daniel-streetec/open_loud/README.md

# OPEN//LOUD

Tragbarer DIY-Outdoor-Lautsprecher. Entwicklungsstand: **Vorentwurf, keine Bau- oder Sicherheitsfreigabe**.

Geprüfte Grundlage E05: Verkabelungsrechnung und modellierte Befestiger, geprüfte STEP/F3D-Rückimporte,28-seitiger CAD-Prüfzeichnungssatz. Akku-/Festivalversorgung, vollständige Anschluss-/Schutzkette, fertig bemaßte Fertigungszeichnungen und abschließende Gestaltung bleiben in Arbeit; neuester Status in docs/NEXT_SESSION.md. Die lokal bereitgestellte Forschungs-PDF wird wegen ungeklärter Weitergaberechte nicht mitgepusht. Ihr Hash ist dokumentiert, die Rechengeneratoren laufen auch ohne die PDF.

Startpunkt ist der vom Nutzer bereitgestellte [Forschungsbericht](docs/research/OPEN_LOUD_Forschungsbericht_Phase_1.pdf). Seine Empfehlungen und Zahlen sind Prüfgrundlagen. Es liegen noch keine eigenen Messungen vor.

- [Bestandsaufnahme und Anforderungen](docs/requirements.md)
- [Entwicklungsplan und Sitzungsübergabe](docs/DEVELOPMENT.md)
- [Aktueller Arbeitsplan und exakter Fortsetzungsstand](docs/NEXT_SESSION.md)
- [Verkabelung, Strom-/Querschnittsrechnung und Schrauben E05](docs/build/wiring.md)
- [Festivalversorgung im Vergleich – USB ausdrücklich optional](results/battery/comparison.md)
- [Autorisierter Wiederanlauf nach Kontingentreset](docs/automation/README.md)
- [CAD-basierter Zeichnungssatz E05: 25 Teile, Gesamtansicht, Explosion und Schraubenaufbauten](hardware/mechanical/drawings/E05/README.md)
- [Unterbaugruppen E07: Gehäuse, Front, Rückwand, Elektronik und Kabelbaum](docs/build/assemblies.md)
- [Modell und Grenzen](simulation/README.md)
- [Generierter Konzeptvergleich](results/comparison.md)
- [Quellen und Verifikation](docs/sources.md)
- [Entscheidungen und Risiken](docs/decisions.md)
- [Lizenzvorbereitung](licenses/README.md)
- [Fusion-Konstruktion E03 mit STEP/F3D und Montagefolge](hardware/mechanical/README.md)

Reproduzieren ab Repositorywurzel mit Python 3.13, ohne Zusatzpakete:

```powershell
python -m unittest discover -s tests -v
python simulation/run.py
python tools/check_outputs.py
```

Alles mit Abbruch bei Fehler und zusätzlichem Vergleich zweier Generierungsläufe: `python tools/reproduce.py`.

`data/parameters.json` ist die zentrale numerische Parameterbasis. `data/components.json` enthält Beschaffungs- und Freigabedaten. Ergebnisse sind generiert und dürfen nicht von Hand korrigiert werden. Keine Bestellung, Veröffentlichung oder Lizenzänderung wurde vorgenommen.
