daniel-streetec/open_loud/docs/sources.md

# Quellenregister und Prüfstand

E05-Ergänzungen, geprüft2026-11-09: vollständige URLs, konkrete Einkaufseinheiten, reguläre Bruttopreise und Freigabestatus stehen maschinenlesbar in `data/wiring_procurement.json` und `data/battery_study.json`. Technische Primärquellen: [Cordial CLS215](https://www.cordial-cables.com/de/produkte/cls-215), [LAPP metrische Verschraubungen](https://products.lappgroup.com/online-catalogue/cable-glands/skintop-cable-glands-plastic-metric/standard/skintop-st-m.html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), [LAPP flache Metall-Gegenmuttern](https://products.lappgroup.com/fileadmin/documents/technische_doku/datenblaetter/skindicht/DB52103000EN.pdf), WAGO-Herstellerdatenblatt [221-2411](https://www.farnell.com/datasheets/3699232.pdf) und [221-2522](https://www.farnell.com/datasheets/4592330.pdf). Händler-Spiegel sind als solche erkennbar, keine Dateien übernommen.

Batterie-Primärquellen: EREMIT-Produktseiten [6Ah](https://www.eremit.de/p/12v-6ah-lifepo4-mit-bms), [18Ah](https://www.eremit.de/p/12v-18ah-lifepo4-mit-bms), [50AhBasis](https://www.eremit.de/p/12v-50ah-lifepo4-micro-gen-7-basis-beguenstigte-pv-verwendung-0-ust) und [Lader](https://www.eremit.de/p/12v-1a-lifepo4-ladegeraet).0%-PV-Preise gelten nicht ungeprüft für Lautsprecherbau.18Ah deshalb99,90EUR und50Ah219,90EUR als reguläre Produktvarianten.6Ah-Dauerstromangaben auf derselben Seite widersprüchlich; konservativ technische Tabelle verwenden, keine Freigabe. EVE-LF32-Datenblatt-Link gefunden, noch nicht vollständig qualifiziert; keine belastbare Zellpreis-/Endkundenfreigabe behaupten.

Abrufdatum aller folgenden Webprüfungen: **2026-11-09**. Faktenauszüge, keine archivierten Herstellerdatenblätter oder CAD-Dateien. `report:pN` bezeichnet die PDF-Seite, `engineering:E01` eine ausdrücklich eigene Rechenannahme. S-Nummern entsprechen dem Bericht; nicht aufgeführte Quellen daraus bleiben ungeprüft. Webabrufe sind Momentaufnahmen ohne Bestellung/Checkout.

| ID | Primär-/Bezugsquelle | Ergebnis |
|---|---|---|
| S31 | [Faital 10FE200 4 Ohm](https://faitalpro.com/en/products/LF_Loudspeakers/product_details/index.php?id=401040101) | P/N und Re/BL/Mms/Rms/Fs/Sd/Xmax/Pn/Vas/Qts/Masse/Verdrängung für Rechnung bestätigt. Keine Herstellertoleranzen genannt. |
| S33 | [Faital 10FE300 4 Ohm](https://faitalpro.com/en/products/LF_Loudspeakers/product_details/index.php?id=401040107) | Dieselben Parametergruppen bestätigt; 94 dB, nicht 96 dB. |
| S32 | [Boomtown 10FE200](https://www.boomtownshop.de/p/faitalpro-10fe200-4-ohm) | 52 EUR brutto zzgl. Versand, auf Lager, 8–10 Tage. Händler-Lochkreisbegriff abweichend. |
| S34 | [Boomtown 10FE300](https://www.boomtownshop.de/p/faitalpro-10fe300-4-ohm) | 85,99 EUR brutto zzgl. Versand, auf Lager, 6–11 Werktage. 133-mm-Lochmaß unplausibel. |
| S48 | [B&C DE10 8 Ohm](https://www.bcspeakers.com/en/products/hf-driver/1/8/DE10) | 20 W nominal, empfohlene Trennung 2,5 kHz, 0,8 kg. Polaren im Gehäuse nicht geprüft. |
| S50 | [B&C ME10V3](https://www.bcspeakers.com/en/products/horn/1/0/ME10V3/) | 90×60 Grad nominal, 130,5×130,5×90 mm, 0,17 kg; Revisionshinweis zu Lochbild. |
| S52 | [Celestion CDX1-1445](https://celestion.com/product/cdx1-1445/) | 8 Ohm, 20 W Rating, 40 W continuous, Mindesttrennung 2200 Hz bei 12 dB/Oktave, 1 kg. |
| S59 | [Boomaudio JAB3+](https://www.boomaudio.de/wondom-jab3-tpa250-dsp-bt-endstufe) | Timeout; Werte und Preis weiterhin ausschließlich Bericht. |
| S66 | [Einhell Kit 4512042](https://www.einhell.de/p/4512042-18v-4-0ah-pxc-starter-kit-a1/) | A1-URL zeigt C1-Titel; Kit aus einem Akku und Lader, Hersteller beschreibt Management. Kein Nachweis am Fremdadapter. |
| S67 | [Pollin 502692](https://www.pollin.de/p/einhell-power-x-change-starter-kit-4512042-18v-4ah-502692) | 34,95 EUR brutto zzgl. Versand. 1–3 Tage und zugleich nicht ausreichend verfügbar: Verfügbarkeit unklar. |

Noch zu prüfen: S49 https://www.thomann.de/de/bc_de_108_ohms.htm ; S51 https://www.thomann.de/de/bc_me_10_v3.htm ; S88 https://www.thomann.de/de/celestion_cdx1_1445.htm ; S94 https://www.thomann.de/de/celestion_h1_8050.htm ; S60 https://www.boomaudio.de/wondom-icp5-programmer ; S61 https://www.boomaudio.de/media/pdf/e4/e7/ff/2-x-50-Watt-Class-D-Audio-Amplifier-Board-Integrated-with-DSP-BT-JAB3.pdf ; S62 https://www.ti.com/lit/ds/symlink/tpa3116d2.pdf ; S72 https://www.insaneware.de/p/dc-10v-32v-auf-12v-35v-10a-150w-stepup ; S73 https://www.boomaudio.de/kabelset-fuer-wondom-jab3/jab4/jab5-dsp-endstufen ; S74 https://www.hornbach.de/s/multiplex%20birke . Händlerdaten sind nur Preis-/Beschaffungsbelege, technische Werte vorzugsweise Hersteller.

Methodische Primärquellen aus Bericht, noch kein eigenständiger Volltextabgleich: [Small Kleinsignal](https://aes.org/publications/elibrary/elibrary-page/?id=1967), [Small Großsignal](https://aes.org/publications/elibrary/elibrary-page/?id=1959), [Klippel Gehäuseparameter](https://www.klippel.de/know-how/measurements/transducer-parameters/parameters-of-the-enclosure.html). Die erste Implementierung folgt ausdrücklich den Gleichungen auf PDF-Seite 8. Analytische Referenzfälle prüfen die Implementierung, ersetzen keinen externen BR-Simulator oder Messvergleich.

## Elektronik-/Beschaffungsstudie, geprüft 2026-11-09

- W04: [WONDOM-Herstellerdatenblatt AA-JA32173, Händler-Spiegel](https://doc.soundimports.nl/pdf/brands/Sure%20Electronics/AA-JA32173/AA-JA32173%20data.pdf), drei Seiten. Platine 91,44×68,6 mm, 20 mm Gesamthöhe; Lochabstände 83,8×61 mm, Bohrungen 3,6 mm. Keine Ladeschaltung. J8 versorgt; J10 enthält zwei BTL-Paare, J7 ist Line-Out. Boardrevision und Pin-1-Blickrichtung am Muster prüfen.
- W05: [LAPP DB53111000EN](https://products.lappgroup.com/fileadmin/documents/technische_doku/datenblaetter/skintop/DB53111000EN.pdf). M12-Familie: 8 mm Anschlussgewinde, 3,5–7 mm Klemmbereich. Hersteller-Packmengen nicht für Einzelbau übernehmen. Einzelverkauf bei Reichelt gefunden, aber abgerufene Region Schweiz; deutscher Bruttopreis/Versand noch nicht bestätigt. Daher keine Einkaufsfreigabe.
- W06: [Amphenol AT06-2S](https://www.amphenol-sine.com/at06-2s-2-way-plug-female-comparable-to-pn-dt06-2s_p_79.html), 13 A; Feuchteschutzangaben gelten für korrekt gesteckte Ausführung. [Schutzkappenunterlage](https://www.amphenol-industrial.de/media/pages/downloads/a-serie/392ad4ccea-1707903282/a-series-protective-caps.pdf). Kontakte, Gegenstück, Werkzeuge und Endkunden-Kleinmengen nicht vollständig qualifiziert.
- W07: [Littelfuse ATO](https://www.littelfuse.com/products/fuses-overcurrent-protection/fuses/automotive-aftermarket-products-fuses/blade-fuses-shunts-automotive-aftermarket/ato): 287 ersetzt veraltete 257-Serie. 10 A bleibt ein Prüfwert, keine freigegebene Sicherungsauslegung.
- Kaufteil-Ecken: [Adam Hall Flache Ecken](https://www.adamhall.com/shop/de/flightcase-material/ecken-l-ecken/flache-ecken) und [Penn Elcom C1539](https://www.penn-elcom.com/us/plastic-stacking-corner-c1539-series) als Hersteller-Shortlist. Keine vollständige Modell-/Endkunden-Freigabe. Ein weiterer gebündelter Händlerabruf wurde nach langem Ausbleiben beendet; daraus keine Preise oder Lieferfähigkeit übernommen.
