daniel-streetec/open_loud/hardware/mechanical/drawings/E05/README.md

# E05 CAD review drawing set

Actual edge geometry from the checked E05 model. All edges shown; hidden-line removal is NOT implemented. No dimensional/tolerance, fit, safety or manufacturing release. SVGs are scalable; print without assuming a scale.

| Pos. | Part | Qty | Material | Nominal blank mm | Review sheet |
|---:|---|---:|---|---|---|
| 1 | Side_left | 1 | birch_plywood_candidate | 560.00 x 300.00 x 12.00 | [01_Side_left.svg](01_Side_left.svg) |
| 2 | Side_right | 1 | birch_plywood_candidate | 560.00 x 300.00 x 12.00 | [02_Side_right.svg](02_Side_right.svg) |
| 3 | Bottom | 1 | birch_plywood_candidate | 306.00 x 300.00 x 12.00 | [03_Bottom.svg](03_Bottom.svg) |
| 4 | Top | 1 | birch_plywood_candidate | 306.00 x 300.00 x 12.00 | [04_Top.svg](04_Top.svg) |
| 5 | Baffle | 1 | birch_plywood_candidate | 536.00 x 306.00 x 12.00 | [05_Baffle.svg](05_Baffle.svg) |
| 6 | Rear_removable | 1 | birch_plywood_candidate | 536.00 x 306.00 x 12.00 | [06_Rear_removable.svg](06_Rear_removable.svg) |
| 7 | Baffle_inner_lamination | 1 | birch_plywood_candidate | 536.00 x 306.00 x 12.00 | [07_Baffle_inner_lamination.svg](07_Baffle_inner_lamination.svg) |
| 8 | LF_steel_backing_ring_candidate | 1 | steel_candidate | 280.00 x 280.00 x 3.00 | [08_LF_steel_backing_ring_candidate.svg](08_LF_steel_backing_ring_candidate.svg) |
| 9 | Rear_cleat_left | 1 | birch_plywood_candidate | 536.00 x 20.00 x 20.00 | [09_Rear_cleat_left.svg](09_Rear_cleat_left.svg) |
| 10 | Rear_cleat_right | 1 | birch_plywood_candidate | 536.00 x 20.00 x 20.00 | [10_Rear_cleat_right.svg](10_Rear_cleat_right.svg) |
| 11 | Rear_cleat_bottom | 1 | birch_plywood_candidate | 266.00 x 20.00 x 20.00 | [11_Rear_cleat_bottom.svg](11_Rear_cleat_bottom.svg) |
| 12 | Rear_cleat_top | 1 | birch_plywood_candidate | 266.00 x 20.00 x 20.00 | [12_Rear_cleat_top.svg](12_Rear_cleat_top.svg) |
| 13 | Service_partition | 1 | birch_plywood_candidate | 306.00 x 186.00 x 12.00 | [13_Service_partition.svg](13_Service_partition.svg) |
| 14 | Service_floor | 1 | birch_plywood_candidate | 306.00 x 122.10 x 12.00 | [14_Service_floor.svg](14_Service_floor.svg) |
| 15 | Brace_lower | 1 | birch_plywood_candidate | 306.00 x 20.00 x 12.00 | [15_Brace_lower.svg](15_Brace_lower.svg) |
| 16 | Rear_thread_plate_left_0.15 | 1 | steel_candidate | 40.00 x 20.00 x 5.00 | [16_Rear_thread_plate_left_0.15.svg](16_Rear_thread_plate_left_0.15.svg) |
| 17 | Rear_thread_plate_left_0.5 | 1 | steel_candidate | 40.00 x 20.00 x 5.00 | [17_Rear_thread_plate_left_0.5.svg](17_Rear_thread_plate_left_0.5.svg) |
| 18 | Rear_thread_plate_left_0.85 | 1 | steel_candidate | 40.00 x 20.00 x 5.00 | [18_Rear_thread_plate_left_0.85.svg](18_Rear_thread_plate_left_0.85.svg) |
| 19 | Rear_thread_plate_right_0.15 | 1 | steel_candidate | 40.00 x 20.00 x 5.00 | [19_Rear_thread_plate_right_0.15.svg](19_Rear_thread_plate_right_0.15.svg) |
| 20 | Rear_thread_plate_right_0.5 | 1 | steel_candidate | 40.00 x 20.00 x 5.00 | [20_Rear_thread_plate_right_0.5.svg](20_Rear_thread_plate_right_0.5.svg) |
| 21 | Rear_thread_plate_right_0.85 | 1 | steel_candidate | 40.00 x 20.00 x 5.00 | [21_Rear_thread_plate_right_0.85.svg](21_Rear_thread_plate_right_0.85.svg) |
| 22 | Rear_thread_plate_bottom_0.27 | 1 | steel_candidate | 40.00 x 20.00 x 5.00 | [22_Rear_thread_plate_bottom_0.27.svg](22_Rear_thread_plate_bottom_0.27.svg) |
| 23 | Rear_thread_plate_bottom_0.73 | 1 | steel_candidate | 40.00 x 20.00 x 5.00 | [23_Rear_thread_plate_bottom_0.73.svg](23_Rear_thread_plate_bottom_0.73.svg) |
| 24 | Rear_thread_plate_top_0.27 | 1 | steel_candidate | 40.00 x 20.00 x 5.00 | [24_Rear_thread_plate_top_0.27.svg](24_Rear_thread_plate_top_0.27.svg) |
| 25 | Rear_thread_plate_top_0.73 | 1 | steel_candidate | 40.00 x 20.00 x 5.00 | [25_Rear_thread_plate_top_0.73.svg](25_Rear_thread_plate_top_0.73.svg) |

Assemblies: [orthographic](assembly_orthographic.svg), [exploded](assembly_exploded.svg), [fastener stacks](fastener_stacks.svg).
