daniel-streetec/open_loud/docs/NEXT_SESSION.md

## E09 – neuer geprüfter CAD-Zwischenstand, 2026-11-10

Aktives Fusion-Dokument `OPEN_LOUD_A0_E09_PowerSystem`; E08 separat erhalten und wegen blockiertem Akku-Auszug gesperrt. **E09-Eingaben sind `data/experiments/E09_parameters.json`**. `data/parameters.json` bleibt bewusst E08-Referenz. Nicht beide vermischen oder E09 durch unbedachtes Aufrufen alter Skripte überschreiben. Details/Befehle in `docs/build/E09_status.md`.

E09: aufrechter Akku90° gedreht,22mm angehoben, neue echte Bodenauflagen und rechte Kammerwand, Dach240mm, Träger180×102mm, angepasste Leitungen/Durchführungen und interner Ladehalter.228 Teile in22 geprüften Gruppen,8 Hauptgruppen. Durchgehender konservativer Akku-Box-Sweep227mm inklusive Pad, Polreserve14mm und2mm Zugaben an freien Flächen bestanden; untere Padfläche ist Auflagedatum. Statische Kernelprüfung0 Treffer/Fehler, native/STEP-Rückimporte einschließlich nativer Hierarchie bestanden. Dies ist kein Nachweis für reale, noch unvermessenene Pole/Stecker/Griffe. Alte Teil-/Gehäuseexporte im E09-Ordner sind Vorgeschichte; `*_checkpoint.f3d/step` ist der vollständige aktuelle Stand.

20 Tests bestanden; Zahlenreproduktion doppelt byte-identisch. E09-Versorgung berücksichtigt warme Kabel/Kontakte, hypothetischen Verpolschutzverlust, LF-Re-Sensitivität und HF-Mindestimpedanz. Vorläufig LF10,5/HF10Vrms, nicht aufgespielte DSP-Ziele; Wandlerreserve≈10,35%, etwa23W Wandlerwärme plus konservativ32W Verstärkerwärme. Geschlossene Holzkammer thermisch nicht qualifiziert. Offline-DSP40HzBW4 +2,5kHzLR4: nominal3,14mm Hub,8,87m/s Port,F6≈61Hz; keine akustische HF-Abstimmung/Messung. Echte PNG/SVG/PDF-Plots in results/dsp/E09 wurden zweimal byte-identisch gerendert, PDF und Bild geprüft. Optionale Toolversionen unter tools/requirements-visual.txt.

**Massenproblem:** bereits 18.44–20.10kg für Holz+Akku+LF+HF+Horn+Wandler; Stahl, Kabel, Gitter, Trage-/Schutzteile/Lack fehlen. Frühe10kg/300EUR werden verfehlt. Nicht als fertiges tragbares Produkt ausgeben. Leichtes außenverleimtes Sperrholz/Hybridbau und Größen-/Energievergleich gezielt prüfen, ohne Reststege oder Montagestellen zu schwächen.

Nächste konstruktive Priorität: tatsächliche lösbare Batterie-Pigtails mit packnaher Sicherung/Polschutz und greifbarer Trennstelle. XT90S-Paar von AMASS für4,05EUR/1–2Tage endkundentauglich verifiziert, noch nicht modelliert. M6-Ringösen nicht erst unter dem engen Dach abschrauben müssen. Reale Klemmenhalter, Zugentlastungen, Sicherungshalterfixierung, Gurtanker und Horn-/Treiberbefestigung ergänzen. Pololu5389 noch nicht eingebaut; Schalter und thermischer Pfad offen. Fertige AdamHall4072-Ecken als Endkundenkandidat dokumentiert, noch keine Bohrungen/Radiusänderung ohne geprüfte Zeichnung. Quellen/Angebote in data/procurement_E09_additions.json und docs/build/service_connections_E09.md.

Wichtig aus dieser Sitzung: verschachtelte Occurrence-Proxys ließen beim Löschen alte Instanzen stehen; korrekt über nativeObject löschen und Rückgabewert prüfen. Ein suffigiertes altes XT60-Teil wurde zusätzlich entfernt. Finale228-Teile-/Eigentums-/Kollisionsprüfung ist danach bestanden. Neue Baugruppenänderungen bewusst rekursiv ausführen; alte flache Mutatoren nicht blind wiederholen. Kein Scheduler, keine unautorisierte Lizenzänderung/Bestellung; weitere selbstständige Entwicklung und Push sind beauftragt.

## E08 – Montagehalter und Baugruppen geprüft, 2026-11-10

**Neu erkannter Montageblocker:** Der echte E08-Akku stößt beim geraden Wartungsauszug schon bei5mm an feste Gewindeplatten. Bericht `exports/E08/battery_service_validation.json`. E08 deshalb nicht fertigen. E09-Vorschlag in `data/experiments/E09_packaging.json`: aufrecht um90° gedrehter,22mm angehobener Akku, angepasste Kammer/Plattform/Träger und verlegte Durchführungen. Temporärer Kernelversuch mit2mm zusätzlichem Hüllraum pro Fläche und14mm Polreserve:46 Positionen bis225mm Auszug ohne Treffer (`results/service/E09_battery_service_study.json`). Dies ist eine geprüfte Studie, noch kein gebautes E09-CAD. Als Nächstes vollständig umsetzen, dann sämtliche Anschluss-/Montageprüfungen wiederholen. Kein bloßes Null-Kollisions-Ergebnis mit Montierbarkeit verwechseln.

Neuester Stand ersetzt die unmittelbar folgenden historischen E08-Notizen: Ladebuchsenhalter mit M3-Durchsteckmontage ergänzt, dazu bemaßtes eigenes PDF/SVG-Prüfblatt. Offizielles Orion-STEP lokal importiert, 2-mm-Montageohren und vier freie Ø8-mm-Werkzeugräume geprüft. Daraus eigene konservative Hülle korrigiert; keine fremden Solids publiziert. `data/verification/orion_mount.json` und `licenses/external_material_E08.json` enthalten Herkunft/Hash und Umfang.

225 Teile in22 eindeutig geprüften Gruppen; Einzelvolumina/Platzierungen unverändert. Acht Hauptgruppen einschließlich Akku und externem Ladegerät. BG43-Wandler ist unabhängig von BG41/BG42-Träger zu warten. Aktuelle Kernelprüfung nach Reparenting:0 Überschneidungen im dokumentierten Umfang,0 Kernel-/Timelinefehler; keine vollständige Montierbarkeits- oder Produktfreigabe. F3D-/STEP-Rückimporte bestanden und Fusion gespeichert. Neuaufbau-/Prüfreihenfolge in `docs/build/E08_reproduction.md`; flache Ergänzungsskripte nach Gruppierung nicht blind erneut aufrufen.

17 Rechentests und doppelte byte-identische Reproduktion bestanden. CAD-basierte Modell-BOM erzeugt:65 Positionen,58 Einheitskosten offen; keine vollständige Einkaufsliste. Wichtiger Zielkonflikt:17,02–18,60kg bereits für Holz/Akku/LF/Wandler, weitere Teile fehlen. Noch keine bestätigte leichte Holzplatte auswählen; Vergleich in `docs/build/material_mass_E08.md`. Vier Versorgungskaufteile bereits338,02EUR ohne Versand und Restprodukt. Frühe10kg/300EUR nicht erfüllt.

Prioritäten weiter selbstständig abarbeiten: reale Klemmenhalter/Zugentlastungen, Sicherungshalterbefestigung, Gurtanker, Polabdeckungen und vollständige Anschlussstellen; passende Schutz-/Schaltkette und Kühlung. Pololu5389 ist neue technische Verpolschutzvorauswahl, noch nicht eingebaut. EXP-Tech/Botland.store als geprüfte B2B-Quellen ausgeschlossen; Eckstein-Angebot mit Lieferlandhinweis noch verifizieren. Danach Material-/Massenoptimierung mit belastbaren Reststegen und Montagestellen, Kabelschlaufen/Extraktion, vollständige BOM/Zeichnungen/Explosionen und Akustik-/DSP-Absicherung. Alte Berichte bleiben historische Entwicklungsnachweise. Kein Scheduler aktivieren, keine neue Lizenz festlegen; weitere Arbeit und Push sind beauftragt.

## E08 – laufende Versorgungskonstruktion, 2026-11-10

E07 bleibt Rückfallbasis. Aktives Fusion-Dokument `OPEN_LOUD_A0_E08_PowerSystem` hat Akku/BMS-Hüllmodell, abgetrennte Batteriekammer, Orion-Wandler mit M3-Gegenstücken, externes Ladegerät, internen Ladeanschluss, Sicherungshalter, erweiterten Elektronikträger und fünf berechnete Kabelwege. Kein selbstgebauter Verstärker: WONDOM AA-JA32173. Details `docs/build/power_E08.md` und `data/procurement_E08.json`.

Ausgeführt: Aufbau Gehäuse/Rückwand/Schrauben → `add_power_e08.py` → `add_electronics_e08.py` → `add_harness_e08.py` → `refine_power_e08.py`. Geometrische Nacharbeit ist im letzten Skript enthalten. Zentraldaten vor Berechnungen mit `tools/refine_e08_packaging.py` aktualisiert. `python -B tools/reproduce.py`: 17 Tests bestanden und generierte Rechenergebnisse zweimal byte-identisch. Leistungs-/Laufzeitrechnung und 12 hypothetische Spannungseinbruchfälle unter `results/power/E08/`. Hypothetische Packwiderstände sind keine Herstellerdaten.

CAD-Prüfung `verify_power_e08.py` schreibt tatsächliche Kernelüberschneidungen nach `exports/E08/power_validation.json`, nicht als Erfolg umdeuten. STEP/F3D heißen bewusst `checkpoint`; noch kein E08-Rückimportnachweis. Alte `OPEN_LOUD_A0_E08.*` sind nur Gehäuse-Zwischenstand, nicht vollständiger Elektronikausbau. `view_power_e08.py` erzeugt aktuelle Schnittansicht und Austauschdateien. E08 ist derzeit noch flach; E07-Baugruppengliederung nach Ergänzung der Teile übertragen.

Weiterarbeiten, nicht auf Rückfrage warten: verbliebene Wandler-Hüllkonflikte an Montageohren anhand Primärzeichnung klären; reale Klemmenhalter, Kabelschellen, Gurtanker, Ladebuchsenhalter und Sicherungsbefestigung ergänzen; vollständige Anschlusskette mit Verpolschutz/Schalter qualifizieren. Pololu2815 wegen nur6Abei55°C nicht freigegeben. Akku-Polkoordinaten, WAGO-Halterlochpositionen, Kühlung (~20W konservative Wandlerwärme), Sicherungs-Abschaltvermögen und Leitungsdaten offen. Danach Montageauszug, Baugruppenhierarchie, Rückimporte, BOM/Zeichnungen/Explosionen/akustische Absicherung. Nicht fertig behaupten; kein Scheduler aktivieren. User will kontinuierliche eigenständige Bearbeitung und Push.

# Auftrag, Arbeitsplan und Fortsetzung

## Neuester Übergabestand (überschreibt historische Angaben weiter unten)

**E07-Abschluss dieser Etappe:** vollständiger nativer Rückimport inklusive aller183Occurrence-Pfade/71Parameter sowie Gesamt-STEP und fünf einzelne Baugruppen-STEPs bestanden; Fusion-Dokument OPEN_LOUD_A0_E07_Assemblies gespeichert. Stücklistenstruktur55aggregierte Modellpositionen aus168Komponenten, zwei nichtphysische Referenzen ausgeschlossen. Fünf isolierte CAD-Ansichten erzeugt, Elektronikansicht visuell geprüft.16Tests und Reproduktion bestanden. E07-Geometrie ist gegenüber E06 unverändert, weder neue Schutzteile noch fertige Anschluss-/Akkukonstruktion hinzugefügt. Nächste Arbeit weiterhin Versorgung und konkret montierte Klemmen/Clips/Anschlüsse innerhalb der neuen Unterbaugruppen; alte flache Generatoren nicht gegen E07 laufen lassen.

**2026-11-10 abends: Nutzer hat die Arbeit wieder aufgenommen und echte Unterbaugruppen verlangt. Automatik bleibt gestoppt.** E06 gesichtet, Rechenreproduktion erfolgreich. E07 separat aus E06_PAUSED importiert;168vorhandene Komponenten vollständig nach `data/assembly_structure.json` in sechs Hauptgruppen und funktionale Untergruppen umgeordnet.247native Körper, Volumen/Lage/Parametermenge unverändert, native Breitenänderung10mm funktioniert nach Umordnen und wurde zurückgesetzt. Hierarchie-/BOM-Unterlagen in hardware/mechanical/exports/E07/ und docs/build/assemblies.md. STEP hat245physische Körper, zusätzlich zwei nichtphysische/ausgeblendete Reserven nur im nativen Modell; keine stillschweigende Körperzählungsabweichung. Aktuellen Abschlussstatus der Rückimporte aus exports/E07/export_validation.json lesen. Noch keine neue Produkt-/Montage-/Wetterfreigabe. Keine Automatisierung neu starten.

**PAUSIERT auf Nutzerwunsch 2026-11-10 ca.06:10MEZ; Fortsetzung heute Abend.** Keine weitere automatische Entwicklung starten. STOP-Datei unter .tools/overnight gesetzt, Supervisor PID2216 und dessen CLI-Kind13836 beendet, Fortsetzungsthread01a1c3d4-c08a-79a3-bfc1-8ad6f7ac9489 archiviert. Root-Unterhaltung bleibt bestehen. Automatik nicht selbstständig wieder aktivieren.

Beim Sichern tatsächlich vorhandener neuer Arbeitsstand E06: geänderte zentrale Parametergruppe electronics_mount, Elektronikträger-/PCB-Befestigungsmodelle mit Schraubengegenstücken, E06STEP/F3D/DXFs, lokale Mount-Kernelprüfung ohne gemeldete Kollision/Timelinefehler sowie neue supply_acoustics-Rechnung.14Python-Tests zum Sicherungszeitpunkt bestanden. **Noch keine unabhängige Gesamtprüfung oder E06STEP/F3D-Rückimportprüfung**; E06 ist WIP, E05 bleibt letzter vollständig rückimportgeprüfter Stand. Heute Abend zuerst neue E06-Dateien, Quellen, Parameterdiff und Geometrie-/Ausbaubedingungen prüfen. Neue Ergebnisse nicht stillschweigend als freigegebene Produktauslegung behandeln. Der korrigierte Fork hatte nach06:01 tatsächlich Dateien erzeugt, obwohl sein CLI-Ausgabelog leer blieb; die frühere Fehlermeldung betrifft den03:38-Lauf.

**2026-11-10, etwa06:00MEZ: Nachtlauf fehlgeschlagen, kein Produktfortschritt seit6f2258c.** Start03:38 scheiterte sofort mit `already has an active writer`; ursprüngliche Oberfläche behielt Writer-Reservierung. Nicht als Quotalimit erkannt, Supervisor beendete sich. Ursache und Korrektur in docs/automation/README.md. Supervisor auf separate Fortsetzung `codex exec fork` umgestellt; echter minimaler read-only/ephemeral-Modellstart mit erwarteter Antwort/Exit0 bestanden. Die frühere Aussage „Nachtlauf wartet/läuft“ beschreibt den damaligen Supervisor, nicht erfolgreiche Engineeringarbeit. Weitere Arbeit konkret an Akku/Schutzkette und montagefähiger Elektronik fortsetzen, nicht erneut nur Automatisierung bearbeiten. Keine weiteren rekursiven Supervisorstarts im fortgesetzten Engineeringlauf.

Git gesichert und nach origin/main gepusht: technischer E05-Stand `82c6a62`, anschließend Reproduktionskorrektur `32af869`. Tatsächlicher Test aus frischem Git-Archiv (ohne private Forschungs-PDF/Herstellerdownloads):13Tests und vollständige doppelte Akustik-/Wiring-/BOM-/Festivalgenerierung bestanden, Ergebnisse byteidentisch. `data/research_reference.json` bewahrt Original-PDF-Hash/Weitergabestatus; PDF wird nur optional lokal hashgeprüft. Arbeitskopie vor Fortsetzung erneut prüfen. Die weiter unten erwähnten untracked/ungepushten Stände sind historische Angaben.

Zusätzlich erzeugt und tatsächlich geprüft: `hardware/mechanical/drawings/E05/OPEN_LOUD_E05_review_drawings.pdf` mit28Seiten (25Einzelteil-Prüfblätter, orthografische Gesamtansicht, schattierte native Explosion, Schrauben-Klemmpakete). Alle28SVGs als XML geparst, PDF-Seitenzahl und Text geprüft, Explosionsblatt visuell betrachtet. Keine vollständigen Bohrungs-/Toleranzbemaßungen, keine Fertigungsfreigabe; entsprechende Zeichnungsarbeit bleibt offen. Quelle eigene native E05-Kanten und Tessellierung, keine KI-erfundenen CAD-Details. Reproduktionsgeneratoren tools/generate_review_drawings.py und render_drawing_pdf.py, Geometrieexportskripte unter hardware/mechanical/.

E05 repariert und geprüft: keine Kabelkollisionen, keine Timelinefehler, alle8LF-Muttern-Korridore mit Gelenkwerkzeug bestanden.204Volumenkörper. STEP- und F3D-Rückimport tatsächlich bestanden; native71Parameter erhalten. Fusion-Dokument `OPEN_LOUD_A0_E05_WiringFasteners` erfolgreich gespeichert. Exporte einschließlich vier Durchführungs-DXFs und Ansichten unter hardware/mechanical/exports/E05/. Reparatur `repair_wiring_e05.py` dokumentiert die falsche Y-Ebene im ersten Versuch; korrigierter Erstgenerator verwendet jetzt ebenfalls +Y. Vor einem Neulauf eigene Dokumente prüfen, nichts duplizieren.

Aktueller Kabelzuschnitt250/460/350mm, zusammen1,06m/83,74g.13Python-Tests bestanden einschließlich Wiederanlauf-Supervisor; Reproduktion nach den neuesten Änderungen erneut laufen lassen. E05-Klemmen/Clips/Schlaufen/Originalkontakte sind noch NICHT komplett konstruiert. Kein Gesamtmontage-/Elektro-/Wetterfreigabenachweis. Schraubenanzahlen bleiben42/34Scheiben/12Muttern plus zwei Durchführungsmuttern.

Neueste Nutzersteuerung: ernsthaftes Engineering bis zum Morgen, Commit UND Push ausdrücklich beauftragt. Keine metrischen Schrauben ohne Holz-Gegenstück. Versorgung neu bewerten,4Ah-Werkzeugakku nicht mehr bevorzugt, Bosch Pro nicht bevorzugt. Vorherige andere Box schafft Mittwoch–Sonntag mit12V/100Ah-LFP plus Handyladen; **Handyladen ist KEINE Anforderung** für OPEN//LOUD. Kein unbekanntes Musiknutzungsprofil aus dem Erfahrungsbericht erfinden. Daten und ausführbare Gegenrechnung in data/battery_study.json, tools/compare_festival_energy.py und results/battery/.50Ah-Fertigpack braucht wegen130mm kleinster Abmessung eine andere Unterbringung als den110mm tiefen aktuellen Elektronikraum.6S-LFP mit prismatischen Zellen bleibt ungeprüftes Vergleichskonzept, keine freigegebene Auswahl.

Autorisiertes Wiederanlaufskript `tools/resume_after_reset.py` erstellt, getestet und als versteckter Prozess gestartet. Lokale PID/Status in .tools/overnight/; Startfenster ab2026-11-10 03:38:39 MEZ bis08:00MEZ. Wartet außerdem auf beendeten aktuellen Turn und ready.json. **KEINEN zweiten Supervisor starten.** Fortsetzungsauftrag docs/automation/continue_prompt.md. Der tatsächliche nächtliche Codexlauf ist noch nicht erfolgt; nur Supervisor-Start und Dry-Run sind nachgewiesen. STOP-Datei stoppt weitere Starts. Bisherige gegenteilige Angabe unten („nicht eingerichtet“) ist historisch überholt.

Aktualisiert 2026-11-09, E05 in Arbeit. Nutzer möchte bis zum nächsten Morgen ein vollständiges, nachvollziehbares Entwicklungspaket mit montagegerechtem Produktentwurf, Explosionsdarstellungen, Baugruppen-/Einzelteilzeichnungen, Einkaufsliste mit Preisen, Frequenzgangberechnungen und ein bis zwei guten Renderbildern. Autonom weiterarbeiten; reversible Entscheidungen selbst treffen. Kein fertiges/validiertes Serienprodukt behaupten: reale Messungen, Sicherheit und Wetterbeständigkeit sind weiterhin offen.

## Verbindliche Gestaltung und Beschaffung

- Qualitätsgewinn darf Mehrgewicht rechtfertigen. Keine dünnen Stege ohne Festigkeits-/Montageprüfung. Bevorzugt Multiplex statt MDF für diesen Outdoor-Vorentwurf.
- Keine Panzeroptik, selbstgebauten Blechecken, umlaufende schwere Schutzschienen, große Porthaube oder seitlichen Anschlusskasten des verworfenen E04 wieder einführen. Kaufteil-Kantenschutz/Ecken auswählen und dezent integrieren. Gute Renderbilder erst vom bereinigten, plausibel montierbaren Entwurf.
- Endkundenbezug DE/EU in Einzelstück/Kleinmenge. Artikelnummer, Preisdatum, Brutto, Versand, Mindestmenge und Lagerbeobachtung getrennt erfassen. B2B-only und 100er-Pack als vermeintlichen Einzelkauf verwerfen. Unsichere Händlerfreigaben nicht beschönigen.
- **Jede metrische Schraube braucht ein definiertes Gegenstück:** Mutter, Gewindeplatte oder passende geprüfte Gewindemuffe/Einschlagmutter. Niemals metrisches Gewinde unmittelbar ins Holz unterstellen. Holzschrauben sind eine eigene, entsprechend auszulegende Alternative. In CAD, BOM und Montagezeichnung Gegenstück und Eingriff belegen. Schraubenlänge inklusive Scheiben, Dichtungen, Kopfauflage, Toleranzen und Zugänglichkeit prüfen.

## Reihenfolge und überprüfbare Ergebnisse

| Schritt | Arbeit | Ergebnis / Prüftor |
|---|---|---|
| 1 | E05-Kabel-/Durchführungsfehler beheben | `assembly_validation.json`: keine Kabelkollisionen, keine Timelinefehler; tatsächlicher STEP-/F3D-Rückimport; E05 separat speichern |
| 2 | Elektrische Architektur vollständig auswählen | konkrete Akkuhalter-/Adapterlösung mit Schutzinterface, Sicherung/Halter, DC-Schalter, Verpolschutz/UVLO, Originalpigtails und Treiberkontakte; keine unbekannten Module als freigegeben ausgeben |
| 3 | Steck-/Klemmenstellen, Halter, Clips und Wartungsschlaufen konstruieren | vollständiger Stromlauf-/Verdrahtungsplan, Polbezeichnungen und Pinansichten, Kabelzuschnitt aus realer Geometrie, Querschnitts-/Temperatur-/Spannungsfallnachweis; WAGO-/OEM-Verbindungen im CAD mit Befestigung |
| 4 | Befestigungen/Passungen schließen | jedes Schraubengegenstück modelliert; LF-Korb gegen 24mm-Baffle und Gegenring, Hornmutternzugang, Boardhalter/Standoffs, Akkuentnahme und Rückwand-Service tatsächlich geometrisch prüfen; Standardteile bevorzugen |
| 5 | Äußere Gestaltung und Schutz integrieren | erhältliche fertige Ecken/Füße/Griff und akustisch geeignetes Gitter, moderate Radien, abgedichtete Fugen, Wartung ohne Zerstörung, nachvollziehbarer Wärmeweg. Kein IP-/Sturz-/Traglastversprechen ohne Nachweis |
| 6 | Akustik/Elektrik aktualisieren | frequenzabhängig SPL/Hub/Port/Spannung/Leistung, A0/A1-Vergleich und Annahmen, Toleranzen, veränderte Verdrängungen; unabhängige Referenzfälle. LF-Berechnung ausdrücklich nicht als vollständigen gemessenen Zweiwege-Frequenzgang ausgeben; HF-/Polaren-/Crossoverdaten und Messbedarf zeigen |
| 7 | Zeichnungssatz erstellen | Gesamt-Explosion mit Positionsnummern, Baugruppen Gehäuse/Front/Elektronik/Kabel/Akku, jedes Fertigungsteil mit Maßen/Bohrungen/Toleranzen/Material/Oberfläche; PDF/SVG plus DXF/STEP/F3D. Keine reine Perspektive als Fertigungszeichnung ausgeben |
| 8 | Einkaufsliste abschließen | automatisch aus strukturierten Quellen: installierte Menge/Einkaufsmenge/Rest, Hersteller/PN/Alternative/Status, Brutto/Versand/Stand; Schrauben, Hülsen, Scheiben, Muttern, Klemmen, Stecker, Kontakte, Kabel, Sicherungen, Dichtungen, Kleber, Finish enthalten; unbekannte Preise bleiben null |
| 9 | Montage-/Prüfunterlagen und Lizenzinventar | Montagefolge mit Werkzeug/Anzugskonzept, Abnahmewerte, bekannte Restrisiken und Freigabesperren; Hardware/Software/Doku-Lizenzoptionen separat, LICENSE nicht ungefragt ändern, keine fremden CAD/Datenblätter veröffentlichen |
| 10 | Darstellung und Reproduzierbarkeit | ein bis zwei ansprechende CAD-basierte Renderbilder des tatsächlichen Stands, Explosionen und Preis-/Leistungsübersicht; Generatoren, Versionen, Quellenhashes, Prüfberichte; Übergabe mit offenen Messaufgaben |

## Historischer Stand beim Anlegen dieses Plans

E03 ist der geprüfte Rückfallstand; nicht überschreiben. E05 ist ein separates offenes Fusion-Dokument `OPEN_LOUD_A0_E05_WiringFasteners`, noch nicht cloudgespeichert und noch nicht exportiert. Generator `hardware/mechanical/build_wiring_e05.py` lief erfolgreich: 95 zusätzliche Komponenten, darunter 42 Schrauben, 34 Scheiben, 12 Muttern, zwei Durchführungen und drei Kabelmäntel. Baseline weiterhin 330×560×300mm; Konstruktion noch eckiger Vorentwurf.

Elektrische Näherungsrechnung ausgeführt: Versorgung6A, LF4Arms, HF2,1Arms, jeweils2×1,5mm². Zuschnitt250/460/330mm, zusammen1,04m. Annahmen, Modellgrenzen und Originalpigtail-Bottleneck in `docs/build/wiring.md`. Elf Python-Tests bestehen. `results/wiring/harness.csv`, `calculation.json`, `bom.csv/json` vorhanden. BOM ausdrücklich nur E05-Ergänzung, noch keine vollständige Produktbestellliste.

**Tatsächlich fehlgeschlagene E05-Prüfung:** `hardware/mechanical/exports/E05/assembly_validation.json` enthält Kabelkollisionen (DC gegen LF-Verschraubung, LF gegen Wartungsboden, HF gegen HF-Verschraubung) und zwei fehlgeschlagene Schnitte `Extrusion6/7`. Diese beheben, nicht ignorieren. Alle acht LF-Muttern-Werkzeugkorridore mit angenommener Gelenkverlängerung≤25° bestanden; vier direkte Wege sind blockiert. Kein physischer Montagebeweis. Durchführungen und Kabelenden sind vereinfachte/ungeprüfte Maßreferenzen, keine komplette Anschlusskonstruktion.

Auslegung berücksichtigt für M16 eine3mm-Metallmutter, keine5mm-Kunststoffmutter. Herstellerreferenz LAPP52103010 / aktuelle LF-Variante prüfen, Endkundenquelle noch offen. 53017210-Durchführung:2,2015EUR brutto/45Stück Lager bei Bürklin beobachtet, aber Privatkundenberechtigung nicht vollständig verifiziert; deshalb nicht als Einkauf freigegeben. Best4Automation ausdrücklich B2B-only, Conrad100er-Pack verworfen. Cordial CLS215 als Meterware1,59EUR/m, Schrauben einzeln bei NormReich mit3,90EUR Versand/Bestellung nachgewiesen. WAGO221-2411 als5er-Pack bei Galaxus; schraubbarer Zweifachhalter221-2522 Kandidat.

## Werkzeuge und Besonderheiten

PowerShell, Python3.13.7, lokaler Fusion-MCP `http://127.0.0.1:27182/mcp`, Health `/health`. `tools/fusion_bridge.py` verwendet HTTP-JSON-RPC, `run`/`inspect` mit Dateipfad. Fusion-Skripte definieren `run(_context: str)`. Keine fremden Dokumente schließen. Vor Skriptaufrufen muss Fusion außerhalb eines offenen Kontextmenüs/aktiven Befehls sein: ein Aufruf wartete180s, danach Timeout; nach Schließen des Kontextmenüs funktionierte ein gleicher Prüfaufruf in8s. Ein Timeout ist kein Erfolgsnachweis.

Aktuelle Skripte: `build_wiring_e05.py`, `verify_wiring_e05.py`, `inspect_wiring_cuts_e05.py`. Letzter Inspektionsversuch scheiterte an nicht existierender API `Sketch.zDirection` (entfernen/Normal aus transform ableiten). Scoped Extrusioncuts: niemals `addSimple(Cut)` über Nachbarkomponenten; explizite `participantBodies`. Frühere Reparatur als Muster in `repair_cut_scope_e03.py`. Änderungen bestehender Features können Timeline-Cacheproblem auslösen: gezielt eigene Schnitte löschen und neu erstellen, dann Gesundheit prüfen.

`python -B tools/reproduce.py` jetzt einschließlich Wiringgenerator/BOM und rekursiver Ergebnis-Hashprüfung. Vor jedem „bestanden“ tatsächlichen Lauf prüfen. Kein Git-Commit bisher; Dateien sind vorhanden, überwiegend untracked. Git braucht hier `git -c safe.directory=C:/Repositories/open_loud ...`.

Nicht `tools/setup_wiring_e05.py` erneut ausführen, nachdem Eingaben geändert wurden; dieses einmalige Initialisierungswerkzeug würde die autorisierten Werte zurücksetzen. `data/parameters.json` ist die zentrale Eingabe. Neue Sitzung beginnt mit diesem Dokument, `docs/DEVELOPMENT.md`, den Projektanweisungen und `hardware/mechanical/README.md`; Forschungsbericht wurde zuvor vollständig gelesen, bleibt kritisch zu prüfende Grundlage.

## Laufzeitgrenze

Ein API-/Nutzungslimit oder beendeter Turn startet nicht allein durch Zeitablauf automatisch neu. Kein Hintergrundlauf/Termin wurde eingerichtet. Fortschritt deshalb in Dateien sichern; bei erneuter Sitzung anhand dieses Dokuments weiterarbeiten. Fertige Dateien/Exportprüfungen und offene Aufgaben jeweils konkret nachführen.
