daniel-streetec/open_loud/docs/review_E04_rejected.md

# E04-Außenversuch zurückgenommen – 2026-11-09

Nutzer lehnt die überladene Außenkonstruktion ab: selbst aufgebaute Ecken/Leisten, große Front-Spritzhaube und klobige seitliche Kabelabdeckung. Der unsaved E04-Entwurf wurde ausschließlich lokal unter .tools/rejected archiviert und aus Fusion geschlossen. Sichtbare Basis ist wieder OPEN_LOUD_A0_E03_Concept. Die zentrale Parameterdatei ist auf den identischen SHA256-Stand des geprüften E03 zurückgestellt. Der E04-Generator ist gegen erneute Ausführung gesperrt.

Aufbewahrte Studie: data/experiments/e04_rejected_parameters.json. Ihre Prüfberichte sind kein Freigabenachweis für einen aktuellen Lautsprecher. Zwei Kabelkollisionen und ein Timelinefehler waren noch offen. Keine E04-Bauunterlagen oder Preise als freigegeben verwenden.

Weiter nutzbare Erkenntnisse: vier LF-Positionen haben im Modell blockierten geraden Werkzeugzugang; die getesteten Gelenkverlängerungen umgehen diese Hindernisse innerhalb des angenommenen Werkzeugwinkels. Nominale Front-Werkzeugwege für Horn und Rückwand sowie diskrete Auszugsschritte für Rückwand und Elektronikträger wurden getestet. Das sind CAD-Korridorprüfungen mit angenommenen Werkzeuggrößen, keine reale Montageprüfung.

Die Herstellerunterlage AA-JA32173 bestätigt fehlende Ladeschaltung und liefert Platinenmaße/Lochbild. 8mm Anschlussgewinde einer geprüften M12-Verschraubung reicht nicht durch 12mm Holz plus Dichtung und Mutter. Beide Erkenntnisse sind relevant; die daraus gebauten massiven Außenanbauten sind verworfen.

Nächster Schritt: Kaufteil-Ecken und einen unauffälligen, privat beschaffbaren Standardanschluss auswählen. Nur genaue Herstellergeometrie oder saubere Maßableitung zeigen; erst nach Abgleich von Einbauradius, Lochlage, Materialstärke und Rückwandzugang einsetzen. Spritzwasseranforderungen über eine konsistente Dichtungs-/Oberflächen-/Abdeckstrategie bearbeiten, keine ungeprüfte Haube vor den Port setzen. In kleinen, visuell und technisch prüfbaren Änderungen vorgehen.
