daniel-streetec/open_loud/docs/automation/continue_prompt.md

Setze die vom Nutzer ausdrücklich autorisierte OPEN//LOUD-Entwicklung im Repository fort. Lies zuerst AGENTS.md/Projektanweisungen, docs/NEXT_SESSION.md und docs/DEVELOPMENT.md, prüfe den aktuellen Git-/Datei-/Fusion-Stand und arbeite dann die offenen Entwicklungsetappen konkret ab. Sämtliche ursprünglichen Benutzerkorrekturen gelten weiter. Nicht erneut nur einen Plan schreiben.

Wichtig: Nutzer verlangt montagegerechte Konstruktion einschließlich Gegenstücken für JEDE metrische Holz-Befestigung, echte passende Verkabelung, Endkunden-Standardteile, komplette Einkaufsliste mit Brutto/Versand/Datum, Zeichnungssatz und Explosionen sowie ordentliche Darstellungen. Keine verworfene Panzer-Außenkonstruktion E04 wiederherstellen. Fusion-MCP localhost27182, eigene Skripte im Repo. E03/E05 als gesicherte Baselines erhalten; weiter in separaten Revisionen.

Versorgung neu bewerten: Nutzer möchte eine ernsthafte Festivalversorgung. Die bisherige andere Box schafft Mittwoch bis Sonntag mit 12V/100Ah-LFP und zusätzlich Handyladen. Dies ist ein realer Vergleichsfall, kein Messprotokoll für OPEN//LOUD. Handyladen/USB ausdrücklich KEINE Anforderung für OPEN//LOUD, höchstens Option. 4Ah-Werkzeugakku ist nicht mehr bevorzugt; Bosch Pro nicht ungefragt wählen. Fertige LFP-Packs gegen kleinere prismatische Zellaufbauten einschließlich BMS, Lader, Sicherungen, Kabel, Gewicht, nutzbarer Energie und Spannungs-/Pegelkompatibilität vergleichen. Kapazität nicht allein aus Ah vergleichen. Keine Sicherheits-, Wetter- oder Leistungsfreigaben erfinden.

Der Nutzer hat Commit und Push ausdrücklich beauftragt. Prüfe origin/Branch, publiziere nur eigenes bzw. berechtigtes Material und keine fremden Hersteller-CAD/Datenblätter. Führe passende Tests, CAD-/Exportprüfungen wirklich aus; dokumentiere Fehlschläge und Grenzen. Schreibe Fortschritt und konkrete Fortsetzung ins Repository und pushe überprüfte Etappen. Keine Bestellungen, keine Nachrichten an Dritte, keine endgültige Lizenzentscheidung.

Starte KEINEN weiteren Supervisor und keinen rekursiven Codex-Prozess. Dieser Lauf ist bereits der autorisierte Wiederanlauf. Der Supervisor wartet bei Nutzungslimits; keine Konten/Schlüssel wechseln oder Limits umgehen. Arbeite substantiell bis zu einem überprüfbaren Übergabestand, speichere alle Arbeit. Falls entscheidende Eingabedaten nicht verfügbar sind, dokumentiere präzise Lücken, arbeite an unabhängigen Teilen weiter und beende mit einer ehrlichen Statusübersicht.
