daniel-streetec/open_loud/hardware/mechanical/exports/E03/OPEN_LOUD_A0_E03_inside.png

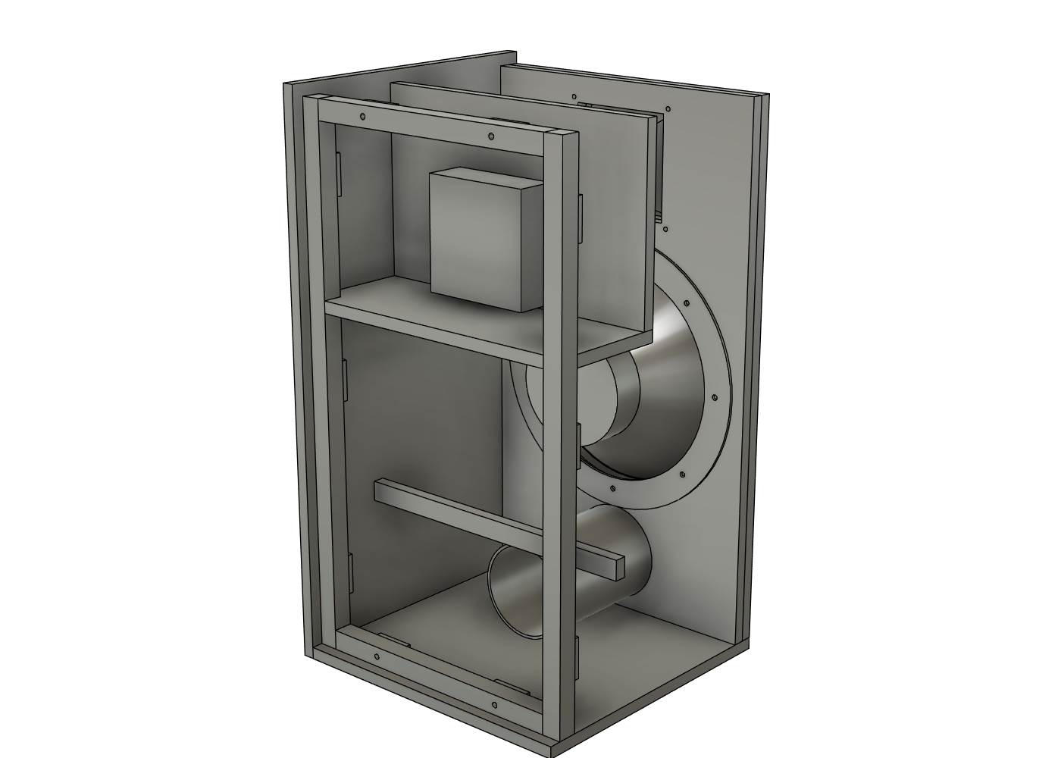
hardware/mechanical/exports/E03/OPEN_LOUD_A0_E03_inside.png
