daniel-streetec/open_loud/hardware/mechanical/exports/E06/electronics_inside.png

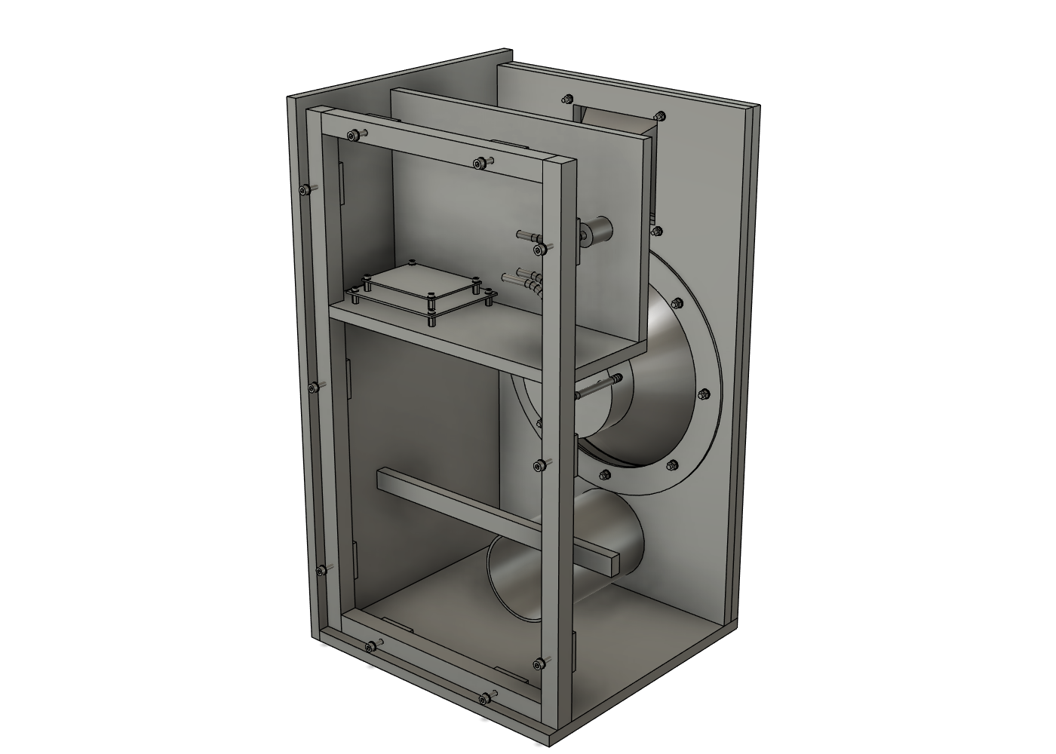
hardware/mechanical/exports/E06/electronics_inside.png
