daniel-streetec/open_loud/hardware/mechanical/exports/E09/OPEN_LOUD_A0_E09.png

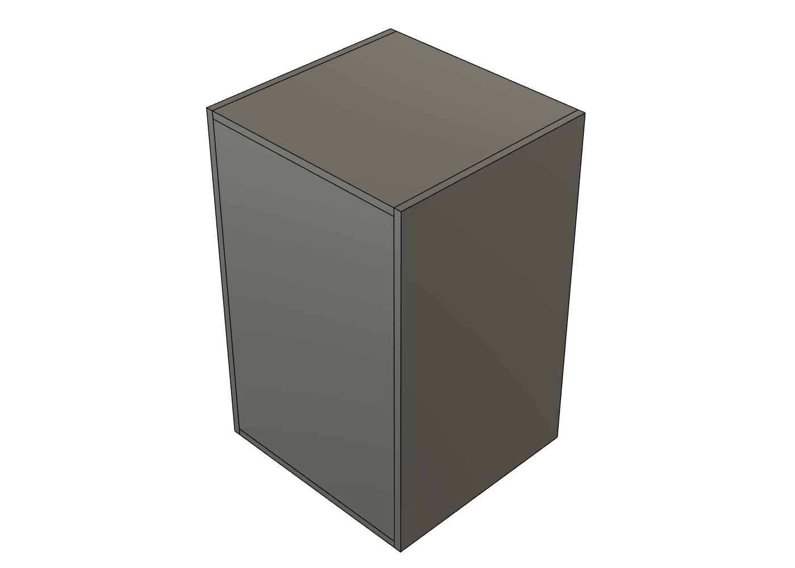
hardware/mechanical/exports/E09/OPEN_LOUD_A0_E09.png
