daniel-streetec/open_loud/hardware/mechanical/exports/E09/power_inside_DRAFT.png

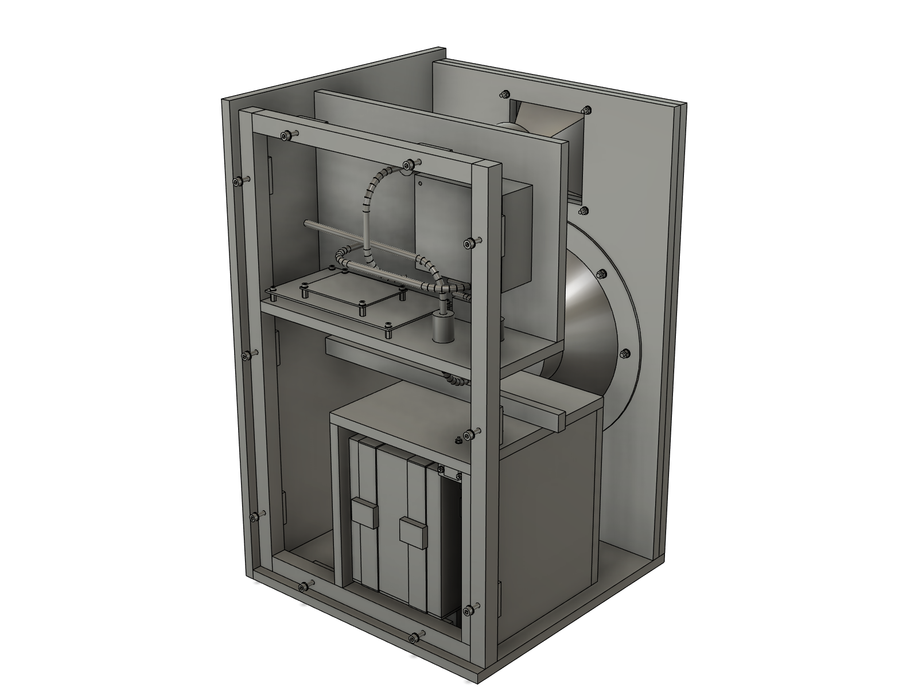
hardware/mechanical/exports/E09/power_inside_DRAFT.png
