daniel-streetec/open_loud/hardware/mechanical/exports/E07/assembly_bom.csv

assembly | component | quantity | part | status | purchasing_included
BG10_Gehaeuse/BG11_Holzstruktur | Baffle | 1 | Baffle | prototype_candidate | True
BG10_Gehaeuse/BG11_Holzstruktur | Baffle_inner_lamination | 1 | Baffle_inner_lamination | prototype_candidate | True
BG10_Gehaeuse/BG11_Holzstruktur | Bottom | 1 | Bottom | prototype_candidate | True
BG10_Gehaeuse/BG11_Holzstruktur | Brace_lower | 1 | Brace_lower | prototype_candidate | True
BG10_Gehaeuse/BG11_Holzstruktur | Rear_cleat_bottom | 1 | Rear_cleat_bottom | prototype_candidate | True
BG10_Gehaeuse/BG11_Holzstruktur | Rear_cleat_left | 1 | Rear_cleat_left | prototype_candidate | True
BG10_Gehaeuse/BG11_Holzstruktur | Rear_cleat_right | 1 | Rear_cleat_right | prototype_candidate | True
BG10_Gehaeuse/BG11_Holzstruktur | Rear_cleat_top | 1 | Rear_cleat_top | prototype_candidate | True
BG10_Gehaeuse/BG11_Holzstruktur | Service_floor | 1 | Service_floor | prototype_candidate | True
BG10_Gehaeuse/BG11_Holzstruktur | Service_partition | 1 | Service_partition | prototype_candidate | True
BG10_Gehaeuse/BG11_Holzstruktur | Side_left | 1 | Side_left | prototype_candidate | True
BG10_Gehaeuse/BG11_Holzstruktur | Side_right | 1 | Side_right | prototype_candidate | True
BG10_Gehaeuse/BG11_Holzstruktur | Top | 1 | Top | prototype_candidate | True
BG10_Gehaeuse/BG12_Feste_Rueckwandgewinde | E05_Rear_0_retainer_-1 | 1 | wood_pan_2p5x12 | purchase_candidate_head_envelope_not_threaded | True
BG10_Gehaeuse/BG12_Feste_Rueckwandgewinde | E05_Rear_0_retainer_1 | 1 | wood_pan_2p5x12 | purchase_candidate_head_envelope_not_threaded | True
BG10_Gehaeuse/BG12_Feste_Rueckwandgewinde | E05_Rear_1_retainer_-1 | 1 | wood_pan_2p5x12 | purchase_candidate_head_envelope_not_threaded | True
BG10_Gehaeuse/BG12_Feste_Rueckwandgewinde | E05_Rear_1_retainer_1 | 1 | wood_pan_2p5x12 | purchase_candidate_head_envelope_not_threaded | True
BG10_Gehaeuse/BG12_Feste_Rueckwandgewinde | E05_Rear_2_retainer_-1 | 1 | wood_pan_2p5x12 | purchase_candidate_head_envelope_not_threaded | True
BG10_Gehaeuse/BG12_Feste_Rueckwandgewinde | E05_Rear_2_retainer_1 | 1 | wood_pan_2p5x12 | purchase_candidate_head_envelope_not_threaded | True
BG10_Gehaeuse/BG12_Feste_Rueckwandgewinde | E05_Rear_3_retainer_-1 | 1 | wood_pan_2p5x12 | purchase_candidate_head_envelope_not_threaded | True
BG10_Gehaeuse/BG12_Feste_Rueckwandgewinde | E05_Rear_3_retainer_1 | 1 | wood_pan_2p5x12 | purchase_candidate_head_envelope_not_threaded | True
BG10_Gehaeuse/BG12_Feste_Rueckwandgewinde | E05_Rear_4_retainer_-1 | 1 | wood_pan_2p5x12 | purchase_candidate_head_envelope_not_threaded | True
BG10_Gehaeuse/BG12_Feste_Rueckwandgewinde | E05_Rear_4_retainer_1 | 1 | wood_pan_2p5x12 | purchase_candidate_head_envelope_not_threaded | True
BG10_Gehaeuse/BG12_Feste_Rueckwandgewinde | E05_Rear_5_retainer_-1 | 1 | wood_pan_2p5x12 | purchase_candidate_head_envelope_not_threaded | True
BG10_Gehaeuse/BG12_Feste_Rueckwandgewinde | E05_Rear_5_retainer_1 | 1 | wood_pan_2p5x12 | purchase_candidate_head_envelope_not_threaded | True
BG10_Gehaeuse/BG12_Feste_Rueckwandgewinde | E05_Rear_6_retainer_-1 | 1 | wood_pan_2p5x12 | purchase_candidate_head_envelope_not_threaded | True
BG10_Gehaeuse/BG12_Feste_Rueckwandgewinde | E05_Rear_6_retainer_1 | 1 | wood_pan_2p5x12 | purchase_candidate_head_envelope_not_threaded | True
BG10_Gehaeuse/BG12_Feste_Rueckwandgewinde | E05_Rear_7_retainer_-1 | 1 | wood_pan_2p5x12 | purchase_candidate_head_envelope_not_threaded | True
BG10_Gehaeuse/BG12_Feste_Rueckwandgewinde | E05_Rear_7_retainer_1 | 1 | wood_pan_2p5x12 | purchase_candidate_head_envelope_not_threaded | True
BG10_Gehaeuse/BG12_Feste_Rueckwandgewinde | E05_Rear_8_retainer_-1 | 1 | wood_pan_2p5x12 | purchase_candidate_head_envelope_not_threaded | True
BG10_Gehaeuse/BG12_Feste_Rueckwandgewinde | E05_Rear_8_retainer_1 | 1 | wood_pan_2p5x12 | purchase_candidate_head_envelope_not_threaded | True
BG10_Gehaeuse/BG12_Feste_Rueckwandgewinde | E05_Rear_9_retainer_-1 | 1 | wood_pan_2p5x12 | purchase_candidate_head_envelope_not_threaded | True
BG10_Gehaeuse/BG12_Feste_Rueckwandgewinde | E05_Rear_9_retainer_1 | 1 | wood_pan_2p5x12 | purchase_candidate_head_envelope_not_threaded | True
BG10_Gehaeuse/BG12_Feste_Rueckwandgewinde | Rear_thread_plate_bottom_0.27 | 1 | Rear_thread_plate_bottom_0.27 | fabricated_thread_plate_candidate_not_load_validated | True
BG10_Gehaeuse/BG12_Feste_Rueckwandgewinde | Rear_thread_plate_bottom_0.73 | 1 | Rear_thread_plate_bottom_0.73 | fabricated_thread_plate_candidate_not_load_validated | True
BG10_Gehaeuse/BG12_Feste_Rueckwandgewinde | Rear_thread_plate_left_0.15 | 1 | Rear_thread_plate_left_0.15 | fabricated_thread_plate_candidate_not_load_validated | True
BG10_Gehaeuse/BG12_Feste_Rueckwandgewinde | Rear_thread_plate_left_0.5 | 1 | Rear_thread_plate_left_0.5 | fabricated_thread_plate_candidate_not_load_validated | True
BG10_Gehaeuse/BG12_Feste_Rueckwandgewinde | Rear_thread_plate_left_0.85 | 1 | Rear_thread_plate_left_0.85 | fabricated_thread_plate_candidate_not_load_validated | True
BG10_Gehaeuse/BG12_Feste_Rueckwandgewinde | Rear_thread_plate_right_0.15 | 1 | Rear_thread_plate_right_0.15 | fabricated_thread_plate_candidate_not_load_validated | True
BG10_Gehaeuse/BG12_Feste_Rueckwandgewinde | Rear_thread_plate_right_0.5 | 1 | Rear_thread_plate_right_0.5 | fabricated_thread_plate_candidate_not_load_validated | True
BG10_Gehaeuse/BG12_Feste_Rueckwandgewinde | Rear_thread_plate_right_0.85 | 1 | Rear_thread_plate_right_0.85 | fabricated_thread_plate_candidate_not_load_validated | True
BG10_Gehaeuse/BG12_Feste_Rueckwandgewinde | Rear_thread_plate_top_0.27 | 1 | Rear_thread_plate_top_0.27 | fabricated_thread_plate_candidate_not_load_validated | True
BG10_Gehaeuse/BG12_Feste_Rueckwandgewinde | Rear_thread_plate_top_0.73 | 1 | Rear_thread_plate_top_0.73 | fabricated_thread_plate_candidate_not_load_validated | True
BG10_Gehaeuse/BG13_Elektronikstuetzen | E06_floor_bottom_M3x16_0 | 1 | ISO4762_M3x16 | nominal_mounting_candidate | True
BG10_Gehaeuse/BG13_Elektronikstuetzen | E06_floor_bottom_M3x16_1 | 1 | ISO4762_M3x16 | nominal_mounting_candidate | True
BG10_Gehaeuse/BG13_Elektronikstuetzen | E06_floor_bottom_M3x16_2 | 1 | ISO4762_M3x16 | nominal_mounting_candidate | True
BG10_Gehaeuse/BG13_Elektronikstuetzen | E06_floor_bottom_M3x16_3 | 1 | ISO4762_M3x16 | nominal_mounting_candidate | True
BG10_Gehaeuse/BG13_Elektronikstuetzen | E06_floor_bottom_washer_0 | 1 | ISO7089_M3 | nominal_mounting_candidate | True
BG10_Gehaeuse/BG13_Elektronikstuetzen | E06_floor_bottom_washer_1 | 1 | ISO7089_M3 | nominal_mounting_candidate | True
BG10_Gehaeuse/BG13_Elektronikstuetzen | E06_floor_bottom_washer_2 | 1 | ISO7089_M3 | nominal_mounting_candidate | True
BG10_Gehaeuse/BG13_Elektronikstuetzen | E06_floor_bottom_washer_3 | 1 | ISO7089_M3 | nominal_mounting_candidate | True
BG10_Gehaeuse/BG13_Elektronikstuetzen | E06_tray_support_0 | 1 | WURTH_970100321 | manufacturer_dimensions_nominal_thread_envelope | True
BG10_Gehaeuse/BG13_Elektronikstuetzen | E06_tray_support_1 | 1 | WURTH_970100321 | manufacturer_dimensions_nominal_thread_envelope | True
BG10_Gehaeuse/BG13_Elektronikstuetzen | E06_tray_support_2 | 1 | WURTH_970100321 | manufacturer_dimensions_nominal_thread_envelope | True
BG10_Gehaeuse/BG13_Elektronikstuetzen | E06_tray_support_3 | 1 | WURTH_970100321 | manufacturer_dimensions_nominal_thread_envelope | True
BG10_Gehaeuse/BG14_Kabeldurchfuehrungen | E05_HF_M16_gland | 1 | LAPP_53017210 | manufacturer_dimensions_simplified_shape_nut_seal_pending | True
BG10_Gehaeuse/BG14_Kabeldurchfuehrungen | E05_HF_gland_locknut | 1 | M16x1p5_locknut | 3mm_reserved_thickness_actual_PN_pending | True
BG10_Gehaeuse/BG14_Kabeldurchfuehrungen | E05_LF_M16_gland | 1 | LAPP_53017210 | manufacturer_dimensions_simplified_shape_nut_seal_pending | True
BG10_Gehaeuse/BG14_Kabeldurchfuehrungen | E05_LF_gland_locknut | 1 | M16x1p5_locknut | 3mm_reserved_thickness_actual_PN_pending | True
BG20_Frontbestueckung/BG21_Tieftoener | E05_LF_0_M5x45 | 1 | ISO4762_M5x45 | nominal_standard_envelope_SKU_verification_pending | True
BG20_Frontbestueckung/BG21_Tieftoener | E05_LF_0_front_washer | 1 | ISO7089_M5 | nominal_standard_envelope_SKU_verification_pending | True
BG20_Frontbestueckung/BG21_Tieftoener | E05_LF_0_nut | 1 | ISO4032_M5 | nominal_standard_envelope_SKU_verification_pending | True
BG20_Frontbestueckung/BG21_Tieftoener | E05_LF_0_rear_washer | 1 | ISO7089_M5 | nominal_standard_envelope_SKU_verification_pending | True
BG20_Frontbestueckung/BG21_Tieftoener | E05_LF_1_M5x45 | 1 | ISO4762_M5x45 | nominal_standard_envelope_SKU_verification_pending | True
BG20_Frontbestueckung/BG21_Tieftoener | E05_LF_1_front_washer | 1 | ISO7089_M5 | nominal_standard_envelope_SKU_verification_pending | True
BG20_Frontbestueckung/BG21_Tieftoener | E05_LF_1_nut | 1 | ISO4032_M5 | nominal_standard_envelope_SKU_verification_pending | True
BG20_Frontbestueckung/BG21_Tieftoener | E05_LF_1_rear_washer | 1 | ISO7089_M5 | nominal_standard_envelope_SKU_verification_pending | True
BG20_Frontbestueckung/BG21_Tieftoener | E05_LF_2_M5x45 | 1 | ISO4762_M5x45 | nominal_standard_envelope_SKU_verification_pending | True
BG20_Frontbestueckung/BG21_Tieftoener | E05_LF_2_front_washer | 1 | ISO7089_M5 | nominal_standard_envelope_SKU_verification_pending | True
BG20_Frontbestueckung/BG21_Tieftoener | E05_LF_2_nut | 1 | ISO4032_M5 | nominal_standard_envelope_SKU_verification_pending | True
BG20_Frontbestueckung/BG21_Tieftoener | E05_LF_2_rear_washer | 1 | ISO7089_M5 | nominal_standard_envelope_SKU_verification_pending | True
BG20_Frontbestueckung/BG21_Tieftoener | E05_LF_3_M5x45 | 1 | ISO4762_M5x45 | nominal_standard_envelope_SKU_verification_pending | True
BG20_Frontbestueckung/BG21_Tieftoener | E05_LF_3_front_washer | 1 | ISO7089_M5 | nominal_standard_envelope_SKU_verification_pending | True
BG20_Frontbestueckung/BG21_Tieftoener | E05_LF_3_nut | 1 | ISO4032_M5 | nominal_standard_envelope_SKU_verification_pending | True
BG20_Frontbestueckung/BG21_Tieftoener | E05_LF_3_rear_washer | 1 | ISO7089_M5 | nominal_standard_envelope_SKU_verification_pending | True
BG20_Frontbestueckung/BG21_Tieftoener | E05_LF_4_M5x45 | 1 | ISO4762_M5x45 | nominal_standard_envelope_SKU_verification_pending | True
BG20_Frontbestueckung/BG21_Tieftoener | E05_LF_4_front_washer | 1 | ISO7089_M5 | nominal_standard_envelope_SKU_verification_pending | True
BG20_Frontbestueckung/BG21_Tieftoener | E05_LF_4_nut | 1 | ISO4032_M5 | nominal_standard_envelope_SKU_verification_pending | True
BG20_Frontbestueckung/BG21_Tieftoener | E05_LF_4_rear_washer | 1 | ISO7089_M5 | nominal_standard_envelope_SKU_verification_pending | True
BG20_Frontbestueckung/BG21_Tieftoener | E05_LF_5_M5x45 | 1 | ISO4762_M5x45 | nominal_standard_envelope_SKU_verification_pending | True
BG20_Frontbestueckung/BG21_Tieftoener | E05_LF_5_front_washer | 1 | ISO7089_M5 | nominal_standard_envelope_SKU_verification_pending | True
BG20_Frontbestueckung/BG21_Tieftoener | E05_LF_5_nut | 1 | ISO4032_M5 | nominal_standard_envelope_SKU_verification_pending | True
BG20_Frontbestueckung/BG21_Tieftoener | E05_LF_5_rear_washer | 1 | ISO7089_M5 | nominal_standard_envelope_SKU_verification_pending | True
BG20_Frontbestueckung/BG21_Tieftoener | E05_LF_6_M5x45 | 1 | ISO4762_M5x45 | nominal_standard_envelope_SKU_verification_pending | True
BG20_Frontbestueckung/BG21_Tieftoener | E05_LF_6_front_washer | 1 | ISO7089_M5 | nominal_standard_envelope_SKU_verification_pending | True
BG20_Frontbestueckung/BG21_Tieftoener | E05_LF_6_nut | 1 | ISO4032_M5 | nominal_standard_envelope_SKU_verification_pending | True
BG20_Frontbestueckung/BG21_Tieftoener | E05_LF_6_rear_washer | 1 | ISO7089_M5 | nominal_standard_envelope_SKU_verification_pending | True
BG20_Frontbestueckung/BG21_Tieftoener | E05_LF_7_M5x45 | 1 | ISO4762_M5x45 | nominal_standard_envelope_SKU_verification_pending | True
BG20_Frontbestueckung/BG21_Tieftoener | E05_LF_7_front_washer | 1 | ISO7089_M5 | nominal_standard_envelope_SKU_verification_pending | True
BG20_Frontbestueckung/BG21_Tieftoener | E05_LF_7_nut | 1 | ISO4032_M5 | nominal_standard_envelope_SKU_verification_pending | True
BG20_Frontbestueckung/BG21_Tieftoener | E05_LF_7_rear_washer | 1 | ISO7089_M5 | nominal_standard_envelope_SKU_verification_pending | True
BG20_Frontbestueckung/BG21_Tieftoener | LF_steel_backing_ring_candidate | 1 | LF_steel_backing_ring_candidate | prototype_candidate | True
BG20_Frontbestueckung/BG21_Tieftoener | REF_Faital_10FE200_4ohm_DATASHEET_ENVELOPE | 1 | REF_Faital_10FE200_4ohm_DATASHEET_ENVELOPE | clearance_reference_not_manufacturing | True
BG20_Frontbestueckung/BG22_Hochton | E05_HF_-1_-1_M4x40 | 1 | ISO4762_M4x40 | nominal_standard_envelope_SKU_verification_pending | True
BG20_Frontbestueckung/BG22_Hochton | E05_HF_-1_-1_front_washer | 1 | ISO7089_M4 | nominal_standard_envelope_SKU_verification_pending | True
BG20_Frontbestueckung/BG22_Hochton | E05_HF_-1_-1_nut | 1 | DIN934_M4 | nominal_standard_envelope_SKU_verification_pending | True
BG20_Frontbestueckung/BG22_Hochton | E05_HF_-1_-1_rear_washer | 1 | ISO7089_M4 | nominal_standard_envelope_SKU_verification_pending | True
BG20_Frontbestueckung/BG22_Hochton | E05_HF_-1_1_M4x40 | 1 | ISO4762_M4x40 | nominal_standard_envelope_SKU_verification_pending | True
BG20_Frontbestueckung/BG22_Hochton | E05_HF_-1_1_front_washer | 1 | ISO7089_M4 | nominal_standard_envelope_SKU_verification_pending | True
BG20_Frontbestueckung/BG22_Hochton | E05_HF_-1_1_nut | 1 | DIN934_M4 | nominal_standard_envelope_SKU_verification_pending | True
BG20_Frontbestueckung/BG22_Hochton | E05_HF_-1_1_rear_washer | 1 | ISO7089_M4 | nominal_standard_envelope_SKU_verification_pending | True
BG20_Frontbestueckung/BG22_Hochton | E05_HF_1_-1_M4x40 | 1 | ISO4762_M4x40 | nominal_standard_envelope_SKU_verification_pending | True
BG20_Frontbestueckung/BG22_Hochton | E05_HF_1_-1_front_washer | 1 | ISO7089_M4 | nominal_standard_envelope_SKU_verification_pending | True
BG20_Frontbestueckung/BG22_Hochton | E05_HF_1_-1_nut | 1 | DIN934_M4 | nominal_standard_envelope_SKU_verification_pending | True
BG20_Frontbestueckung/BG22_Hochton | E05_HF_1_-1_rear_washer | 1 | ISO7089_M4 | nominal_standard_envelope_SKU_verification_pending | True
BG20_Frontbestueckung/BG22_Hochton | E05_HF_1_1_M4x40 | 1 | ISO4762_M4x40 | nominal_standard_envelope_SKU_verification_pending | True
BG20_Frontbestueckung/BG22_Hochton | E05_HF_1_1_front_washer | 1 | ISO7089_M4 | nominal_standard_envelope_SKU_verification_pending | True
BG20_Frontbestueckung/BG22_Hochton | E05_HF_1_1_nut | 1 | DIN934_M4 | nominal_standard_envelope_SKU_verification_pending | True
BG20_Frontbestueckung/BG22_Hochton | E05_HF_1_1_rear_washer | 1 | ISO7089_M4 | nominal_standard_envelope_SKU_verification_pending | True
BG20_Frontbestueckung/BG22_Hochton | REF_BC_DE10_DATASHEET_ENVELOPE | 1 | REF_BC_DE10_DATASHEET_ENVELOPE | clearance_reference_not_manufacturing | True
BG20_Frontbestueckung/BG22_Hochton | REF_BC_ME10V3_DATASHEET_ENVELOPE | 1 | REF_BC_ME10V3_DATASHEET_ENVELOPE | clearance_reference_not_manufacturing | True
BG20_Frontbestueckung/BG23_Bassreflexport | Port_round_candidate | 1 | Port_round_candidate | prototype_candidate | True
BG30_Service_Rueckwand | E05_Rear_0_M5x40 | 1 | ISO4762_M5x40 | nominal_standard_envelope_SKU_verification_pending | True
BG30_Service_Rueckwand | E05_Rear_0_washer | 1 | ISO7089_M5 | nominal_standard_envelope_SKU_verification_pending | True
BG30_Service_Rueckwand | E05_Rear_1_M5x40 | 1 | ISO4762_M5x40 | nominal_standard_envelope_SKU_verification_pending | True
BG30_Service_Rueckwand | E05_Rear_1_washer | 1 | ISO7089_M5 | nominal_standard_envelope_SKU_verification_pending | True
BG30_Service_Rueckwand | E05_Rear_2_M5x40 | 1 | ISO4762_M5x40 | nominal_standard_envelope_SKU_verification_pending | True
BG30_Service_Rueckwand | E05_Rear_2_washer | 1 | ISO7089_M5 | nominal_standard_envelope_SKU_verification_pending | True
BG30_Service_Rueckwand | E05_Rear_3_M5x40 | 1 | ISO4762_M5x40 | nominal_standard_envelope_SKU_verification_pending | True
BG30_Service_Rueckwand | E05_Rear_3_washer | 1 | ISO7089_M5 | nominal_standard_envelope_SKU_verification_pending | True
BG30_Service_Rueckwand | E05_Rear_4_M5x40 | 1 | ISO4762_M5x40 | nominal_standard_envelope_SKU_verification_pending | True
BG30_Service_Rueckwand | E05_Rear_4_washer | 1 | ISO7089_M5 | nominal_standard_envelope_SKU_verification_pending | True
BG30_Service_Rueckwand | E05_Rear_5_M5x40 | 1 | ISO4762_M5x40 | nominal_standard_envelope_SKU_verification_pending | True
BG30_Service_Rueckwand | E05_Rear_5_washer | 1 | ISO7089_M5 | nominal_standard_envelope_SKU_verification_pending | True
BG30_Service_Rueckwand | E05_Rear_6_M5x40 | 1 | ISO4762_M5x40 | nominal_standard_envelope_SKU_verification_pending | True
BG30_Service_Rueckwand | E05_Rear_6_washer | 1 | ISO7089_M5 | nominal_standard_envelope_SKU_verification_pending | True
BG30_Service_Rueckwand | E05_Rear_7_M5x40 | 1 | ISO4762_M5x40 | nominal_standard_envelope_SKU_verification_pending | True
BG30_Service_Rueckwand | E05_Rear_7_washer | 1 | ISO7089_M5 | nominal_standard_envelope_SKU_verification_pending | True
BG30_Service_Rueckwand | E05_Rear_8_M5x40 | 1 | ISO4762_M5x40 | nominal_standard_envelope_SKU_verification_pending | True
BG30_Service_Rueckwand | E05_Rear_8_washer | 1 | ISO7089_M5 | nominal_standard_envelope_SKU_verification_pending | True
BG30_Service_Rueckwand | E05_Rear_9_M5x40 | 1 | ISO4762_M5x40 | nominal_standard_envelope_SKU_verification_pending | True
BG30_Service_Rueckwand | E05_Rear_9_washer | 1 | ISO7089_M5 | nominal_standard_envelope_SKU_verification_pending | True
BG30_Service_Rueckwand | Rear_removable | 1 | Rear_removable | prototype_candidate | True
BG40_Elektronikmodul/BG41_Traeger | E06_removable_tray_112x90x2 | 1 | OWN_AL_TRAY_112_90_2 | nominal_mounting_candidate | True
BG40_Elektronikmodul/BG41_Traeger | E06_tray_top_M3x6_0 | 1 | ISO4762_M3x6 | nominal_mounting_candidate | True
BG40_Elektronikmodul/BG41_Traeger | E06_tray_top_M3x6_1 | 1 | ISO4762_M3x6 | nominal_mounting_candidate | True
BG40_Elektronikmodul/BG41_Traeger | E06_tray_top_M3x6_2 | 1 | ISO4762_M3x6 | nominal_mounting_candidate | True
BG40_Elektronikmodul/BG41_Traeger | E06_tray_top_M3x6_3 | 1 | ISO4762_M3x6 | nominal_mounting_candidate | True
BG40_Elektronikmodul/BG41_Traeger | E06_tray_top_washer_0 | 1 | ISO7089_M3 | nominal_mounting_candidate | True
BG40_Elektronikmodul/BG41_Traeger | E06_tray_top_washer_1 | 1 | ISO7089_M3 | nominal_mounting_candidate | True
BG40_Elektronikmodul/BG41_Traeger | E06_tray_top_washer_2 | 1 | ISO7089_M3 | nominal_mounting_candidate | True
BG40_Elektronikmodul/BG41_Traeger | E06_tray_top_washer_3 | 1 | ISO7089_M3 | nominal_mounting_candidate | True
BG40_Elektronikmodul/BG42_Verstaerker_DSP | E06_JAB3_PCB_mounting_outline | 1 | WONDOM_AA_JA32173 | manufacturer_outer_dimensions_holes; board_thickness_assumed | True
BG40_Elektronikmodul/BG42_Verstaerker_DSP | E06_PCB_bottom_M3x6_0 | 1 | ISO4762_M3x6 | nominal_mounting_candidate | True
BG40_Elektronikmodul/BG42_Verstaerker_DSP | E06_PCB_bottom_M3x6_1 | 1 | ISO4762_M3x6 | nominal_mounting_candidate | True
BG40_Elektronikmodul/BG42_Verstaerker_DSP | E06_PCB_bottom_M3x6_2 | 1 | ISO4762_M3x6 | nominal_mounting_candidate | True
BG40_Elektronikmodul/BG42_Verstaerker_DSP | E06_PCB_bottom_M3x6_3 | 1 | ISO4762_M3x6 | nominal_mounting_candidate | True
BG40_Elektronikmodul/BG42_Verstaerker_DSP | E06_PCB_bottom_washer_0 | 1 | ISO7089_M3 | nominal_mounting_candidate | True
BG40_Elektronikmodul/BG42_Verstaerker_DSP | E06_PCB_bottom_washer_1 | 1 | ISO7089_M3 | nominal_mounting_candidate | True
BG40_Elektronikmodul/BG42_Verstaerker_DSP | E06_PCB_bottom_washer_2 | 1 | ISO7089_M3 | nominal_mounting_candidate | True
BG40_Elektronikmodul/BG42_Verstaerker_DSP | E06_PCB_bottom_washer_3 | 1 | ISO7089_M3 | nominal_mounting_candidate | True
BG40_Elektronikmodul/BG42_Verstaerker_DSP | E06_PCB_support_0 | 1 | WURTH_970100321 | manufacturer_dimensions_nominal_thread_envelope | True
BG40_Elektronikmodul/BG42_Verstaerker_DSP | E06_PCB_support_1 | 1 | WURTH_970100321 | manufacturer_dimensions_nominal_thread_envelope | True
BG40_Elektronikmodul/BG42_Verstaerker_DSP | E06_PCB_support_2 | 1 | WURTH_970100321 | manufacturer_dimensions_nominal_thread_envelope | True
BG40_Elektronikmodul/BG42_Verstaerker_DSP | E06_PCB_support_3 | 1 | WURTH_970100321 | manufacturer_dimensions_nominal_thread_envelope | True
BG40_Elektronikmodul/BG42_Verstaerker_DSP | E06_PCB_top_M3x6_0 | 1 | ISO4762_M3x6 | nominal_mounting_candidate | True
BG40_Elektronikmodul/BG42_Verstaerker_DSP | E06_PCB_top_M3x6_1 | 1 | ISO4762_M3x6 | nominal_mounting_candidate | True
BG40_Elektronikmodul/BG42_Verstaerker_DSP | E06_PCB_top_M3x6_2 | 1 | ISO4762_M3x6 | nominal_mounting_candidate | True
BG40_Elektronikmodul/BG42_Verstaerker_DSP | E06_PCB_top_M3x6_3 | 1 | ISO4762_M3x6 | nominal_mounting_candidate | True
BG40_Elektronikmodul/BG42_Verstaerker_DSP | E06_PCB_top_washer_0 | 1 | ISO7089_M3 | nominal_mounting_candidate | True
BG40_Elektronikmodul/BG42_Verstaerker_DSP | E06_PCB_top_washer_1 | 1 | ISO7089_M3 | nominal_mounting_candidate | True
BG40_Elektronikmodul/BG42_Verstaerker_DSP | E06_PCB_top_washer_2 | 1 | ISO7089_M3 | nominal_mounting_candidate | True
BG40_Elektronikmodul/BG42_Verstaerker_DSP | E06_PCB_top_washer_3 | 1 | ISO7089_M3 | nominal_mounting_candidate | True
BG50_Kabelbaum | E05_cable_hf | 1 | Cordial_CLS215_hf | jacket_route_only_service_slack_and_OEM_ends_not_geometry | True
BG50_Kabelbaum | E05_cable_lf | 1 | Cordial_CLS215_lf | jacket_route_only_service_slack_and_OEM_ends_not_geometry | True
BG50_Kabelbaum | E05_cable_power | 1 | Cordial_CLS215_power | jacket_route_only_service_slack_and_OEM_ends_not_geometry | True
BG90_Referenzraeume | E06_RESERVE_JAB3_components_NOT_ACTUAL_GEOMETRY | 1 | JAB3_COMPONENT_KEEP_OUT | component_positions_unverified | False
BG90_Referenzraeume | RESERVE_amp_wiring_UNVERIFIED_no_mounting_holes | 1 | RESERVE_amp_wiring_UNVERIFIED_no_mounting_holes | clearance_reference_not_manufacturing | False
