daniel-streetec/open_loud/hardware/mechanical/exports/E07/assembly_bom_grouped.csv

assembly | part | model_quantity | unit | model_status | purchasing_included | manufacturer | article | gross_unit_EUR | price_date | procurement_status | source
BG10_Gehaeuse/BG11_Holzstruktur | Baffle | 1 | piece | prototype_candidate | True |  |  |  |  | NOT_QUALIFIED_IN_CURRENT_PROCUREMENT_DATA
BG10_Gehaeuse/BG11_Holzstruktur | Baffle_inner_lamination | 1 | piece | prototype_candidate | True |  |  |  |  | NOT_QUALIFIED_IN_CURRENT_PROCUREMENT_DATA
BG10_Gehaeuse/BG11_Holzstruktur | Bottom | 1 | piece | prototype_candidate | True |  |  |  |  | NOT_QUALIFIED_IN_CURRENT_PROCUREMENT_DATA
BG10_Gehaeuse/BG11_Holzstruktur | Brace_lower | 1 | piece | prototype_candidate | True |  |  |  |  | NOT_QUALIFIED_IN_CURRENT_PROCUREMENT_DATA
BG10_Gehaeuse/BG11_Holzstruktur | Rear_cleat_bottom | 1 | piece | prototype_candidate | True |  |  |  |  | NOT_QUALIFIED_IN_CURRENT_PROCUREMENT_DATA
BG10_Gehaeuse/BG11_Holzstruktur | Rear_cleat_left | 1 | piece | prototype_candidate | True |  |  |  |  | NOT_QUALIFIED_IN_CURRENT_PROCUREMENT_DATA
BG10_Gehaeuse/BG11_Holzstruktur | Rear_cleat_right | 1 | piece | prototype_candidate | True |  |  |  |  | NOT_QUALIFIED_IN_CURRENT_PROCUREMENT_DATA
BG10_Gehaeuse/BG11_Holzstruktur | Rear_cleat_top | 1 | piece | prototype_candidate | True |  |  |  |  | NOT_QUALIFIED_IN_CURRENT_PROCUREMENT_DATA
BG10_Gehaeuse/BG11_Holzstruktur | Service_floor | 1 | piece | prototype_candidate | True |  |  |  |  | NOT_QUALIFIED_IN_CURRENT_PROCUREMENT_DATA
BG10_Gehaeuse/BG11_Holzstruktur | Service_partition | 1 | piece | prototype_candidate | True |  |  |  |  | NOT_QUALIFIED_IN_CURRENT_PROCUREMENT_DATA
BG10_Gehaeuse/BG11_Holzstruktur | Side_left | 1 | piece | prototype_candidate | True |  |  |  |  | NOT_QUALIFIED_IN_CURRENT_PROCUREMENT_DATA
BG10_Gehaeuse/BG11_Holzstruktur | Side_right | 1 | piece | prototype_candidate | True |  |  |  |  | NOT_QUALIFIED_IN_CURRENT_PROCUREMENT_DATA
BG10_Gehaeuse/BG11_Holzstruktur | Top | 1 | piece | prototype_candidate | True |  |  |  |  | NOT_QUALIFIED_IN_CURRENT_PROCUREMENT_DATA
BG10_Gehaeuse/BG12_Feste_Rueckwandgewinde | Rear_thread_plate_bottom_0.27 | 1 | piece | fabricated_thread_plate_candidate_not_load_validated | True |  |  |  |  | NOT_QUALIFIED_IN_CURRENT_PROCUREMENT_DATA
BG10_Gehaeuse/BG12_Feste_Rueckwandgewinde | Rear_thread_plate_bottom_0.73 | 1 | piece | fabricated_thread_plate_candidate_not_load_validated | True |  |  |  |  | NOT_QUALIFIED_IN_CURRENT_PROCUREMENT_DATA
BG10_Gehaeuse/BG12_Feste_Rueckwandgewinde | Rear_thread_plate_left_0.15 | 1 | piece | fabricated_thread_plate_candidate_not_load_validated | True |  |  |  |  | NOT_QUALIFIED_IN_CURRENT_PROCUREMENT_DATA
BG10_Gehaeuse/BG12_Feste_Rueckwandgewinde | Rear_thread_plate_left_0.5 | 1 | piece | fabricated_thread_plate_candidate_not_load_validated | True |  |  |  |  | NOT_QUALIFIED_IN_CURRENT_PROCUREMENT_DATA
BG10_Gehaeuse/BG12_Feste_Rueckwandgewinde | Rear_thread_plate_left_0.85 | 1 | piece | fabricated_thread_plate_candidate_not_load_validated | True |  |  |  |  | NOT_QUALIFIED_IN_CURRENT_PROCUREMENT_DATA
BG10_Gehaeuse/BG12_Feste_Rueckwandgewinde | Rear_thread_plate_right_0.15 | 1 | piece | fabricated_thread_plate_candidate_not_load_validated | True |  |  |  |  | NOT_QUALIFIED_IN_CURRENT_PROCUREMENT_DATA
BG10_Gehaeuse/BG12_Feste_Rueckwandgewinde | Rear_thread_plate_right_0.5 | 1 | piece | fabricated_thread_plate_candidate_not_load_validated | True |  |  |  |  | NOT_QUALIFIED_IN_CURRENT_PROCUREMENT_DATA
BG10_Gehaeuse/BG12_Feste_Rueckwandgewinde | Rear_thread_plate_right_0.85 | 1 | piece | fabricated_thread_plate_candidate_not_load_validated | True |  |  |  |  | NOT_QUALIFIED_IN_CURRENT_PROCUREMENT_DATA
BG10_Gehaeuse/BG12_Feste_Rueckwandgewinde | Rear_thread_plate_top_0.27 | 1 | piece | fabricated_thread_plate_candidate_not_load_validated | True |  |  |  |  | NOT_QUALIFIED_IN_CURRENT_PROCUREMENT_DATA
BG10_Gehaeuse/BG12_Feste_Rueckwandgewinde | Rear_thread_plate_top_0.73 | 1 | piece | fabricated_thread_plate_candidate_not_load_validated | True |  |  |  |  | NOT_QUALIFIED_IN_CURRENT_PROCUREMENT_DATA
BG10_Gehaeuse/BG12_Feste_Rueckwandgewinde | wood_pan_2p5x12 | 20 | piece | purchase_candidate_head_envelope_not_threaded | True |  | 2.5x12 pan wood screw; head5x2mm envelope |  |  | candidate_exact_head_and_retention_test_pending
BG10_Gehaeuse/BG13_Elektronikstuetzen | ISO4762_M3x16 | 4 | piece | nominal_mounting_candidate | True |  |  |  |  | NOT_QUALIFIED_IN_CURRENT_PROCUREMENT_DATA
BG10_Gehaeuse/BG13_Elektronikstuetzen | ISO7089_M3 | 4 | piece | nominal_mounting_candidate | True |  |  |  |  | NOT_QUALIFIED_IN_CURRENT_PROCUREMENT_DATA
BG10_Gehaeuse/BG13_Elektronikstuetzen | WURTH_970100321 | 4 | piece | manufacturer_dimensions_nominal_thread_envelope | True |  |  |  |  | NOT_QUALIFIED_IN_CURRENT_PROCUREMENT_DATA
BG10_Gehaeuse/BG14_Kabeldurchfuehrungen | LAPP_53017210 | 2 | piece | manufacturer_dimensions_simplified_shape_nut_seal_pending | True | LAPP | 53017210 |  |  | DIMENSION_REFERENCE_ONLY_PROCUREMENT_NOT_RELEASED | https://www.buerklin.com/de/p/lapp/kabelverschraubungen/53017210/32P3067/
BG10_Gehaeuse/BG14_Kabeldurchfuehrungen | M16x1p5_locknut | 2 | piece | 3mm_reserved_thickness_actual_PN_pending | True | LAPP reference | SKINDICHT SM-M M16x1.5, 52103010 (check current LF suffix) |  |  | REFERENCE_ONLY; 5mm plastic nut does NOT meet reserved stack | https://products.lappgroup.com/fileadmin/documents/technische_doku/datenblaetter/skindicht/DB52103000EN.pdf
BG20_Frontbestueckung/BG21_Tieftoener | ISO4032_M5 | 8 | piece | nominal_standard_envelope_SKU_verification_pending | True |  | ISO4032 M5 A2, h4.7 envelope |  |  | standard_part_SKU_pending
BG20_Frontbestueckung/BG21_Tieftoener | ISO4762_M5x45 | 8 | piece | nominal_standard_envelope_SKU_verification_pending | True | NormReich supplier; actual screw maker unspecified | 0912A2-M050X045TISK | 0.1058 | 2026-11-09 | selected_nominal_fit_physical_check_pending | https://www.normreich.de/1x-Zylinderschraube-M5x45-DIN-912-A2
BG20_Frontbestueckung/BG21_Tieftoener | ISO7089_M5 | 16 | piece | nominal_standard_envelope_SKU_verification_pending | True |  | ISO7089 M5 A2 |  |  | standard_part_SKU_pending
BG20_Frontbestueckung/BG21_Tieftoener | LF_steel_backing_ring_candidate | 1 | piece | prototype_candidate | True |  |  |  |  | NOT_QUALIFIED_IN_CURRENT_PROCUREMENT_DATA
BG20_Frontbestueckung/BG21_Tieftoener | REF_Faital_10FE200_4ohm_DATASHEET_ENVELOPE | 1 | piece | clearance_reference_not_manufacturing | True |  |  |  |  | NOT_QUALIFIED_IN_CURRENT_PROCUREMENT_DATA
BG20_Frontbestueckung/BG22_Hochton | DIN934_M4 | 4 | piece | nominal_standard_envelope_SKU_verification_pending | True |  | DIN934 M4 A2, h3.2 envelope |  |  | standard_part_SKU_pending
BG20_Frontbestueckung/BG22_Hochton | ISO4762_M4x40 | 4 | piece | nominal_standard_envelope_SKU_verification_pending | True | NormReich supplier; actual screw maker unspecified | 0912A2-M040X040TISK | 0.0893 | 2026-11-09 | selected_nominal_fit_physical_check_pending | https://www.normreich.de/1x-Zylinderschraube-M4x40-DIN-912-A2
BG20_Frontbestueckung/BG22_Hochton | ISO7089_M4 | 8 | piece | nominal_standard_envelope_SKU_verification_pending | True |  | ISO7089 M4 A2 |  |  | standard_part_SKU_pending
BG20_Frontbestueckung/BG22_Hochton | REF_BC_DE10_DATASHEET_ENVELOPE | 1 | piece | clearance_reference_not_manufacturing | True |  |  |  |  | NOT_QUALIFIED_IN_CURRENT_PROCUREMENT_DATA
BG20_Frontbestueckung/BG22_Hochton | REF_BC_ME10V3_DATASHEET_ENVELOPE | 1 | piece | clearance_reference_not_manufacturing | True |  |  |  |  | NOT_QUALIFIED_IN_CURRENT_PROCUREMENT_DATA
BG20_Frontbestueckung/BG23_Bassreflexport | Port_round_candidate | 1 | piece | prototype_candidate | True |  |  |  |  | NOT_QUALIFIED_IN_CURRENT_PROCUREMENT_DATA
BG30_Service_Rueckwand | ISO4762_M5x40 | 10 | piece | nominal_standard_envelope_SKU_verification_pending | True | NormReich supplier; actual screw maker unspecified | 0912A2-M050X040TISK | 0.0925 | 2026-11-09 | selected_nominal_fit_physical_check_pending | https://www.normreich.de/1x-Zylinderschraube-M5x40-DIN-912-A2
BG30_Service_Rueckwand | ISO7089_M5 | 10 | piece | nominal_standard_envelope_SKU_verification_pending | True |  | ISO7089 M5 A2 |  |  | standard_part_SKU_pending
BG30_Service_Rueckwand | Rear_removable | 1 | piece | prototype_candidate | True |  |  |  |  | NOT_QUALIFIED_IN_CURRENT_PROCUREMENT_DATA
BG40_Elektronikmodul/BG41_Traeger | ISO4762_M3x6 | 4 | piece | nominal_mounting_candidate | True |  |  |  |  | NOT_QUALIFIED_IN_CURRENT_PROCUREMENT_DATA
BG40_Elektronikmodul/BG41_Traeger | ISO7089_M3 | 4 | piece | nominal_mounting_candidate | True |  |  |  |  | NOT_QUALIFIED_IN_CURRENT_PROCUREMENT_DATA
BG40_Elektronikmodul/BG41_Traeger | OWN_AL_TRAY_112_90_2 | 1 | piece | nominal_mounting_candidate | True |  |  |  |  | NOT_QUALIFIED_IN_CURRENT_PROCUREMENT_DATA
BG40_Elektronikmodul/BG42_Verstaerker_DSP | ISO4762_M3x6 | 8 | piece | nominal_mounting_candidate | True |  |  |  |  | NOT_QUALIFIED_IN_CURRENT_PROCUREMENT_DATA
BG40_Elektronikmodul/BG42_Verstaerker_DSP | ISO7089_M3 | 8 | piece | nominal_mounting_candidate | True |  |  |  |  | NOT_QUALIFIED_IN_CURRENT_PROCUREMENT_DATA
BG40_Elektronikmodul/BG42_Verstaerker_DSP | WONDOM_AA_JA32173 | 1 | piece | manufacturer_outer_dimensions_holes; board_thickness_assumed | True |  |  |  |  | NOT_QUALIFIED_IN_CURRENT_PROCUREMENT_DATA
BG40_Elektronikmodul/BG42_Verstaerker_DSP | WURTH_970100321 | 4 | piece | manufacturer_dimensions_nominal_thread_envelope | True |  |  |  |  | NOT_QUALIFIED_IN_CURRENT_PROCUREMENT_DATA
BG50_Kabelbaum | Cordial_CLS215_hf | 1 | piece | jacket_route_only_service_slack_and_OEM_ends_not_geometry | True |  |  |  |  | NOT_QUALIFIED_IN_CURRENT_PROCUREMENT_DATA
BG50_Kabelbaum | Cordial_CLS215_lf | 1 | piece | jacket_route_only_service_slack_and_OEM_ends_not_geometry | True |  |  |  |  | NOT_QUALIFIED_IN_CURRENT_PROCUREMENT_DATA
BG50_Kabelbaum | Cordial_CLS215_power | 1 | piece | jacket_route_only_service_slack_and_OEM_ends_not_geometry | True |  |  |  |  | NOT_QUALIFIED_IN_CURRENT_PROCUREMENT_DATA
BG90_Referenzraeume | JAB3_COMPONENT_KEEP_OUT | 1 | piece | component_positions_unverified | False |  |  |  |  | NOT_QUALIFIED_IN_CURRENT_PROCUREMENT_DATA
BG90_Referenzraeume | RESERVE_amp_wiring_UNVERIFIED_no_mounting_holes | 1 | piece | clearance_reference_not_manufacturing | False |  |  |  |  | NOT_QUALIFIED_IN_CURRENT_PROCUREMENT_DATA
