daniel-streetec/open_loud/hardware/mechanical/exports/E03/cutlist_DRAFT.csv

component | quantity | material | length_mm | width_mm | thickness_mm | volume_cm3 | status | dxf
Side_left | 1 | birch_plywood_candidate | 560.0 | 300.0 | 12.000000000000002 | 2016.0000000000005 | DRAFT_not_released | Side_left_E03_DRAFT.dxf
Side_right | 1 | birch_plywood_candidate | 560.0 | 300.0 | 11.999999999999993 | 2015.9999999999989 | DRAFT_not_released | Side_right_E03_DRAFT.dxf
Bottom | 1 | birch_plywood_candidate | 306.0 | 300.0 | 12.000000000000002 | 1101.6000000000001 | DRAFT_not_released | Bottom_E03_DRAFT.dxf
Top | 1 | birch_plywood_candidate | 306.0 | 300.0 | 12.000000000000028 | 1101.6000000000026 | DRAFT_not_released | Top_E03_DRAFT.dxf
Baffle | 1 | birch_plywood_candidate | 536.0 | 306.0 | 12.000000000000002 | 1227.503170496963 | DRAFT_not_released | Baffle_E03_DRAFT.dxf
Rear_removable | 1 | birch_plywood_candidate | 536.0 | 306.0 | 11.999999999999993 | 1958.7330046668656 | DRAFT_not_released | Rear_removable_E03_DRAFT.dxf
Baffle_inner_lamination | 1 | birch_plywood_candidate | 536.0 | 306.0 | 12.000000000000002 | 1227.503170496963 | DRAFT_not_released | Baffle_inner_lamination_E03_DRAFT.dxf
LF_steel_backing_ring_candidate | 1 | steel_candidate | 280.0 | 280.0 | 2.9999999999999982 | 70.11563563914682 | DRAFT_not_released | LF_steel_backing_ring_candidate_E03_DRAFT.dxf
Rear_cleat_left | 1 | birch_plywood_candidate | 536.0 | 20.0 | 20.0 | 214.4 | DRAFT_not_released | Rear_cleat_left_E03_DRAFT.dxf
Rear_cleat_right | 1 | birch_plywood_candidate | 536.0 | 20.0 | 20.0 | 214.4 | DRAFT_not_released | Rear_cleat_right_E03_DRAFT.dxf
Rear_cleat_bottom | 1 | birch_plywood_candidate | 266.0 | 20.0 | 20.0 | 105.44966822228913 | DRAFT_not_released | Rear_cleat_bottom_E03_DRAFT.dxf
Rear_cleat_top | 1 | birch_plywood_candidate | 266.0 | 20.0 | 20.0 | 105.44966822228913 | DRAFT_not_released | Rear_cleat_top_E03_DRAFT.dxf
Service_partition | 1 | birch_plywood_candidate | 306.0 | 185.99999999999994 | 11.999999999999993 | 682.9919999999994 | DRAFT_not_released | Service_partition_E03_DRAFT.dxf
Service_floor | 1 | birch_plywood_candidate | 306.0 | 122.09850915300002 | 12.000000000000028 | 438.74572560981716 | DRAFT_not_released | Service_floor_E03_DRAFT.dxf
Brace_lower | 1 | birch_plywood_candidate | 306.0 | 20.0 | 11.999999999999993 | 73.43999999999996 | DRAFT_not_released | Brace_lower_E03_DRAFT.dxf
Rear_thread_plate_left_0.15 | 1 | steel_candidate | 40.0 | 20.0 | 5.0 | 3.860042047282569 | DRAFT_not_released | Rear_thread_plate_left_0.15_E03_DRAFT.dxf
Rear_thread_plate_left_0.5 | 1 | steel_candidate | 40.0 | 20.0 | 5.0 | 3.860042047282569 | DRAFT_not_released | Rear_thread_plate_left_0.5_E03_DRAFT.dxf
Rear_thread_plate_left_0.85 | 1 | steel_candidate | 40.0 | 20.0 | 5.0 | 3.860042047282569 | DRAFT_not_released | Rear_thread_plate_left_0.85_E03_DRAFT.dxf
Rear_thread_plate_right_0.15 | 1 | steel_candidate | 40.0 | 20.0 | 5.0 | 3.8600420472825694 | DRAFT_not_released | Rear_thread_plate_right_0.15_E03_DRAFT.dxf
Rear_thread_plate_right_0.5 | 1 | steel_candidate | 40.0 | 20.0 | 5.0 | 3.8600420472825694 | DRAFT_not_released | Rear_thread_plate_right_0.5_E03_DRAFT.dxf
Rear_thread_plate_right_0.85 | 1 | steel_candidate | 40.0 | 20.0 | 5.0 | 3.8600420472825694 | DRAFT_not_released | Rear_thread_plate_right_0.85_E03_DRAFT.dxf
Rear_thread_plate_bottom_0.27 | 1 | steel_candidate | 40.0 | 20.0 | 5.0 | 3.860042047282568 | DRAFT_not_released | Rear_thread_plate_bottom_0.27_E03_DRAFT.dxf
Rear_thread_plate_bottom_0.73 | 1 | steel_candidate | 40.0 | 20.0 | 5.0 | 3.8600420472825694 | DRAFT_not_released | Rear_thread_plate_bottom_0.73_E03_DRAFT.dxf
Rear_thread_plate_top_0.27 | 1 | steel_candidate | 40.0 | 20.0 | 5.0 | 3.860042047282568 | DRAFT_not_released | Rear_thread_plate_top_0.27_E03_DRAFT.dxf
Rear_thread_plate_top_0.73 | 1 | steel_candidate | 40.0 | 20.0 | 5.0 | 3.8600420472825694 | DRAFT_not_released | Rear_thread_plate_top_0.73_E03_DRAFT.dxf
