daniel-streetec/open_loud/hardware/mechanical/exports/Baffle_E02_DRAFT.dxf

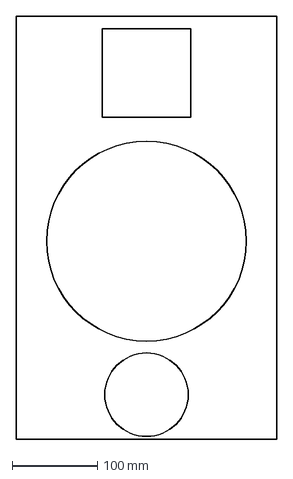
[picture p6: CAD file, 2026-11-09]
hardware/mechanical/exports/Baffle_E02_DRAFT.dxf
306.0 x 496.0 mm
