daniel-streetec/open_loud/hardware/mechanical/exports/E03/Side_left_E03_DRAFT.dxf

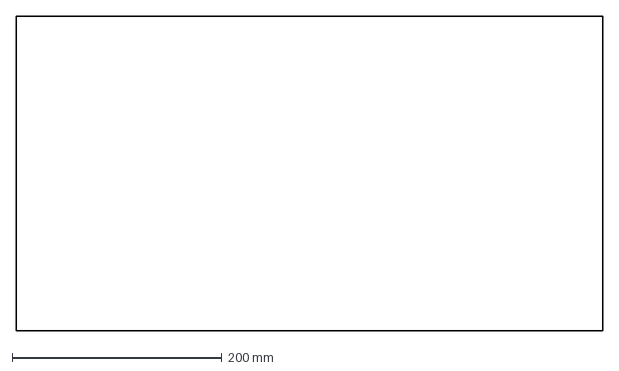
[picture p7: CAD file, 2026-11-09]
hardware/mechanical/exports/E03/Side_left_E03_DRAFT.dxf
560.0 x 300.0 mm
