daniel-streetec/open_loud/hardware/mechanical/exports/E06/OPEN_LOUD_A0_E06.step

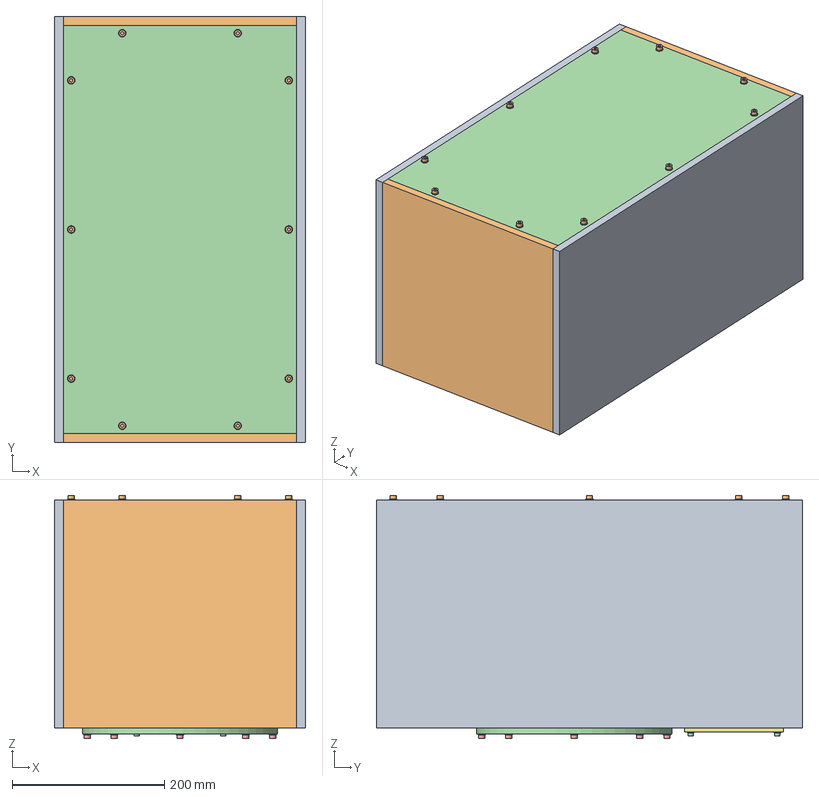
[picture p9: CAD file, 2026-11-10]
hardware/mechanical/exports/E06/OPEN_LOUD_A0_E06.step
330.0 x 560.0 x 320.0 mm
