daniel-streetec/open_loud/hardware/mechanical/exports/E07/subassemblies/BG30_Service_Rueckwand.step

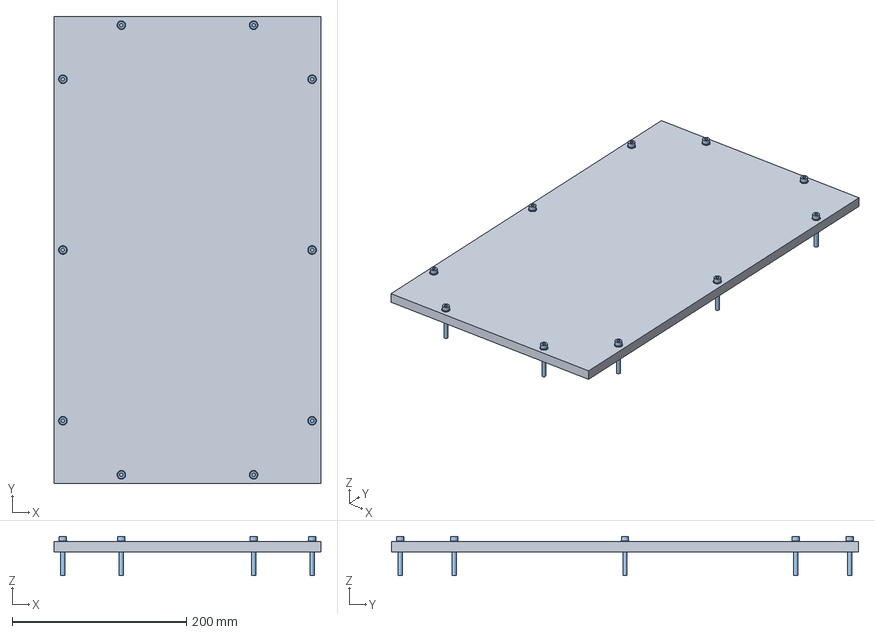
[picture p10: CAD file, 2026-11-10]
hardware/mechanical/exports/E07/subassemblies/BG30_Service_Rueckwand.step
306.0 x 536.0 x 45.0 mm
