daniel-streetec/open_loud/hardware/mechanical/exports/E08/OPEN_LOUD_A0_E08_checkpoint.step

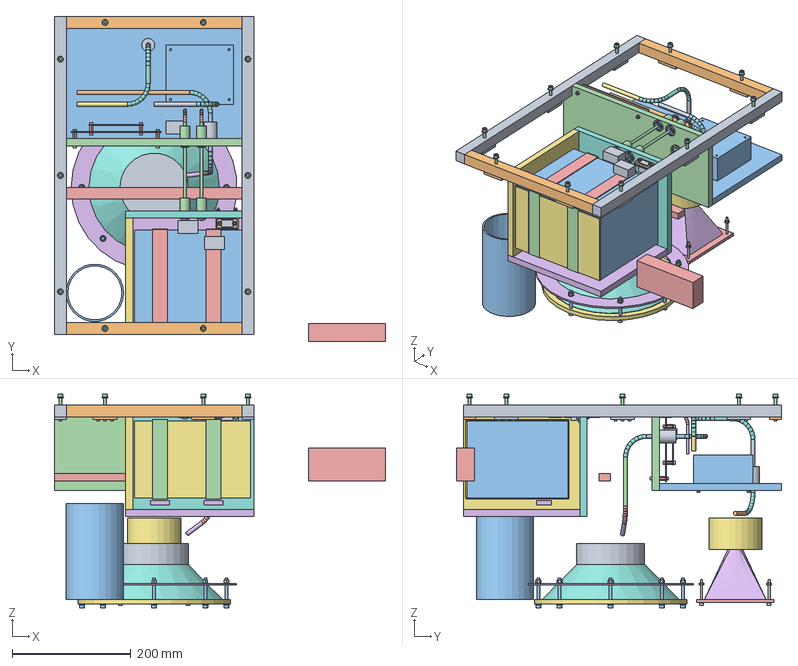
[picture p11: CAD file, 2026-11-10]
hardware/mechanical/exports/E08/OPEN_LOUD_A0_E08_checkpoint.step
558.0 x 548.0 x 360.0 mm
OWN_PLY12_BATTERY_FRONT
OWN_PLY12_BATTERY_LEFT
OWN_PLY12_BATTERY_ROOF
LAPP_53017210
SKINDICHT_SM_M_16
LAPP_53017210_1
SKINDICHT_SM_M_16_1
LAPP_53010000
SKINDICHT_SM_M_12
LAPP_53010000_1
SKINDICHT_SM_M_12_1
LAPP_53010000_2
SKINDICHT_SM_M_12_2
LAPP_53010000_3
SKINDICHT_SM_M_12_3
ISO7089_M3
ISO4762_M3x20
ISO7089_M3_1
ISO4762_M3x20_1
ISO7089_M3_2
ISO4762_M3x20_2
ISO7089_M3_3
ISO4762_M3x20_3
LITTELFUSE_FHAC0001ZXJ
ISO7089_M3_4
ISO4032_M3
ISO7089_M3_5
ISO4032_M3_1
ISO7089_M3_6
ISO4032_M3_2
ISO7089_M3_7
ISO4032_M3_3
VICTRON_ORI122410110
WIRE_4MM2_SINGLE
WIRE_4MM2_SINGLE_1
CORDIAL_CLS215
CORDIAL_CLS215_1
CORDIAL_CLS215_2
REFERENCE_TERMINAL_CLEARANCE
EREMIT_12V50Ah_MICRO_GEN7_BASIS
MASTERLOCK_3110EURDAT
MASTERLOCK_3110EURDAT_BUCKLE
MASTERLOCK_3110EURDAT_1
MASTERLOCK_3110EURDAT_BUCKLE_1
OWN_BATTERY_PAD_3MM
LITTELFUSE_FHAC0002ZXJ
LITTELFUSE_FHAC0001ZXJ_1
OWN_AL2_XT60_INTERNAL_BRACKET
AMASS_XT60E_F
ISO4762_M3x10
ISO7089_M3_8
ISO4032_M3_4
ISO4762_M3x10_1
ISO7089_M3_9
ISO4032_M3_5
ISO7089_M3_10
ISO7089_M3_11
ISO4762_M3x20_4
ISO4032_M3_6
ISO7089_M3_12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
