daniel-streetec/open_loud/hardware/mechanical/exports/E09/OPEN_LOUD_A0_E09.step

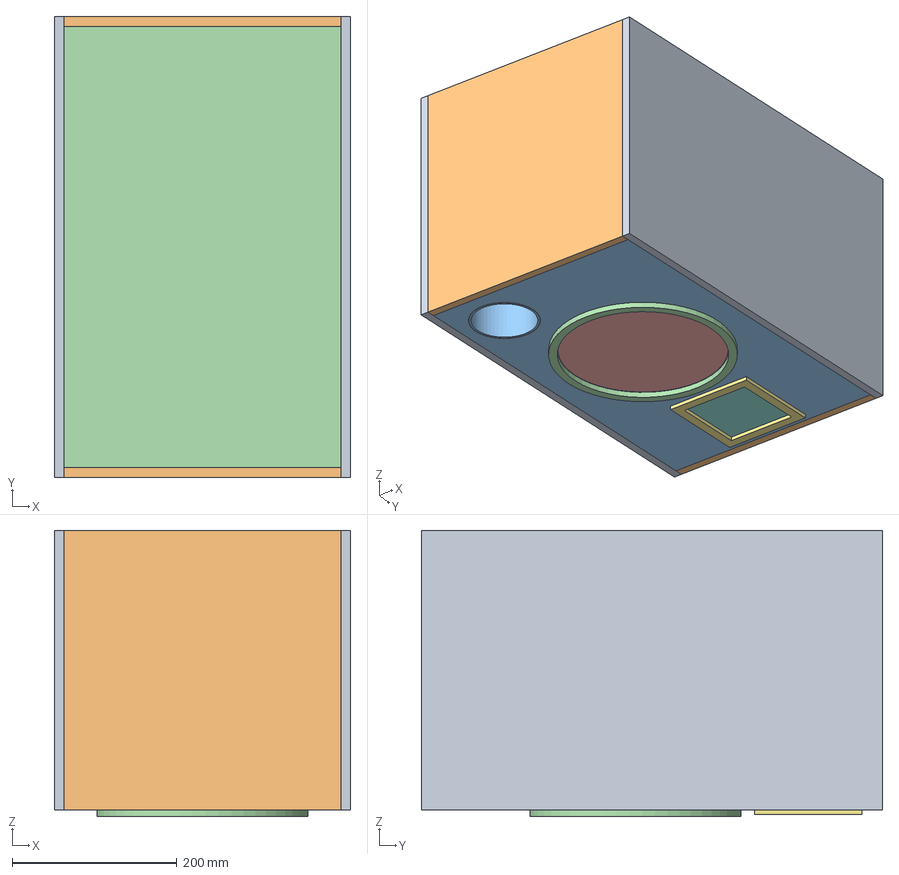
[picture p12: CAD file, 2026-11-10]
hardware/mechanical/exports/E09/OPEN_LOUD_A0_E09.step
360.0 x 560.0 x 348.0 mm
