daniel-streetec/open_loud/hardware/mechanical/exports/Bottom_E02_DRAFT.dxf

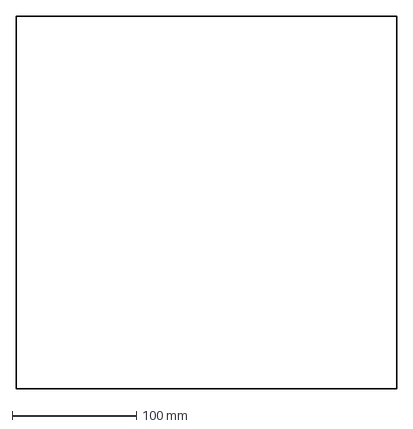
[picture p13: CAD file, 2026-11-09]
hardware/mechanical/exports/Bottom_E02_DRAFT.dxf
306.0 x 300.0 mm
