daniel-streetec/open_loud/hardware/mechanical/exports/E05/Service_floor_E05_LF_inside_counterbore.dxf

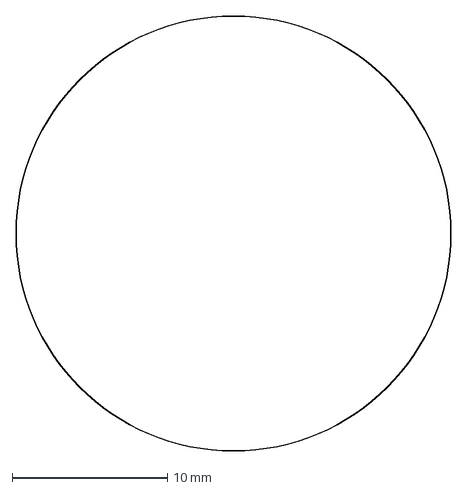
[picture p15: CAD file, 2026-11-09]
hardware/mechanical/exports/E05/Service_floor_E05_LF_inside_counterbore.dxf
28.0 x 28.0 mm
