daniel-streetec/open_loud/hardware/mechanical/exports/E07/subassemblies/BG50_Kabelbaum.step

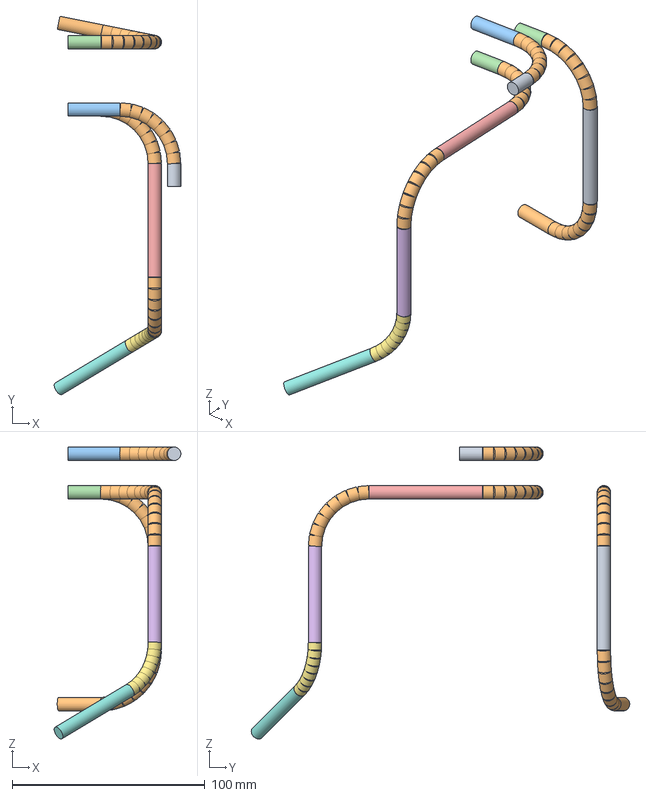
[picture p17: CAD file, 2026-11-10]
hardware/mechanical/exports/E07/subassemblies/BG50_Kabelbaum.step
65.8 x 196.5 x 151.6 mm
