daniel-streetec/open_loud/hardware/mechanical/exports/E09/OPEN_LOUD_A0_E09_checkpoint.step

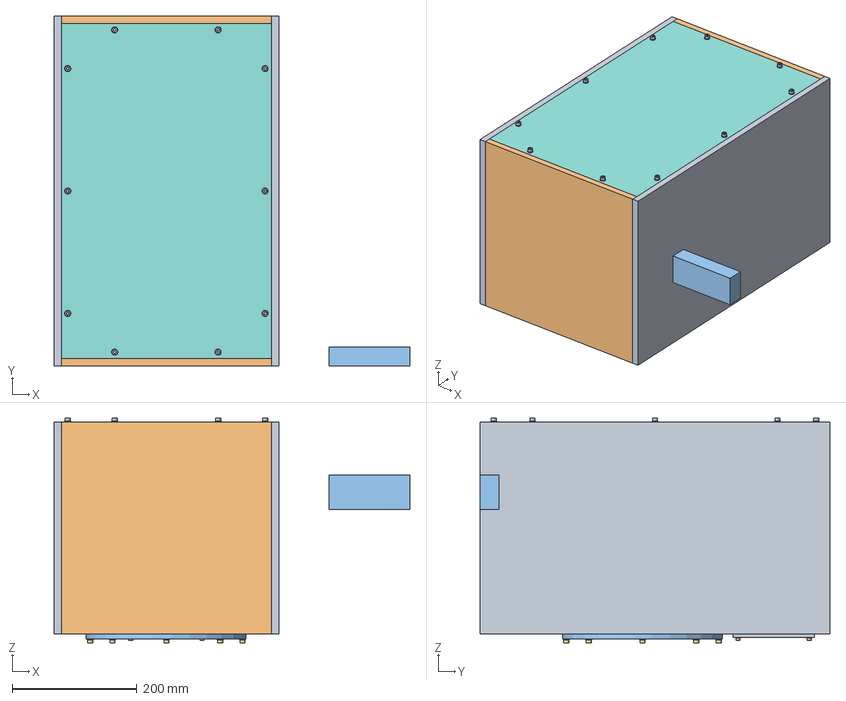
[picture p18: CAD file, 2026-11-10]
hardware/mechanical/exports/E09/OPEN_LOUD_A0_E09_checkpoint.step
570.0 x 560.0 x 360.0 mm
OWN_PLY12_BATTERY_FRONT
OWN_PLY12_BATTERY_LEFT
OWN_PLY12_BATTERY_ROOF
OWN_PLY12_BATTERY_RIGHT
OWN_WOOD_BATTERY_RUNNER_25_20_130
OWN_WOOD_BATTERY_RUNNER_25_20_130_1
LAPP_53017210
SKINDICHT_SM_M_16
LAPP_53017210_1
SKINDICHT_SM_M_16_1
LAPP_53010000
SKINDICHT_SM_M_12
LAPP_53010000_1
SKINDICHT_SM_M_12_1
LAPP_53010000_2
SKINDICHT_SM_M_12_2
LAPP_53010000_3
SKINDICHT_SM_M_12_3
ISO7089_M3
ISO4762_M3x20
ISO7089_M3_1
ISO4762_M3x20_1
ISO7089_M3_2
ISO4762_M3x20_2
ISO7089_M3_3
ISO4762_M3x20_3
LITTELFUSE_FHAC0001ZXJ
ISO7089_M3_4
ISO4032_M3
ISO7089_M3_5
ISO4032_M3_1
ISO7089_M3_6
ISO4032_M3_2
ISO7089_M3_7
ISO4032_M3_3
VICTRON_ORI122410110
WIRE_4MM2_SINGLE
WIRE_4MM2_SINGLE_1
CORDIAL_CLS215
CORDIAL_CLS215_1
CORDIAL_CLS215_2
REFERENCE_TERMINAL_CLEARANCE
EREMIT_12V50Ah_MICRO_GEN7_BASIS
OWN_BATTERY_PAD_3MM
MASTERLOCK_3110EURDAT
MASTERLOCK_3110EURDAT_BUCKLE
MASTERLOCK_3110EURDAT_1
MASTERLOCK_3110EURDAT_BUCKLE_1
LITTELFUSE_FHAC0002ZXJ
LITTELFUSE_FHAC0001ZXJ_1
OWN_AL2_XT60_INTERNAL_BRACKET_E09
AMASS_XT60E_F
ISO4762_M3x10
ISO7089_M3_8
ISO4032_M3_4
ISO4762_M3x10_1
ISO7089_M3_9
ISO4032_M3_5
ISO7089_M3_10
ISO7089_M3_11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
