daniel-streetec/open_loud/hardware/mechanical/exports/E06/E06_tray_support_M3_2.dxf

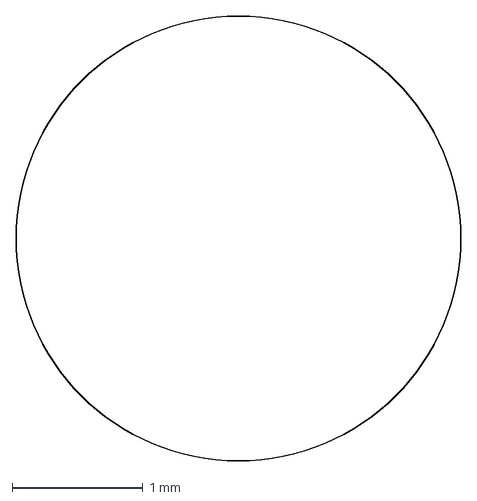
[picture p20: CAD file, 2026-11-10]
hardware/mechanical/exports/E06/E06_tray_support_M3_2.dxf
3.40 x 3.40 mm
