daniel-streetec/open_loud/hardware/mechanical/exports/E07/subassemblies/BG10_Gehaeuse.step

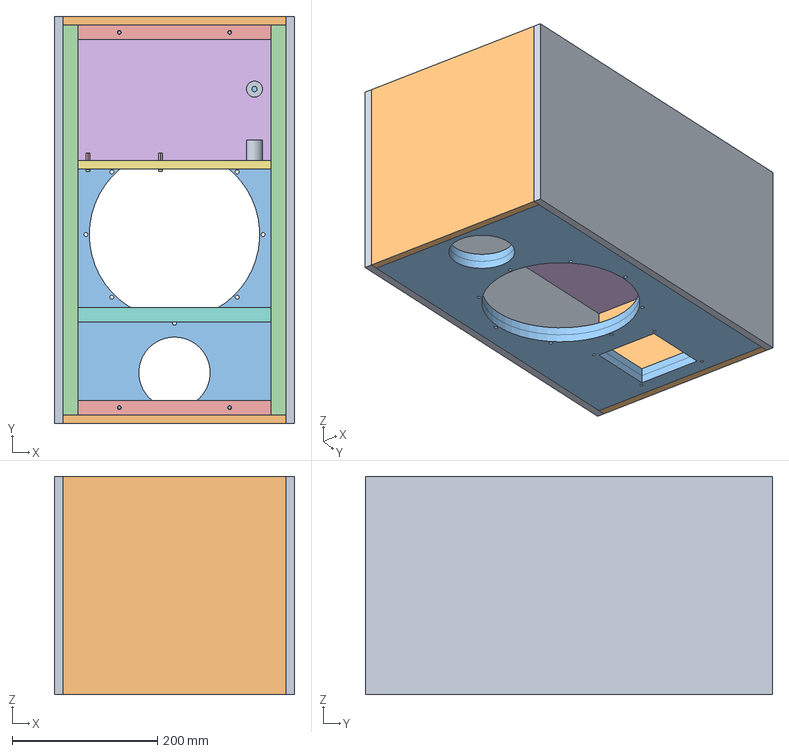
[picture p21: CAD file, 2026-11-10]
hardware/mechanical/exports/E07/subassemblies/BG10_Gehaeuse.step
330.0 x 560.0 x 300.0 mm
