daniel-streetec/open_loud/hardware/mechanical/exports/E09/Baffle_E09_DRAFT.dxf

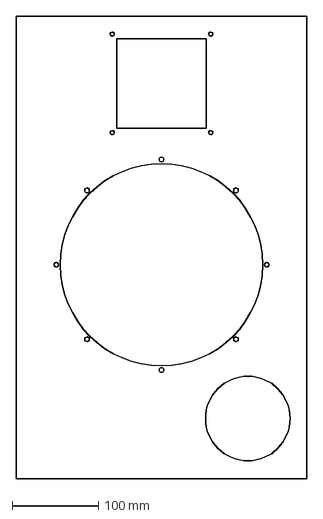
[picture p22: CAD file, 2026-11-10]
hardware/mechanical/exports/E09/Baffle_E09_DRAFT.dxf
336.0 x 536.0 mm
