daniel-streetec/open_loud/hardware/mechanical/exports/Side_left_E02_DRAFT.dxf

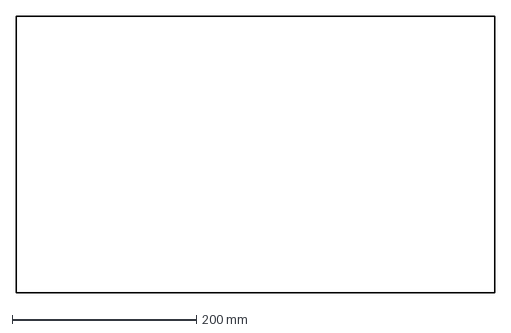
[picture p23: CAD file, 2026-11-09]
hardware/mechanical/exports/Side_left_E02_DRAFT.dxf
520.0 x 300.0 mm
