daniel-streetec/open_loud/hardware/mechanical/exports/E03/OPEN_LOUD_A0_E03.step

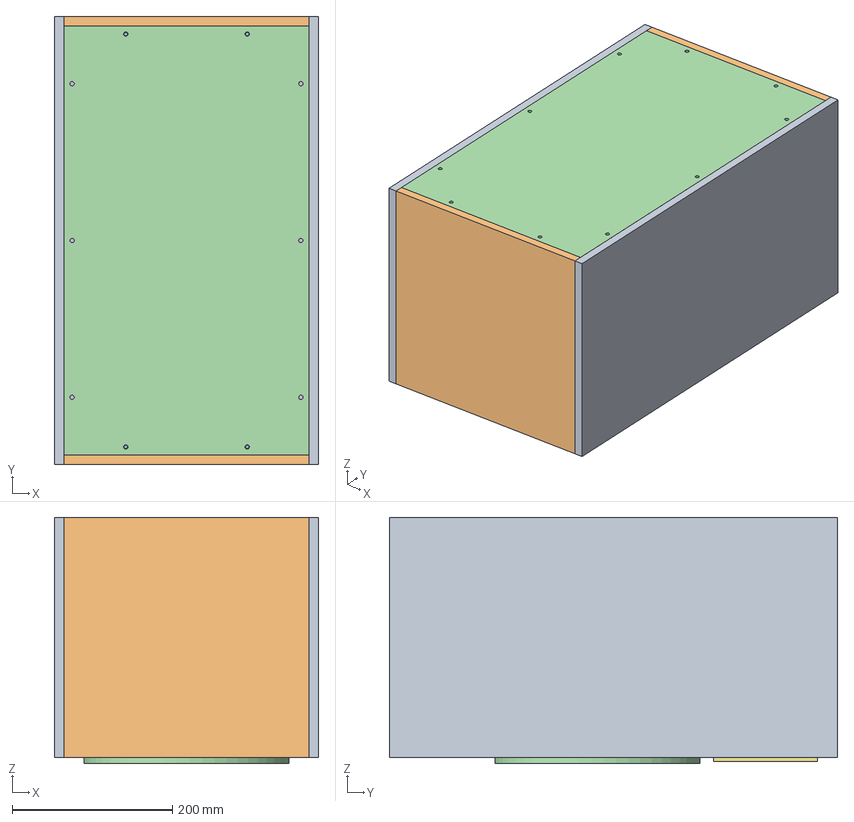
[picture p24: CAD file, 2026-11-09]
hardware/mechanical/exports/E03/OPEN_LOUD_A0_E03.step
330.0 x 560.0 x 308.0 mm
