daniel-streetec/open_loud/hardware/mechanical/exports/E06/E06_tray_112x90x2_DRAFT.dxf

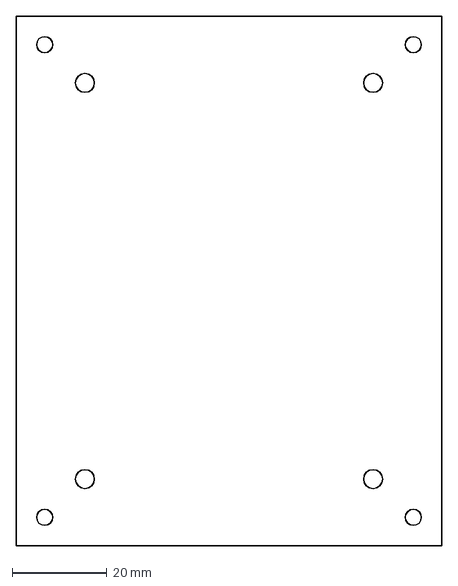
[picture p26: CAD file, 2026-11-10]
hardware/mechanical/exports/E06/E06_tray_112x90x2_DRAFT.dxf
90.0 x 112.0 mm
