daniel-streetec/open_loud/hardware/mechanical/exports/E07/subassemblies/BG20_Frontbestueckung.step

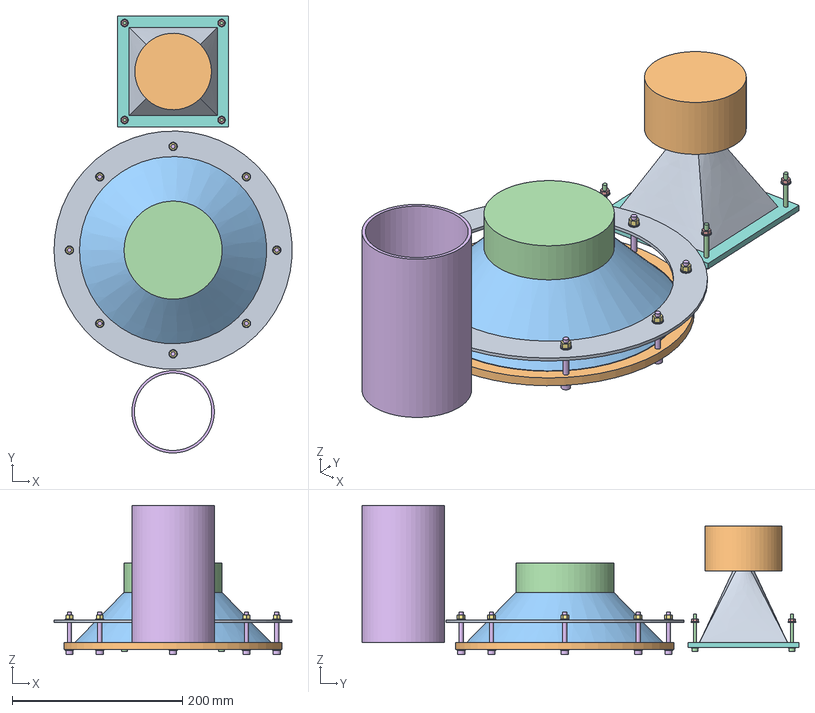
[picture p27: CAD file, 2026-11-10]
hardware/mechanical/exports/E07/subassemblies/BG20_Frontbestueckung.step
279.7 x 513.7 x 175.5 mm
