daniel-streetec/open_loud/hardware/mechanical/exports/Service_floor_E02_DRAFT.dxf

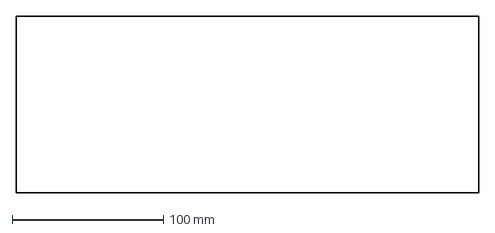
[picture p28: CAD file, 2026-11-09]
hardware/mechanical/exports/Service_floor_E02_DRAFT.dxf
306.0 x 116.4 mm
