daniel-streetec/open_loud/hardware/mechanical/exports/E05/Service_partition_E05_HF_M16_through.dxf

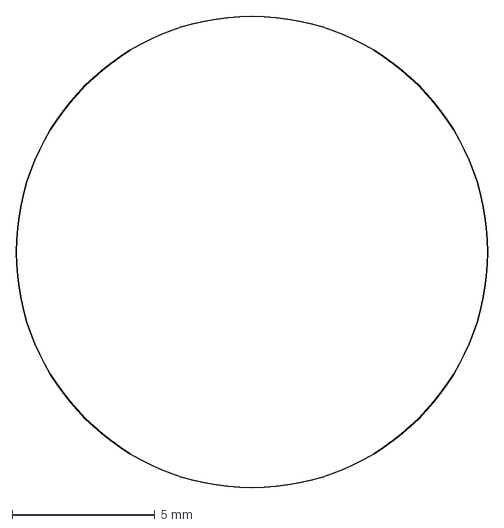
[picture p29: CAD file, 2026-11-09]
hardware/mechanical/exports/E05/Service_partition_E05_HF_M16_through.dxf
16.5 x 16.5 mm
