daniel-streetec/open_loud/hardware/mechanical/exports/E06/E06_tray_support_M3_0.dxf

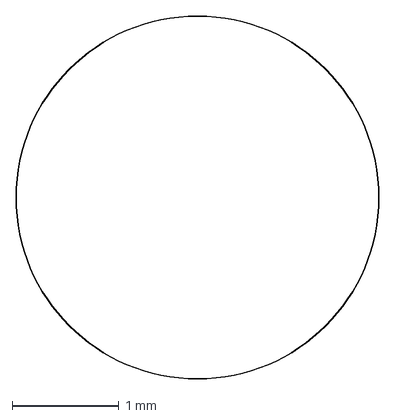
[picture p30: CAD file, 2026-11-10]
hardware/mechanical/exports/E06/E06_tray_support_M3_0.dxf
3.40 x 3.40 mm
