daniel-streetec/open_loud/hardware/mechanical/exports/E07/subassemblies/BG40_Elektronikmodul.step

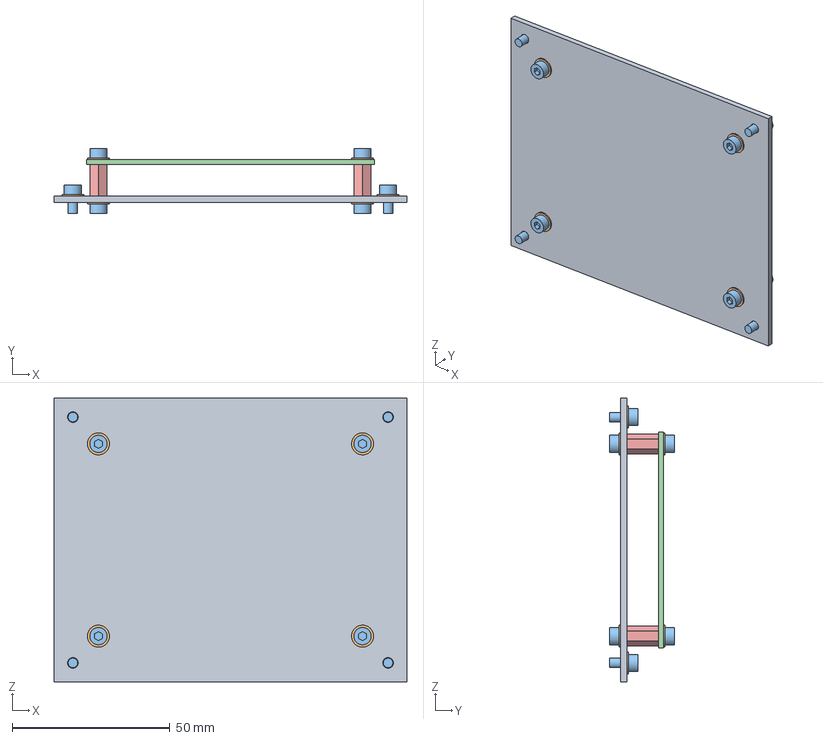
[picture p31: CAD file, 2026-11-10]
hardware/mechanical/exports/E07/subassemblies/BG40_Elektronikmodul.step
112.0 x 20.6 x 90.0 mm
