daniel-streetec/open_loud/hardware/mechanical/exports/Brace_lower_E02_DRAFT.dxf

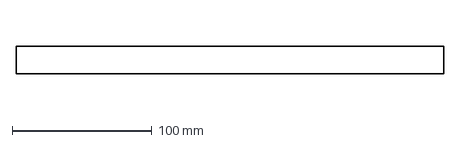
[picture p32: CAD file, 2026-11-09]
hardware/mechanical/exports/Brace_lower_E02_DRAFT.dxf
306.0 x 20.0 mm
