daniel-streetec/open_loud/hardware/mechanical/exports/E03/Rear_gasket_recess_E03_DRAFT.dxf

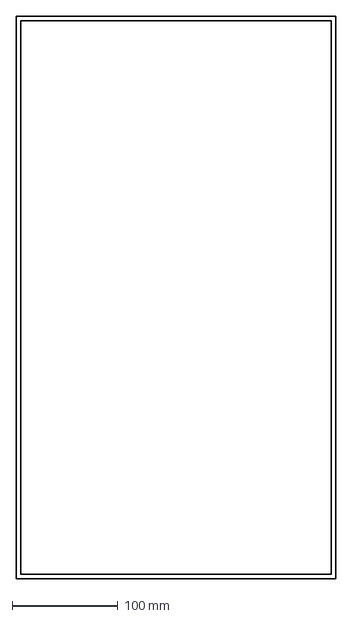
[picture p33: CAD file, 2026-11-09]
hardware/mechanical/exports/E03/Rear_gasket_recess_E03_DRAFT.dxf
302.0 x 532.0 mm
