daniel-streetec/open_loud/hardware/mechanical/exports/E03/Rear_thread_plate_left_0.5_E03_DRAFT.dxf

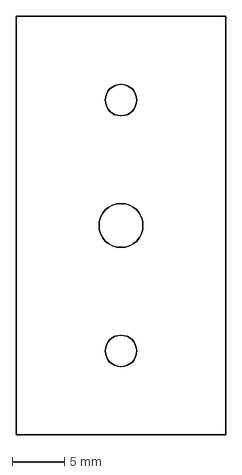
[picture p35: CAD file, 2026-11-09]
hardware/mechanical/exports/E03/Rear_thread_plate_left_0.5_E03_DRAFT.dxf
20.0 x 40.0 mm
