daniel-streetec/open_loud/hardware/mechanical/exports/OPEN_LOUD_A0_E02.step

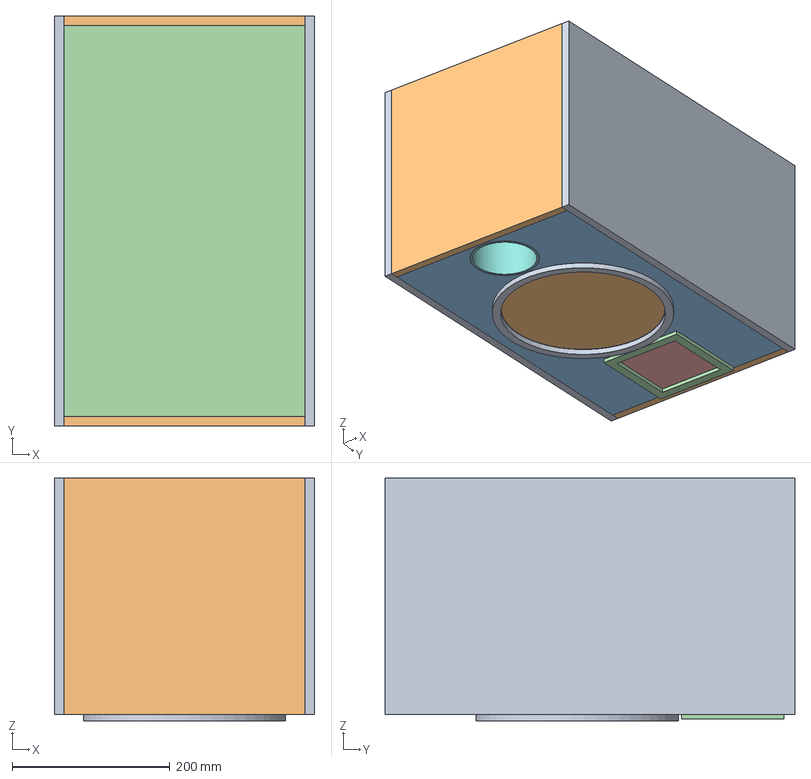
[picture p36: CAD file, 2026-11-09]
hardware/mechanical/exports/OPEN_LOUD_A0_E02.step
330.0 x 520.0 x 308.0 mm
