daniel-streetec/open_loud/hardware/mechanical/exports/E03/LF_steel_backing_ring_candidate_E03_DRAFT.dxf

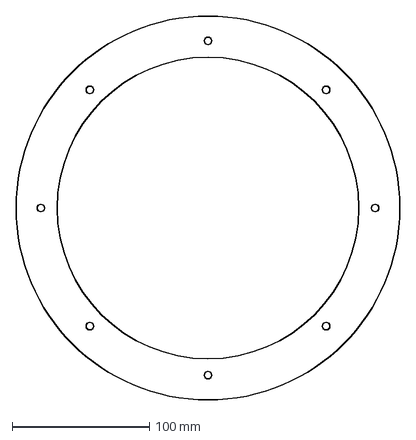
[picture p37: CAD file, 2026-11-09]
hardware/mechanical/exports/E03/LF_steel_backing_ring_candidate_E03_DRAFT.dxf
280.0 x 280.0 mm
