daniel-streetec/open_loud/hardware/mechanical/exports/E03/Rear_thread_plate_top_0.27_E03_DRAFT.dxf

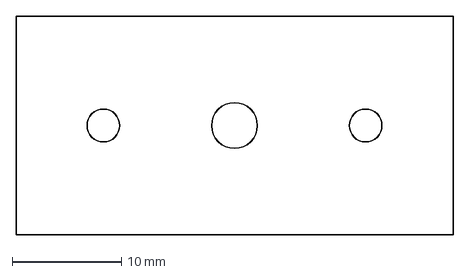
[picture p38: CAD file, 2026-11-09]
hardware/mechanical/exports/E03/Rear_thread_plate_top_0.27_E03_DRAFT.dxf
40.0 x 20.0 mm
