daniel-streetec/open_loud/hardware/mechanical/exports/Service_partition_E02_DRAFT.dxf

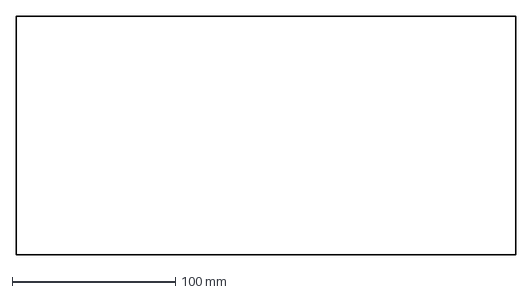
[picture p39: CAD file, 2026-11-09]
hardware/mechanical/exports/Service_partition_E02_DRAFT.dxf
306.0 x 146.0 mm
