daniel-streetec/open_loud/hardware/mechanical/exports/E03/Service_floor_E03_DRAFT.dxf

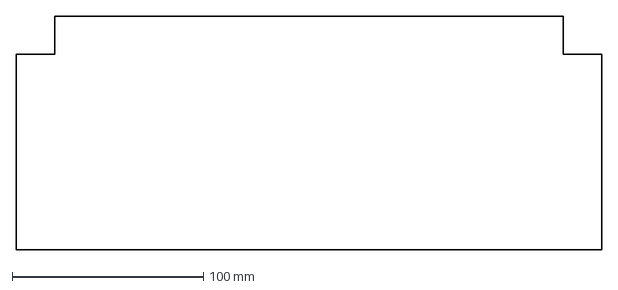
[picture p40: CAD file, 2026-11-09]
hardware/mechanical/exports/E03/Service_floor_E03_DRAFT.dxf
306.0 x 122.1 mm
