daniel-streetec/open_loud/hardware/mechanical/exports/Rear_removable_E02_DRAFT.dxf

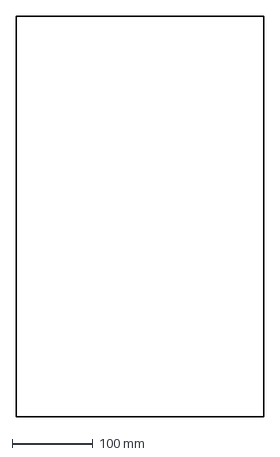
[picture p41: CAD file, 2026-11-09]
hardware/mechanical/exports/Rear_removable_E02_DRAFT.dxf
306.0 x 496.0 mm
