daniel-streetec/open_loud/hardware/mechanical/exports/E03/Rear_cleat_top_E03_DRAFT.dxf

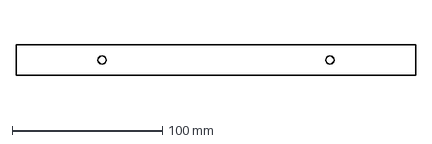
[picture p42: CAD file, 2026-11-09]
hardware/mechanical/exports/E03/Rear_cleat_top_E03_DRAFT.dxf
266.0 x 20.0 mm
