daniel-streetec/open_loud/hardware/mechanical/exports/E03/Rear_thread_plate_left_0.85_E03_DRAFT.dxf

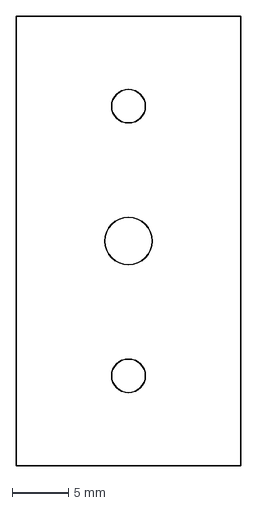
[picture p45: CAD file, 2026-11-09]
hardware/mechanical/exports/E03/Rear_thread_plate_left_0.85_E03_DRAFT.dxf
20.0 x 40.0 mm
