daniel-streetec/open_loud/hardware/mechanical/exports/E03/Rear_cleat_right_E03_DRAFT.dxf

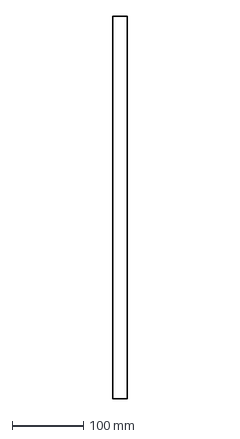
[picture p47: CAD file, 2026-11-09]
hardware/mechanical/exports/E03/Rear_cleat_right_E03_DRAFT.dxf
20.0 x 536.0 mm
