daniel-streetec/open_loud/hardware/mechanical/exports/E03/Baffle_E03_DRAFT.dxf

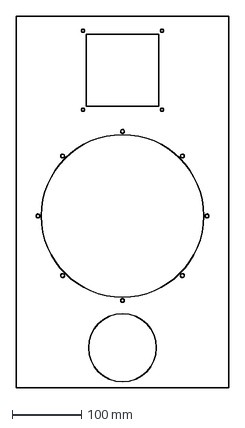
[picture p48: CAD file, 2026-11-09]
hardware/mechanical/exports/E03/Baffle_E03_DRAFT.dxf
306.0 x 536.0 mm
