daniel-streetec/open_loud/hardware/mechanical/exports/E03/Rear_thread_plate_bottom_0.73_E03_DRAFT.dxf

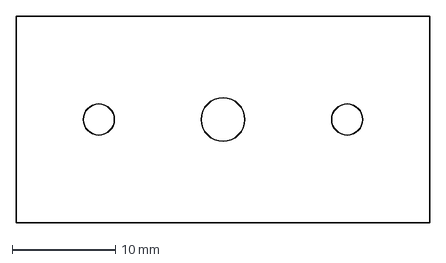
[picture p52: CAD file, 2026-11-09]
hardware/mechanical/exports/E03/Rear_thread_plate_bottom_0.73_E03_DRAFT.dxf
40.0 x 20.0 mm
