daniel-streetec/open_loud/hardware/mechanical/exports/E03/Service_partition_E03_DRAFT.dxf

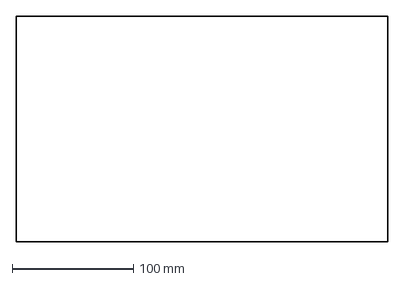
[picture p55: CAD file, 2026-11-09]
hardware/mechanical/exports/E03/Service_partition_E03_DRAFT.dxf
306.0 x 186.0 mm
