daniel-streetec/open_loud/(list of files, cad)

Other CAD files:
hardware/mechanical/exports/E07/OPEN_LOUD_A0_E07.step
hardware/mechanical/exports/E08/OPEN_LOUD_A0_E08.step
hardware/mechanical/exports/E05/OPEN_LOUD_A0_E05.step
hardware/mechanical/exports/E03/OPEN_LOUD_A0_E03.f3d
hardware/mechanical/exports/E05/OPEN_LOUD_A0_E05.f3d
hardware/mechanical/exports/E06/OPEN_LOUD_A0_E06.f3d
hardware/mechanical/exports/E06/OPEN_LOUD_A0_E06_PAUSED.f3d
hardware/mechanical/exports/E07/OPEN_LOUD_A0_E07.f3d
hardware/mechanical/exports/E08/OPEN_LOUD_A0_E08.f3d
hardware/mechanical/exports/E08/OPEN_LOUD_A0_E08_checkpoint.f3d
hardware/mechanical/exports/E09/OPEN_LOUD_A0_E09.f3d
hardware/mechanical/exports/E09/OPEN_LOUD_A0_E09_checkpoint.f3d
hardware/mechanical/exports/OPEN_LOUD_A0_E02.f3d
