daniel-streetec/open_loud/docs/build/mechanical_assembly.md

# Mechanische Montagefolge E03 – Entwurf

Diese Folge prüft die Zugänglichkeit des Vorentwurfs. Erst nach Bauteilmaßkontrolle, vollständiger Hardware-Spezifikation und Trockenmontage fertigen. Keine elektrische Inbetriebnahme nach dieser Anleitung.

1. Original-Tieftöner, DE10/Horn-Paar und Muster des Portrohres beschaffen bzw. ausmessen. Schnittdurchmesser, Lochkreis, Langlochlage, Flanschdicke und Korbfreiraum gegen CAD prüfen. Besonders den 220-mm-Innendurchmesser des Gegenrings bei 24 mm Schallwandtiefe kontrollieren. Das Hornblatt zeigt 130 mm Front, die Produktseite 130,5 mm; das Modell behält die größere Hülle. Keine Bohrschablone ohne Musterprüfung freigeben.
2. Beide Schallwandlagen bearbeiten, ausrichten und flächig unter gleichmäßigem Druck verleimen. Innere Lage ist kein bloß verschraubtes loses Doppelbrett. Klebstoffdaten, Presszeit und beschichtungsfreie Leimflächen vorab festlegen. Durchgangsbohrungen zuletzt gemeinsam nacharbeiten.
3. M5-Gegenring trocken einsetzen, Kanten entgraten und Korrosionsschutz festlegen. Acht gemeinsame Bohrungsachsen müssen ohne Zwang passen. Geplant sind M5-Durchgangsschrauben mit Muttern hinter dem Stahlring, kein Einschlagmutterflansch in der schmalen Holzlippe. Längenkandidat M5×45: Flansch 8 mm + Holz 24 mm + Stahl 3 mm + Mutter/Unterlage und Gewindeüberstand am Muster prüfen. Anzugsmoment offen, erst durch Klemm-/Auszugsversuch bestimmen.
4. Horn und Kompressionstreiber vormontieren. DE10 hat laut Hersteller zwei M5-Aufnahmen auf 76-mm-Lochkreis; das ME10V3-Blatt zeigt passende rückseitige Positionen. Schraubenlänge/Einschraubtiefe am Original prüfen. Für die Schallwand sind vier M4-Durchgänge auf 114×114 mm vorgesehen; Längenkandidat M4×40 mit passenden Unterlagen und Muttern. Horn nicht durch überlange Schrauben beschädigen.
5. Zuerst Schallwand, linke Seite, Boden und Deckel trocken zusammenlegen. Versteifung und Fachwände einsetzen. Die Rückleisten müssen durchgehend bleiben; die hinteren Ecken des Fachbodens sind für diese Leisten ausgeklinkt. Schablonen und Referenzkanten markieren, rechte Seite erst nach geprüftem Zugang verleimen.
6. Vor Verschließen der rechten Seite Gegenring, hintere Gewindeplatten und die erforderlichen Halteschrauben montieren. Geplante hintere Platten: 20×40×5 mm Stahl, je M5×0,8; zwei kleine Halteschrauben sichern die Platten beim Öffnen. Geplant 10× M5×40 für Rückwand + 20-mm-Leiste + 5-mm-Gewindeplatte; Unterlagen/Dichtscheiben und Längen am Muster bestätigen. Die kleinen Halteschrauben tragen nicht die Rückwandklemmung.
7. Portrohr trocken einpassen. Sein CAD-Außendurchmesser ist aus 65 cm² Innenfläche und 3 mm Rohrwand abgeleitet, kein bereits belegtes Normrohr. Der 0,5-mm-radiale Montagespalt muss mit qualifiziertem Klebe-/Dichtsystem geschlossen werden. Mit veränderbarer Rohrlänge beginnen und Fb messen. Rohr vor Gittermontage ausbauen können oder einen austauschbaren Einsatz vorsehen; diese Servicelösung ist noch nicht fertig konstruiert.
8. Horn von vorn einbauen, seine Muttern zunächst durch die noch offene LF-Öffnung bzw. die offene Rückseite erreichen. Danach Tieftöner einsetzen und die acht Muttern am Gegenring über die große offene Rückseite ansetzen. Werkzeug muss an Korb, Fach und Port vorbeipassen; dies ist am Muster nachzuweisen. Treiberdichtung vorsehen und auf gleichmäßiges Anliegen prüfen.
9. Rückwanddichtung in den eigenen Nutgang einsetzen. Geplant geschlossenzelliger Schaum, dessen komprimierte Dicke zur 1-mm-Nut passt; Produkt und Kompressionskraft sind offen. Schraubendurchgänge liegen innerhalb der umlaufenden Dichtlinie und benötigen eigene geeignete Dichtscheiben, wenn Feuchteschutz gefordert wird. Rückwand zuletzt von außen verschrauben. Öffnen muss ohne Demontage der Tragstruktur möglich sein.
10. Vor Elektronikmontage Leckprüfung, lose Teile, Holzspanfreiheit, wiederholte Rückwandmontage und Werkzeugzugang prüfen. Elektronikfach und LF-Kammer getrennt auf Lecks prüfen. Gehäuse wiegen. Belastungs- und Transportprüfung gemäß Prüfplan, anschließend erst elektrische Integration.

Offen: genaue Schrauben-/Muttern-/Scheiben-SKUs, Gewindelängen, Anzugsmomente, Korrosionspaarungen, Klebstoff, Dichtungsmaterial, Horn-Rückflanschdetail und Elektro-/Akkumontage. Diese Anleitung ist noch kein reproduzierbar freigegebener Bauzustand.
