daniel-streetec/open_loud/docs/build/service_connections_E09.md

# Anschluss- und Wartungsplanung E09

Der neue Akku-Auszug löst nur die räumliche Passage. Es ist noch kein vollständiger Ausbauvorgang, solange Leitungen, Halter und Polschutz fehlen. Insbesondere reichen wenige Millimeter über den M6-Polen nicht für einen frei zugänglichen Steckschlüssel. Die Pack-Ringanschlüsse sollen deshalb beim normalen Ausbau am Akku bleiben; eine passende interne Trennstelle kommt in die zugängliche Leitung.

Technisch ausgewählt: **AMASS XT90S-F + XT90H-M**, ein Paar mit Endkappen. [MHM-Modellbau](https://www.mhm-modellbau.de/part-AM-XT90S.php) zeigte4,05EUR inklusive Steuer, lagernd/1–2Werktage, ein Paar. Gegenüber dem schon eingesetzten XT60-Ladeport ist das mechanisch eine andere Baugröße. Kein generischer„90A“-Werbewert: der [Herstellerkatalog](https://www.china-amass.com/public/upload/20250319/41b7a7787d7c61edc3371469ba98f193.pdf) nennt45A mit10AWG unter seinen Temperaturbedingungen undIP40. Unsere4-mm²-Anschlüsse bei bis12A brauchen weiterhin Löt-, Isolations-, Zug- und Temperaturprüfung. Vollständig stecken, vor dem Trennen ausschalten; die Vorladestufe ersetzt weder Betriebsschalter noch Verpolschutz.

Noch **nicht im CAD verbaut**. Modell und Kabel müssen so entstehen, dass beide isolierten Steckerhälften bei abgenommener Rückwand greifbar sind und nicht erst M6-Ringösen unter dem Dach gelöst werden müssen. Eine angedachte lose Serviceleitung braucht eine definierte, gesicherte Ablage und ausreichende Lösereserve; diese darf nicht bloß rechnerisch zur Zuschnittlänge addiert werden.

Vorgesehene Topologie zur weiteren Ausarbeitung: Batterie+ → möglichst packnahe F1 → Trennstecker → Abzweig. Verstärkerzweig über Verpolschutz/Orion/F3 zum JAB; Ladezweig überF2 zum internen XT60. F1 soll mit dem Batterie-Pigtail verbunden bleiben. Die Ladung muss den rückstromsperrenden Verpolschutz des Verstärkerzweigs umgehen. Exakte Polkoordinaten, Länge des ungesicherten Stücks, Sicherungs-Fehlerstromkoordination und Halterbefestigung bleiben offene Freigabepunkte. Keine vollständig realisierte Schutzkette behaupten.

Vergleich: genuine Anderson-SB50-Gehäuse992-BK und Kontakte5915-BK sind bei MyBait einzeln für4,95EUR beziehungsweise2,10EUR und1–3Werktage gelistet. Ein vollständiges Paar benötigt2Gehäuse und4Kontakte:18,30EUR ohne Versand und Crimpwerkzeug. Der größere Querschnittsbereich3,3–5,3mm² passt zu4mm²; die Baugröße und Betätigung passen schlechter zum engen Seitenkorridor als XT90S.992G1 ist rot, nicht grau. Händler-Farbspannungsangaben nicht als universelle Herstellernorm behandeln. Für die engere Konstruktion wird deshalb zunächstXT90S weiterverfolgt.

Kantenschutz wird ebenfalls als **fertiges Kaufteil** weiterverfolgt: AdamHall4072, vier versenkte3,5-mm-Löcher, Kunststoff3mm, Innenradius6mm. Herstellerdaten und Thomann-Einzelbezug sind unter `data/procurement_E09_additions.json` dokumentiert. Erst Lochkoordinaten, Außenradien, Portfreiheit und Rückwandzugang klären; keine eigenen Blech-Ecken und keine ungeprüften Bohrungen anlegen. Noch nicht im Modell vorhanden.
