daniel-streetec/open_loud/hardware/mechanical/exports/E07/subassemblies/BG20_Frontbestueckung.png

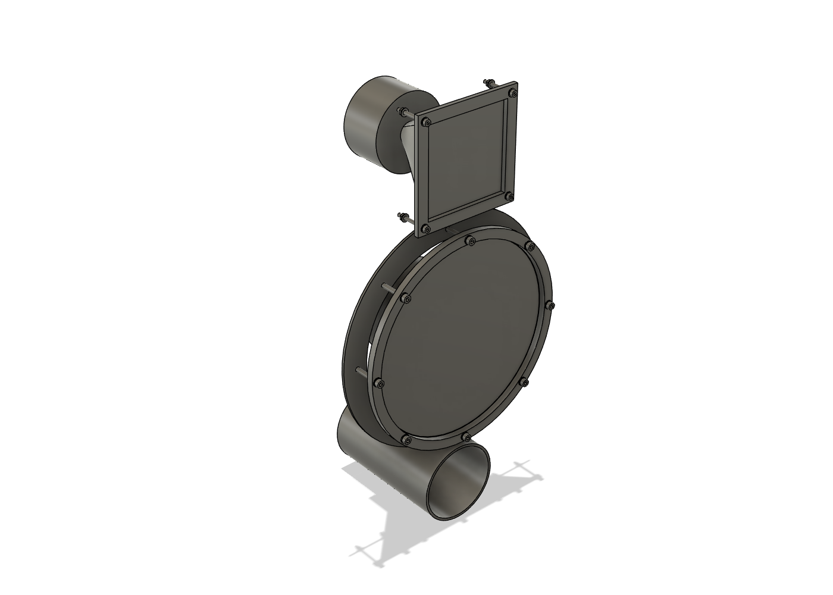
hardware/mechanical/exports/E07/subassemblies/BG20_Frontbestueckung.png
