daniel-streetec/open_loud/hardware/mechanical/exports/E07/subassemblies/BG30_Service_Rueckwand.png

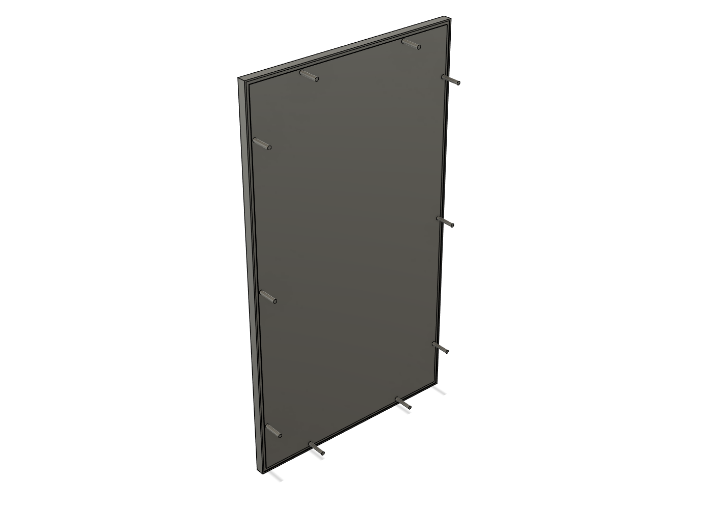
hardware/mechanical/exports/E07/subassemblies/BG30_Service_Rueckwand.png
