daniel-streetec/open_loud/hardware/mechanical/exports/E07/subassemblies/BG40_Elektronikmodul.png

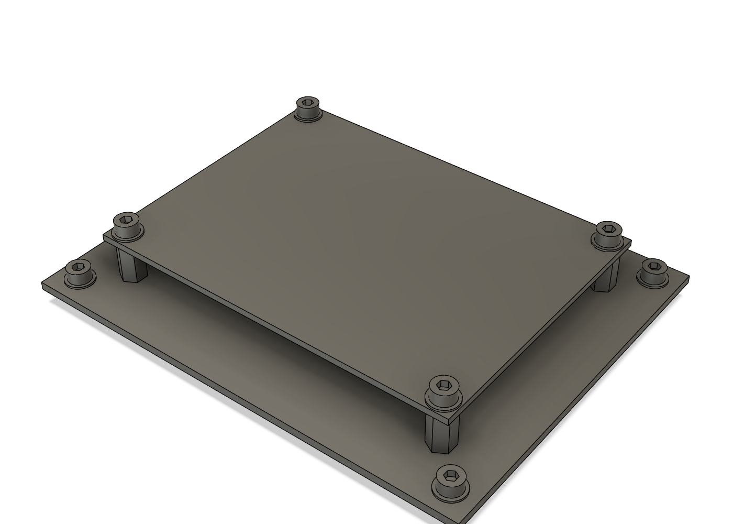
hardware/mechanical/exports/E07/subassemblies/BG40_Elektronikmodul.png
