daniel-streetec/open_loud/hardware/mechanical/exports/E07/subassemblies/BG50_Kabelbaum.png

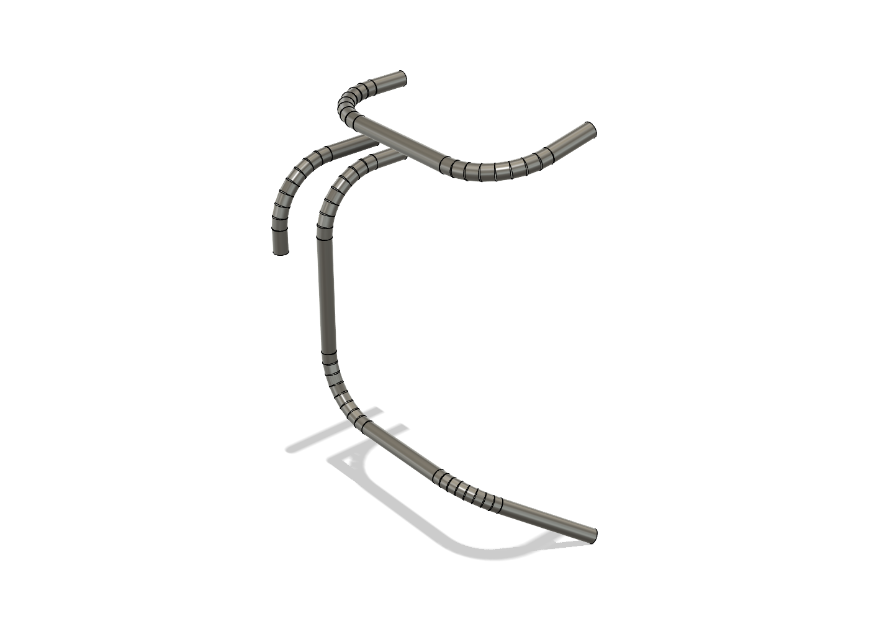
hardware/mechanical/exports/E07/subassemblies/BG50_Kabelbaum.png
