daniel-streetec/open_loud/results/battery/comparison.md

# Festivalversorgung: vorläufiger Vergleich

Kein USB-Verbrauch. Nutzungsstunden sind Szenarien, keine neue Anforderung. 75-90% nutzbare Energie angenommen; Akkukennlinien, Wandler und reale Lautstärke nicht gemessen. Standby zwischen Musikeinsätzen ausgeschaltet.

| Option | nominal Wh | Masse kg | Akku brutto EUR | Lieferbeobachtung |
|---|---:|---:|---:|---|
| tool_18V_4Ah | 72.0 | offen | 33.99 | sofort; single unit33.99, 31.99 is price for3! |
| EREMIT_12p8V_6Ah | 76.8 | 0.63 | 39.9 | 2-5 days, add-to-cart available |
| EREMIT_12p8V_18Ah | 230.4 | 1.9 | 99.9 | 2-5 days, add-to-cart available |
| EREMIT_12p8V_50Ah | 640.0 | 4.9 | 219.9 | in stock3-5 days |
| EVE_LF32_6S_DIY | 614.4 | offen | offen | NOT_VERIFIED, no current eligible complete consumer sourcing |
| user_previous_box_reference | 1280.0 | offen | offen | existing different box, not selected procurement |

Preisstand 2026-11-09; Lader, Anschlüsse, Halter, Sicherung, Versand und ggf. Wandler zusätzlich. Kein0%-PV-Preis für Lautsprecherbau. Werkzeugakku-Set enthält Lader. Quellen und Einschränkungen in data/battery_study.json.

| Musikstunden | Profil | benötigte nominale Energie mit angenommenem Wandler, Wh |
|---:|---|---:|
| 40 | normal | 220-739 |
| 40 | loud | 494-1705 |
| 60 | normal | 330-1109 |
| 60 | loud | 741-2557 |
| 80 | normal | 439-1479 |
| 80 | loud | 988-3410 |

Ein größerer12,8V-Fertigblock ist elektrisch und beim Einkauf einfacher als ein eigener Zellpack, liefert am jetzigen Verstärker direkt aber weniger Spannung. Ein Boost ergänzt Verluste, Ruhestrom, Spitzenstrom und einen zu prüfenden Wärmeweg. Ein6S-LFP-Konzept passt spannungsseitig eher zum18V-Entwurf, hat aber noch keine qualifizierte Endkunden-BOM. Eine einzelne3,2V-Zelle braucht bei gleicher Leistung sehr viel mehr Eingangsstrom und einen Wandler.

50Ah-Fertigblock passt nicht in den aktuellen Wartungsraum; externe Festivalversorgung oder neue Innenaufteilung erforderlich.18Ah passt nominal als Hülle eher, beweist aber keine mehrtägige Versorgung.100Ah-Erfahrung der alten Box wird nicht auf diesen Entwurf übertragen. Vor Versorgungswechsel Verkabelung und Schutz vollständig neu rechnen.
