daniel-streetec/open_loud/results/battery/runtime_scenarios.csv

option | path | profile | nominal_Wh | power_low_W | power_high_W | runtime_low_h | runtime_high_h | status
tool_18V_4Ah | direct | normal | 72 | 4.272727272727273 | 11.53076923076923 | 4.683122081387592 | 15.165957446808507 | unmeasured_energy_scenario; voltage cutoff/thermal/pack limits may reduce this
tool_18V_4Ah | boost | normal | 72 | 4.944268774703557 | 13.865610859728507 | 3.8945272982410337 | 13.106083619793747 | unmeasured_energy_scenario; voltage cutoff/thermal/pack limits may reduce this
tool_18V_4Ah | direct | loud | 72 | 9.954545454545453 | 26.915384615384614 | 2.006287510717348 | 6.509589041095891 | unmeasured_energy_scenario; voltage cutoff/thermal/pack limits may reduce this
tool_18V_4Ah | boost | loud | 72 | 11.120158102766798 | 31.965158371040722 | 1.6893393542176862 | 5.827255278310941 | unmeasured_energy_scenario; voltage cutoff/thermal/pack limits may reduce this
EREMIT_12p8V_6Ah | direct | normal | 76.8 | 4.272727272727273 | 11.53076923076923 | 4.995330220146764 | 16.17702127659574 | unmeasured_energy_scenario; voltage cutoff/thermal/pack limits may reduce this
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
