daniel-streetec/open_loud/results/battery/supply_acoustics.csv

rail_at_amplifier_V | frequency_Hz | max_SLP_ideal_2pi_1m_dB | voltage_limit_Vrms | first_limit | excursion_peak_mm | port_peak_m_s | power_real_W
12 | 20.0 | 71.05250944366607 | 3.998540729863832 | excursion | 4.62 | 3.7799938406753606 | 2.133043492768181
12 | 20.115461260034767 | 71.2645620941412 | 4.0027917593161115 | excursion | 4.62 | 3.8098978791241764 | 2.105038651156603
12 | 20.23158908519797 | 71.47693195209408 | 4.007272925304877 | excursion | 4.62 | 3.8401496138499085 | 2.077133258750632
12 | 20.348387323612094 | 71.68962234946761 | 4.011992548855451 | excursion | 4.62 | 3.870755318163548 | 2.0493430742239394
12 | 20.465859845615082 | 71.9026366978146 | 4.016959222458821 | excursion | 4.62 | 3.9017214220837446 | 2.0216846058865348
12 | 20.584010543888564 | 72.11597849012384 | 4.022181818168396 | excursion | 4.62 | 3.933054517239718 | 1.994175145270376
12 | 20.702843333586877 | 72.32965130269999 | 4.027669495896446 | excursion | 4.62 | 3.964761361957626 | 1.9668328023361348
12 | 20.82236215246679 | 72.54365879709918 | 4.0334317119132725 | excursion | 4.62 | 3.996848886538355 | 1.9396765423880447
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
