daniel-streetec/open_loud/results/acoustics.csv

concept | frequency_Hz | response_dB | SPL_1Vrms_2pi_1m_dB | SPL_limit_2pi_1m_dB | limit_Vrms | first_limit | rail_limit_Vrms | board_cap_Vrms | hub_limit_Vrms | port_limit_Vrms | thermal_proxy_limit_Vrms | uncapped_SPL_dB | x_peak_at_limit_mm | port_peak_at_limit_m_s | x_peak_at_rail_mm | port_peak_at_rail_m_s | real_power_at_limit_W | copper_power_at_limit_W | current_at_limit_Arms | Z_abs_ohm | Z_phase_deg
A0 | 20.0 | -32.035079425379074 | 59.014478960096646 | 71.05250944366607 | 3.998540729863832 | excursion | 11.455129855222069 | 14.142135623730951 | 3.998540729863832 | 17.982884436536597 | 37.67875260599733 | 71.05250944366607 | 4.62 | 3.7799938406753606 | 13.235503526539848 | 10.829030694492994 | 2.133043492768181 | 1.689278576010227 | 0.7503951350255915 | 5.328580294870203 | 44.69185593179907
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
