daniel-streetec/open_loud/results/dsp/E09/LF_protection_sweep.csv

highpass_Hz | frequency_Hz | voltage_Vrms | excursion_peak_mm | port_peak_m_s | copper_W | SPL_dB
35 | 10.0 | 0.06996884233297394 | 0.0801144693683525 | 0.028803431654821465 | 0.0013761659906632408 | 12.094722452638283
35 | 10.011519555381689 | 0.07029178948618005 | 0.08048852514788467 | 0.028973955558956224 | 0.001388265396160566 | 12.172030185862234
35 | 10.023052380778996 | 0.07061622709233686 | 0.08086433302346398 | 0.02914549755371272 | 0.001400469247791222 | 12.249346884718676
35 | 10.034598491478393 | 0.07094216204127485 | 0.0812419012322143 | 0.029318063785380977 | 0.0014127784233993774 | 12.326672548022387
35 | 10.046157902783952 | 0.07126960122501644 | 0.08162123801590368 | 0.029491660425531724 | 0.0014251938067161728 | 12.404007170952518
35 | 10.057730630017383 | 0.07159855159152775 | 0.08200235168250675 | 0.02966629369337938 | 0.0014377162895408539 | 12.481350751638576
35 | 10.069316688518041 | 0.07192902011100383 | 0.08238525056760505 | 0.02984196984203081 | 0.0014503467704482759 | 12.558703287003635
35 | 10.080916093642955 | 0.07226101378981731 | 0.08276994305037016 | 0.03001869516442624 | 0.0014630861553930638 | 12.636064774450766
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
