daniel-streetec/open_loud/results/energy.csv

concept | profile | audio_mean_low_W | audio_mean_high_W | pack_low_W | pack_high_W | runtime_low_h | runtime_high_h | status
A0 | background | 0.5 | 1.5 | 2.5681818181818183 | 4.607692307692307 | 12.587646076794659 | 25.309734513274336 | scenario_not_measurement
A0 | normal | 2 | 6 | 4.272727272727273 | 11.53076923076923 | 5.030020013342228 | 15.212765957446805 | scenario_not_measurement
A0 | loud | 7 | 16 | 9.954545454545453 | 26.915384615384614 | 2.1549014004001146 | 6.529680365296804 | scenario_not_measurement
A0 | near_max | 16 | 28 | 20.181818181818183 | 45.37692307692307 | 1.2781827428377692 | 3.2207207207207205 | scenario_not_measurement
A1 | background | 0.5 | 1.5 | 3.091501976284585 | 5.720814479638008 | 10.138416515067627 | 21.02537876366426 | scenario_not_measurement
A1 | normal | 2 | 6 | 4.944268774703557 | 13.865610859728507 | 4.183010801814444 | 13.146534495163483 | scenario_not_measurement
A1 | loud | 7 | 16 | 11.120158102766798 | 31.965158371040722 | 1.8144756026782556 | 5.845240634108197 | scenario_not_measurement
A1 | near_max | 16 | 28 | 22.236758893280633 | 53.68461538461538 | 1.0803840091703685 | 2.9230878614977156 | scenario_not_measurement
