daniel-streetec/open_loud/results/integration/harness.csv

id | route_length_m | cut_length_m | conductor_mm2_each | conductors | jacket_OD_m_target | loop_R_60C_ohm | stress_A | drop_at_stress_V | loss_at_stress_W | status
power | 0.19475602351484636 | 0.3239694270420733 | 1.5 | 2 | 0.0065 | 0.008747606489372037 | 8 | 0.0699808519149763 | 0.5598468153198104 | candidate_not_ampacity_or_voltage_source_certification
lf | 0.4391834926967518 | 0.6050610166012644 | 1.0 | 2 | 0.005 | 0.024506181294384415 | 3.5355339059327378 | 0.08664243487123073 | 0.3063272661798052 | candidate_not_ampacity_or_voltage_source_certification
hf | 0.7703035112467825 | 0.9858490379337999 | 0.75 | 2 | 0.005 | 0.05323847697919302 | 1.5811388300841898 | 0.08417742320634532 | 0.13309619244798257 | candidate_not_ampacity_or_voltage_source_certification
