daniel-streetec/open_loud/results/dsp/E09/LF_protection.pdf

60

80

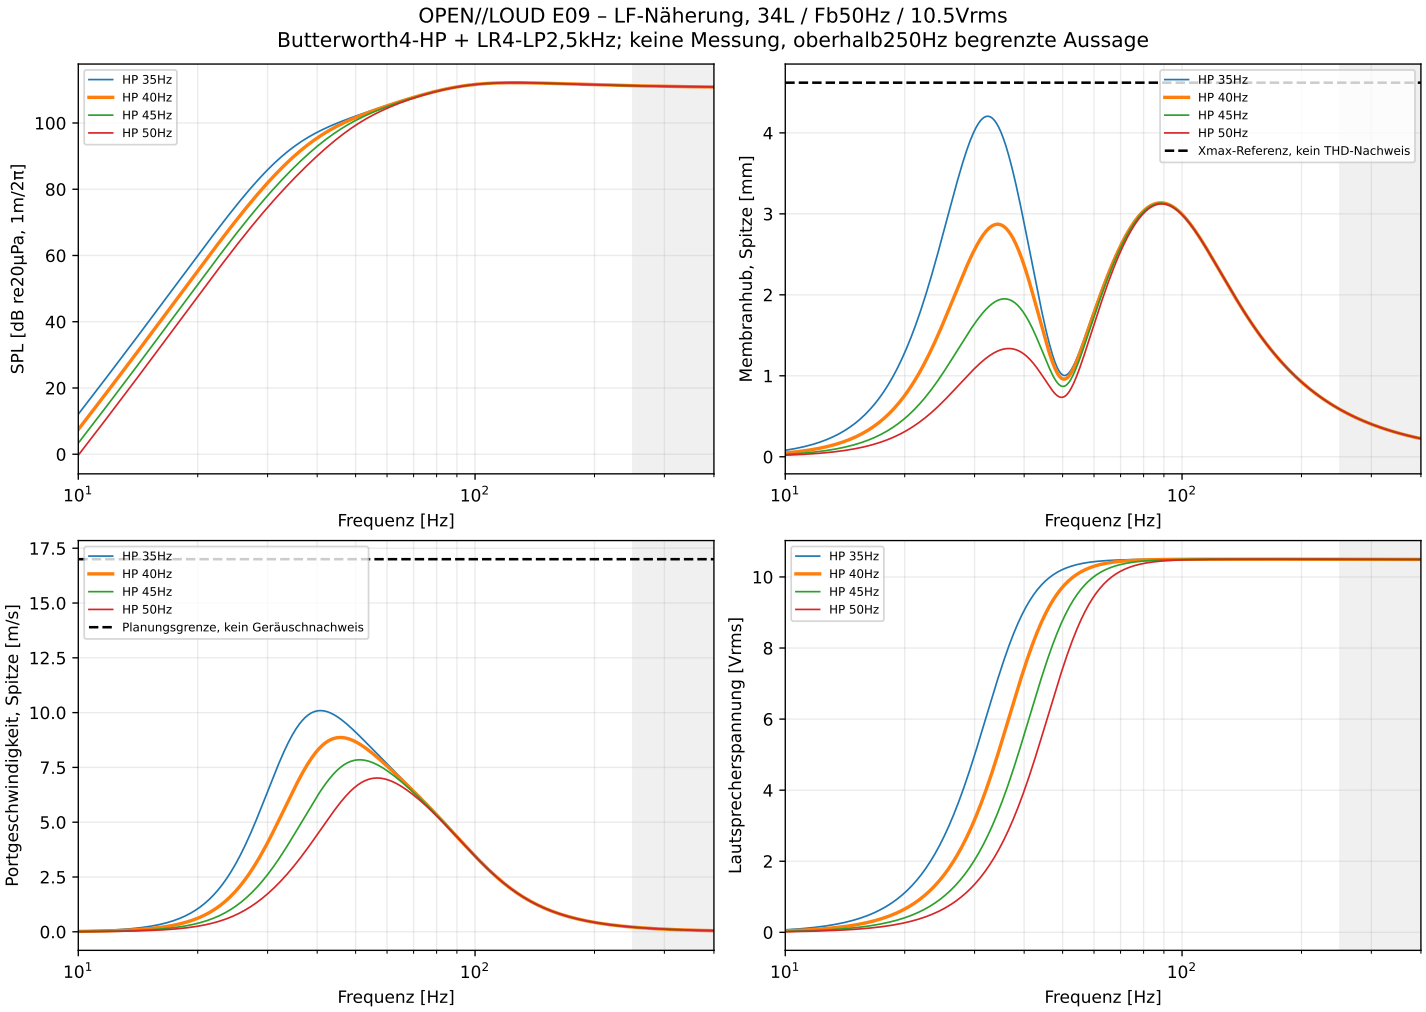
[picture p60: page 1]
Frequenz [Hz]; SPL [dB re20µPa, 1m/2; Portgeschwindigkeit, Spitze [m/s]; Lautsprecherspannung [Vrms]

OPEN//LOUD E09 – LF-Näherung, 34L / Fb50Hz / 10.5Vrms

Butterworth4-HP + LR4-LP2,5kHz; keine Messung, oberhalb250Hz begrenzte Aussage

Membranhub, Spitze [mm]

Xmax-Referenz, kein THD-Nachweis

HP 35Hz
HP 40Hz HP 45Hz

HP 50Hz Planungsgrenze, kein Geräuschnachweis
