daniel-streetec/open_loud/hardware/mechanical/drawings/E05/OPEN_LOUD_E05_review_drawings.pdf

# OPEN//LOUD | Assembly / exploded review

## Virtual exploded layout

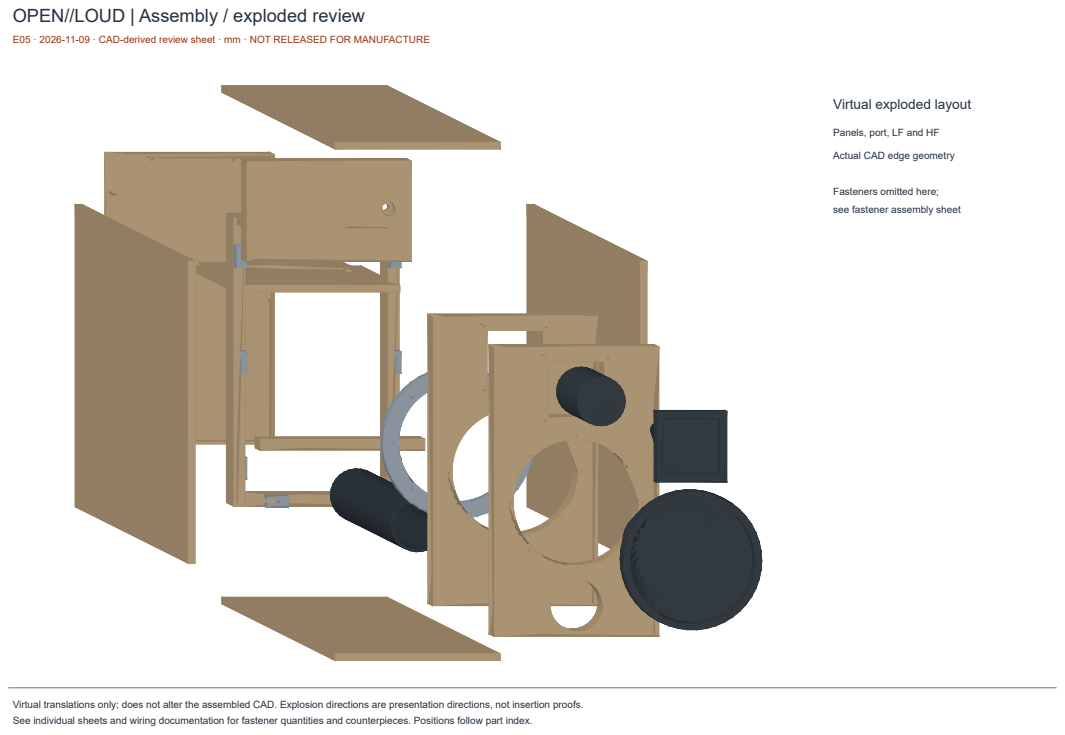
[picture p61: page 1]

E05 · 2026-11-09 · CAD-derived review sheet · mm · NOT RELEASED FOR MANUFACTURE

Panels, port, LF and HF

Actual CAD edge geometry

Fasteners omitted here;
see fastener assembly sheet

Virtual translations only; does not alter the assembled CAD. Explosion directions are presentation directions, not insertion proofs.
See individual sheets and wiring documentation for fastener quantities and counterpieces. Positions follow part index.

# OPEN//LOUD | Assembly / orthographic

FRONT X/Y | SIDE Z/Y | TOP X/Z

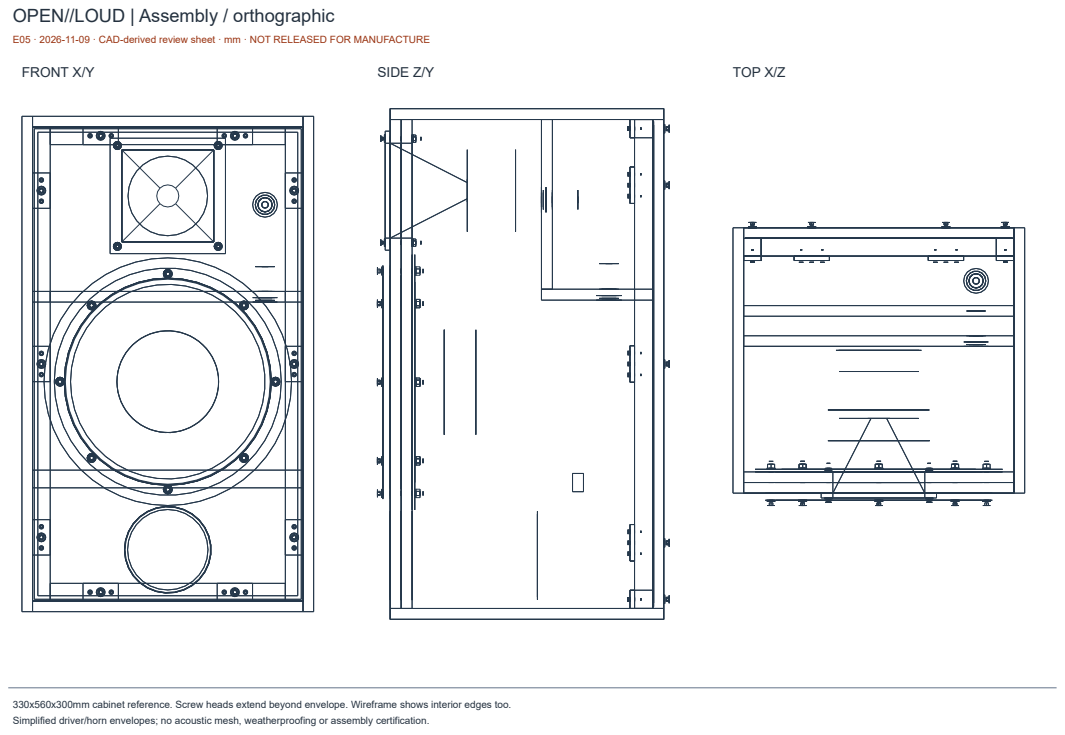
[picture p62: page 2]

330x560x300mm cabinet reference. Screw heads extend beyond envelope. Wireframe shows interior edges too.
Simplified driver/horn envelopes; no acoustic mesh, weatherproofing or assembly certification.

# OPEN//LOUD | Fastener assemblies / nominal stacks

## LF M5x45 / 8x

1
5mm
1. head: 5 mm

2
1mm
2. washer: 1 mm

3
8mm
3. LF flange: 8 mm

4
24mm
4. baffle: 24 mm
5
3mm
5. steel ring: 3 mm

6
1mm
6. washer: 1 mm

7
4.7mm
7. M5 nut: 4.7 mm

## Horn M4x40 / 4x

1
4mm
1. head: 4 mm

2
0.8mm
2. washer: 0.8 mm

3
5.5mm
3. horn flange: 5.5 mm

4
24mm
4. baffle: 24 mm
5
0.8mm
5. washer: 0.8 mm

6
3.2mm
6. M4 nut: 3.2 mm

## Rear M5x40 / 10x

1
5mm
1. head: 5 mm

2
1mm
2. washer: 1 mm

3
12mm
3. rear panel: 12 mm

4
20mm
4. cleat: 20 mm
5
5mm
5. M5 tapped plate: 5 mm

Schematic layer stacks, not geometric scale. Standard nuts/threaded plates receive all metric threads; no metric thread cut in wood. LF ring/nut access tested geometrically. Horn nut service access, actual gaskets/tolerances and tightening torque remain open.

# OPEN//LOUD | 01 / Side_left

## POSITION 01

Quantity: 1

Material:

birch_plywood_candidate

Nominal blank [mm]:

560.00 x 300.00 x 12.00

Coordinate axes: Y,Z

All CAD edges visible

Pockets may overlap in projection

CAD datum bounds (global XYZ, mm):

X: 0.000 ... 12.000 | Y: 0.000 ... 560.000 | Z: 0.000 ... 300.000

Geometry: own E05 CAD; chord tolerance0.3mm. Blank dimensions are geometric envelopes, not toleranced machining dimensions. Use checked STEP/DXF and E05 pocket definitions together. Fastener counterpieces, seals and tool access require remaining review. Unspecified tolerances/finish/adhesive joints: OPEN. Do not treat this review sheet as a released part drawing.

# OPEN//LOUD | 02 / Side_right

## POSITION 02

Quantity: 1

Material:

birch_plywood_candidate

Nominal blank [mm]:

560.00 x 300.00 x 12.00

Coordinate axes: Y,Z

All CAD edges visible

Pockets may overlap in projection

CAD datum bounds (global XYZ, mm):

X: 318.000 ... 330.000 | Y: 0.000 ... 560.000 | Z: 0.000 ... 300.000

# OPEN//LOUD | 03 / Bottom

## POSITION 03

Quantity: 1

Material:

birch_plywood_candidate

Nominal blank [mm]:

306.00 x 300.00 x 12.00

Coordinate axes: X,Z

All CAD edges visible

Pockets may overlap in projection

CAD datum bounds (global XYZ, mm):

X: 12.000 ... 318.000 | Y: 0.000 ... 12.000 | Z: 0.000 ... 300.000

# OPEN//LOUD | 04 / Top

## POSITION 04

Quantity: 1

Material:

birch_plywood_candidate

Nominal blank [mm]:

306.00 x 300.00 x 12.00

Coordinate axes: X,Z

All CAD edges visible

Pockets may overlap in projection

CAD datum bounds (global XYZ, mm):

X: 12.000 ... 318.000 | Y: 548.000 ... 560.000 | Z: 0.000 ... 300.000

# OPEN//LOUD | 05 / Baffle

## POSITION 05

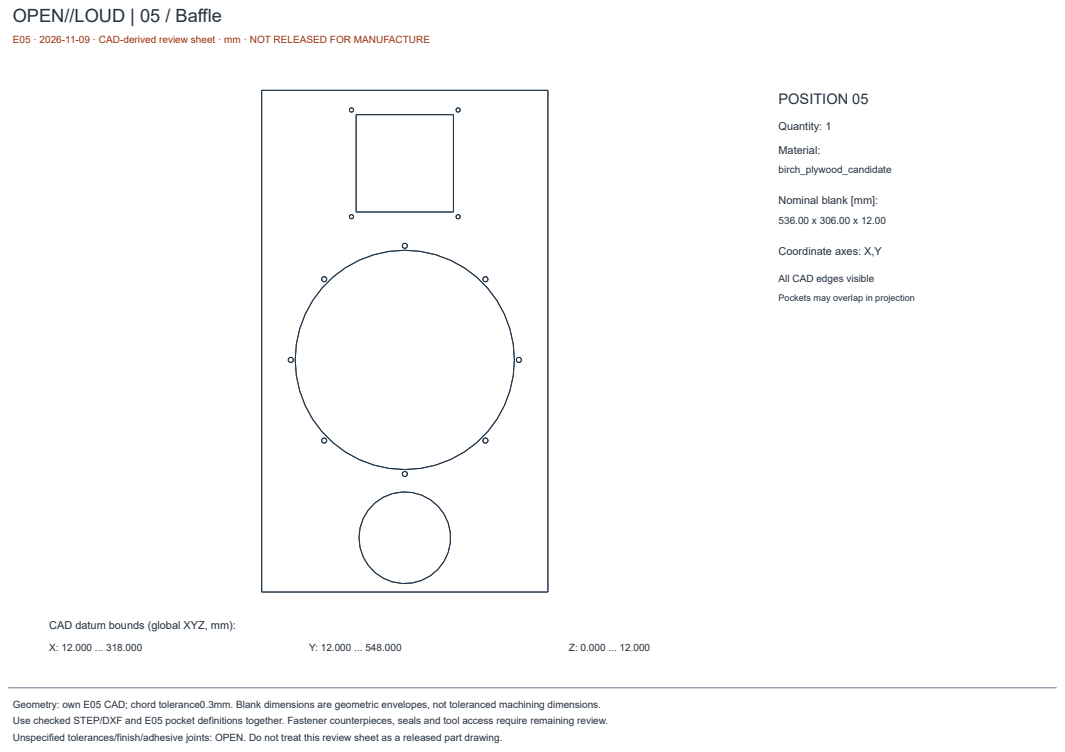
[picture p63: page 8]
Quantity: 1; Material:; birch_plywood_candidate; Coordinate axes: X,Y

Nominal blank [mm]:

All CAD edges visible

Pockets may overlap in projection

CAD datum bounds (global XYZ, mm):

# OPEN//LOUD | 06 / Rear_removable

## POSITION 06

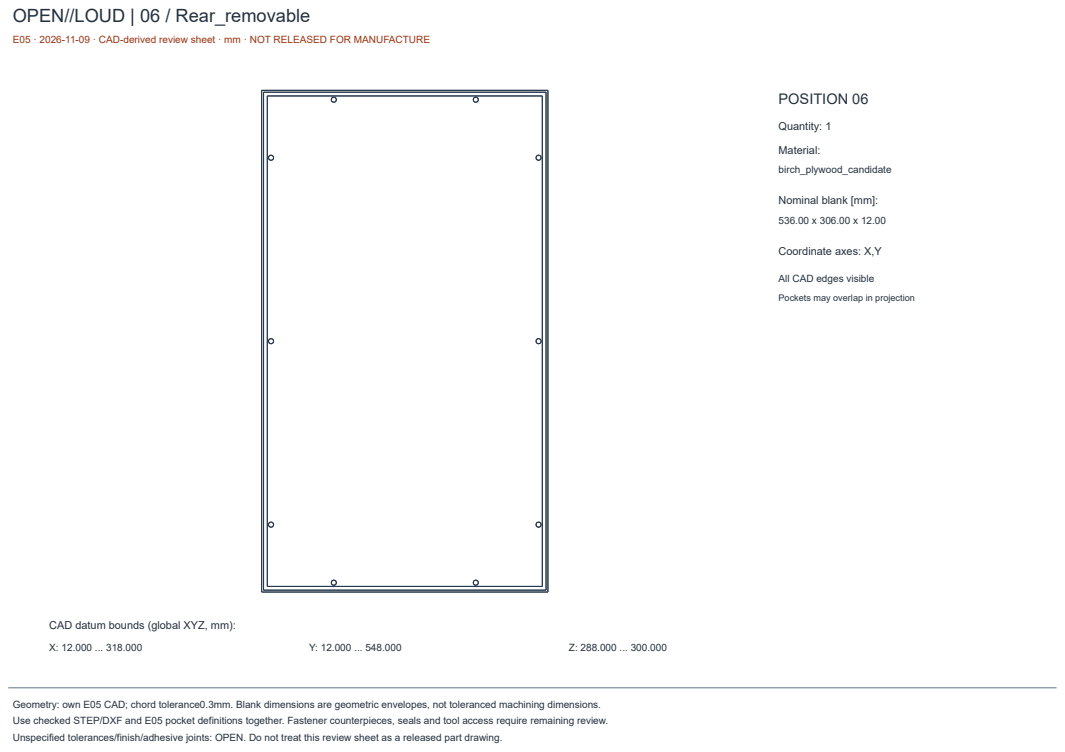
[picture p64: page 9]
Quantity: 1; Material:; birch_plywood_candidate; Coordinate axes: X,Y

Nominal blank [mm]:

All CAD edges visible

Pockets may overlap in projection

CAD datum bounds (global XYZ, mm):

# OPEN//LOUD | 07 / Baffle_inner_lamination

## POSITION 07

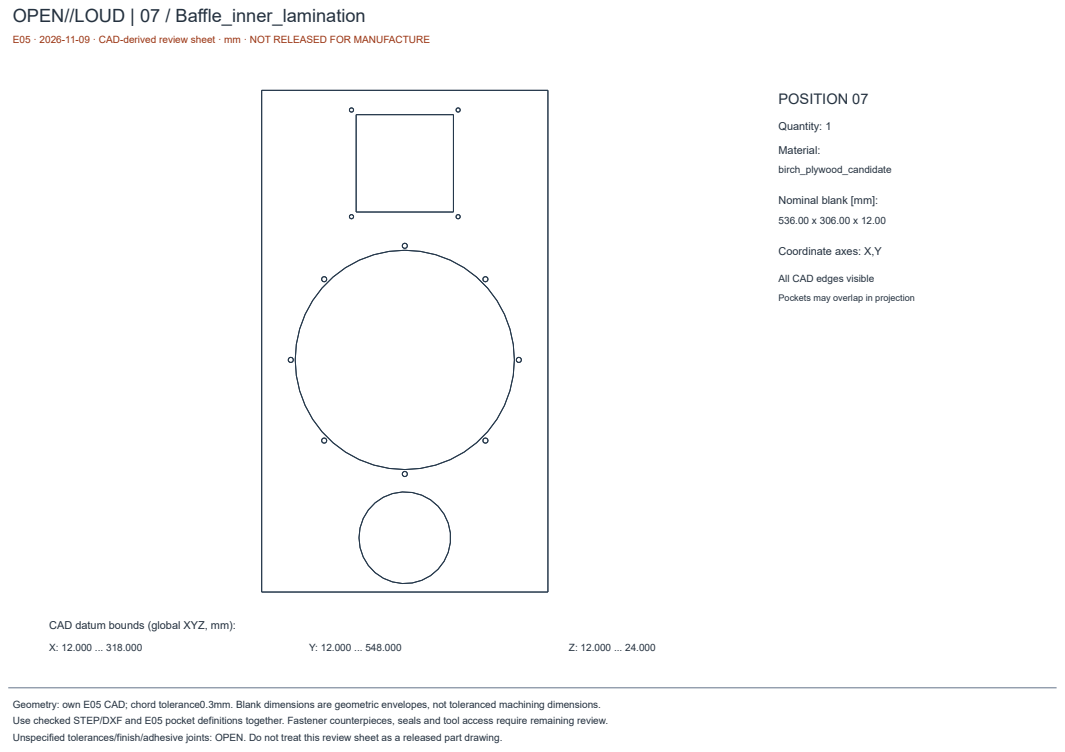
[picture p65: page 10]
Quantity: 1; Material:; birch_plywood_candidate; Coordinate axes: X,Y

Nominal blank [mm]:

All CAD edges visible

Pockets may overlap in projection

CAD datum bounds (global XYZ, mm):

# OPEN//LOUD | 08 / LF_steel_backing_ring_candidate

## POSITION 08

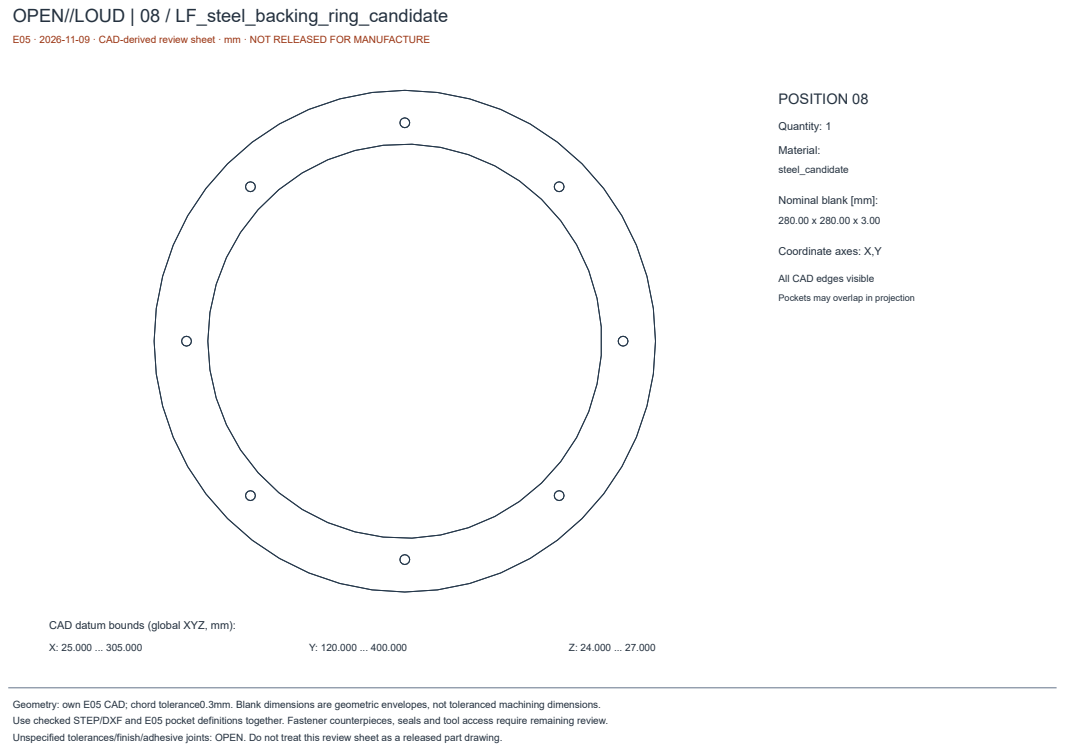
[picture p66: page 11]
Quantity: 1; Material:; steel_candidate; Coordinate axes: X,Y

Nominal blank [mm]:

All CAD edges visible

Pockets may overlap in projection

CAD datum bounds (global XYZ, mm):

# OPEN//LOUD | 09 / Rear_cleat_left

## POSITION 09

Quantity: 1

Material:

birch_plywood_candidate

Nominal blank [mm]:

536.00 x 20.00 x 20.00

Coordinate axes: Y,Z

All CAD edges visible

Pockets may overlap in projection

CAD datum bounds (global XYZ, mm):

X: 12.000 ... 32.000 | Y: 12.000 ... 548.000 | Z: 268.000 ... 288.000

# OPEN//LOUD | 10 / Rear_cleat_right

## POSITION 10

Quantity: 1

Material:

birch_plywood_candidate

Nominal blank [mm]:

536.00 x 20.00 x 20.00

Coordinate axes: Y,Z

All CAD edges visible

Pockets may overlap in projection

CAD datum bounds (global XYZ, mm):

X: 298.000 ... 318.000 | Y: 12.000 ... 548.000 | Z: 268.000 ... 288.000

# OPEN//LOUD | 11 / Rear_cleat_bottom

## POSITION 11

Quantity: 1

Material:

birch_plywood_candidate

Nominal blank [mm]:

266.00 x 20.00 x 20.00

Coordinate axes: X,Z

All CAD edges visible

Pockets may overlap in projection

CAD datum bounds (global XYZ, mm):

X: 32.000 ... 298.000 | Y: 12.000 ... 32.000 | Z: 268.000 ... 288.000

# OPEN//LOUD | 12 / Rear_cleat_top

## POSITION 12

Quantity: 1

Material:

birch_plywood_candidate

Nominal blank [mm]:

266.00 x 20.00 x 20.00

Coordinate axes: X,Z

All CAD edges visible

Pockets may overlap in projection

CAD datum bounds (global XYZ, mm):

X: 32.000 ... 298.000 | Y: 528.000 ... 548.000 | Z: 268.000 ... 288.000

# OPEN//LOUD | 13 / Service_partition

## POSITION 13

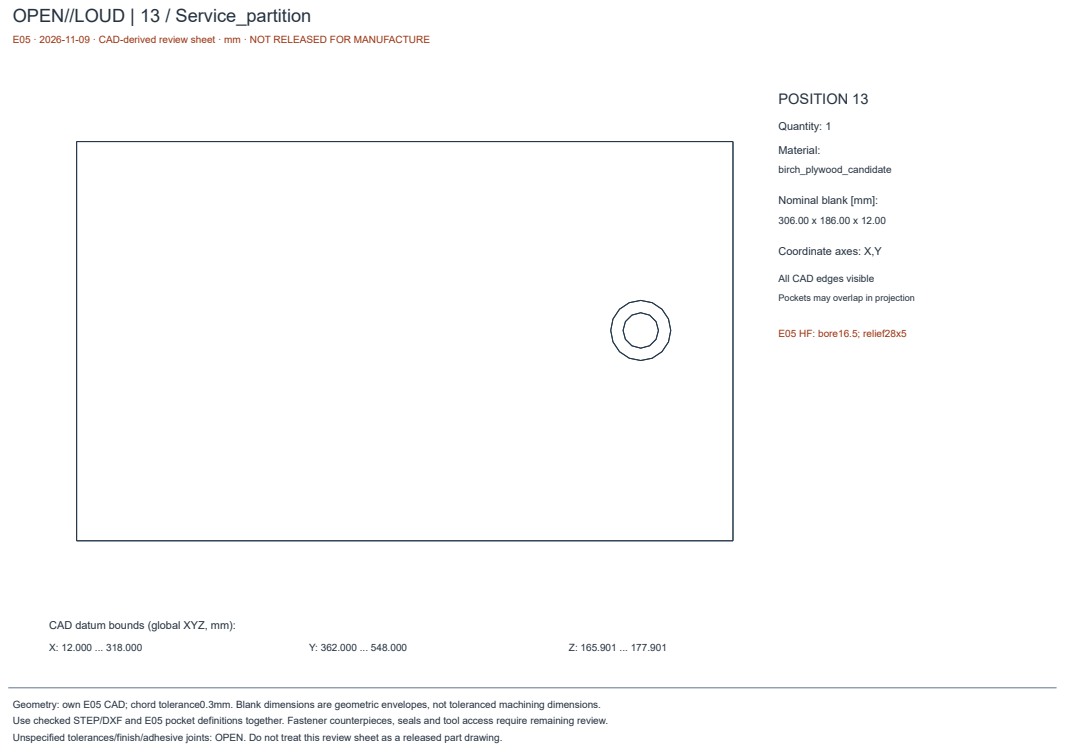
[picture p67: page 16]
Quantity: 1; Material:; birch_plywood_candidate; Coordinate axes: X,Y; E05 HF: bore16.5; relief28x5

Nominal blank [mm]:

All CAD edges visible

Pockets may overlap in projection

CAD datum bounds (global XYZ, mm):

# OPEN//LOUD | 14 / Service_floor

## POSITION 14

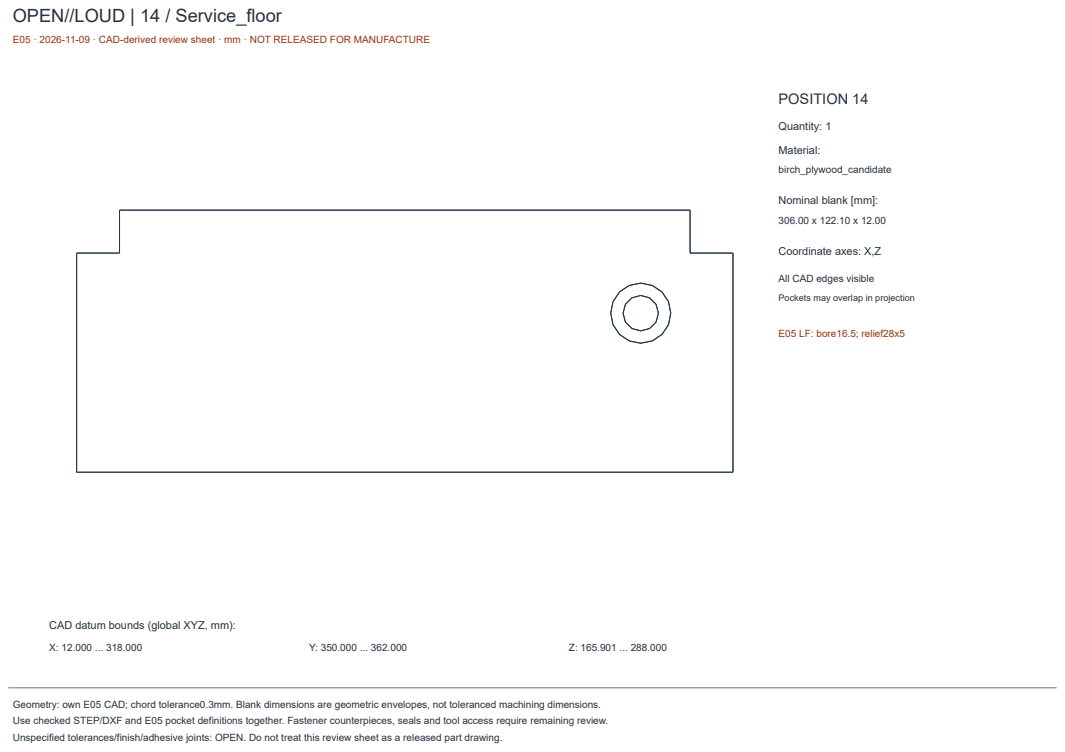
[picture p68: page 17]
Quantity: 1; Material:; birch_plywood_candidate; Coordinate axes: X,Z; E05 LF: bore16.5; relief28x5

Nominal blank [mm]:

All CAD edges visible

Pockets may overlap in projection

CAD datum bounds (global XYZ, mm):

# OPEN//LOUD | 15 / Brace_lower

## POSITION 15

Quantity: 1

Material:

birch_plywood_candidate

Nominal blank [mm]:

306.00 x 20.00 x 12.00

Coordinate axes: X,Y

All CAD edges visible

Pockets may overlap in projection

CAD datum bounds (global XYZ, mm):

X: 12.000 ... 318.000 | Y: 140.000 ... 160.000 | Z: 200.000 ... 212.000

# OPEN//LOUD | 16 / Rear_thread_plate_left_0.15

## POSITION 16

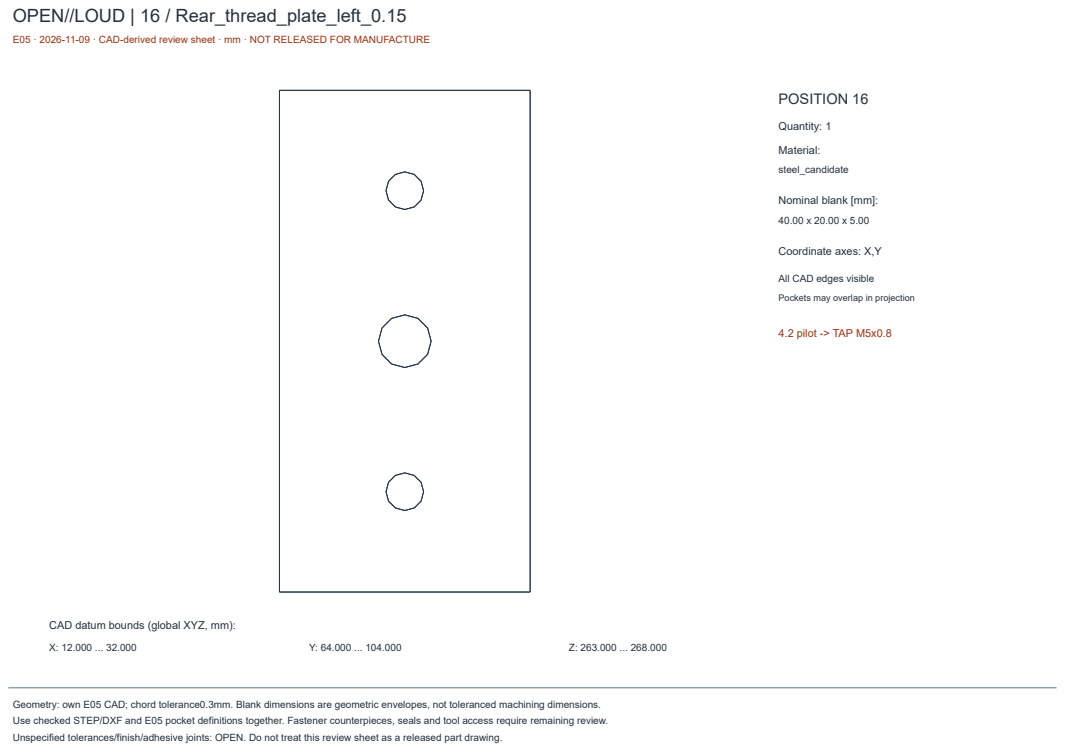
[picture p69: page 19]
Quantity: 1; Material:; steel_candidate; Coordinate axes: X,Y; 4.2 pilot -> TAP M5x0.8

Nominal blank [mm]:

All CAD edges visible

Pockets may overlap in projection

CAD datum bounds (global XYZ, mm):

# OPEN//LOUD | 17 / Rear_thread_plate_left_0.5

## POSITION 17

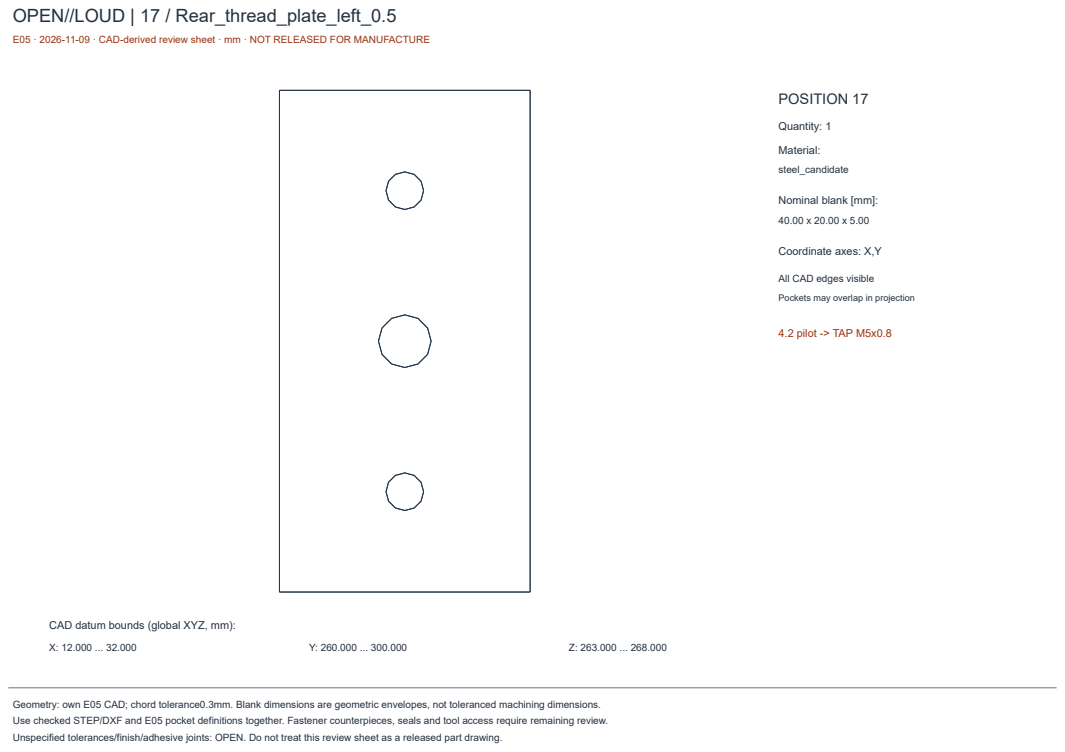
[picture p70: page 20]
Quantity: 1; Material:; steel_candidate; Coordinate axes: X,Y; 4.2 pilot -> TAP M5x0.8

Nominal blank [mm]:

All CAD edges visible

Pockets may overlap in projection

CAD datum bounds (global XYZ, mm):

# OPEN//LOUD | 18 / Rear_thread_plate_left_0.85

## POSITION 18

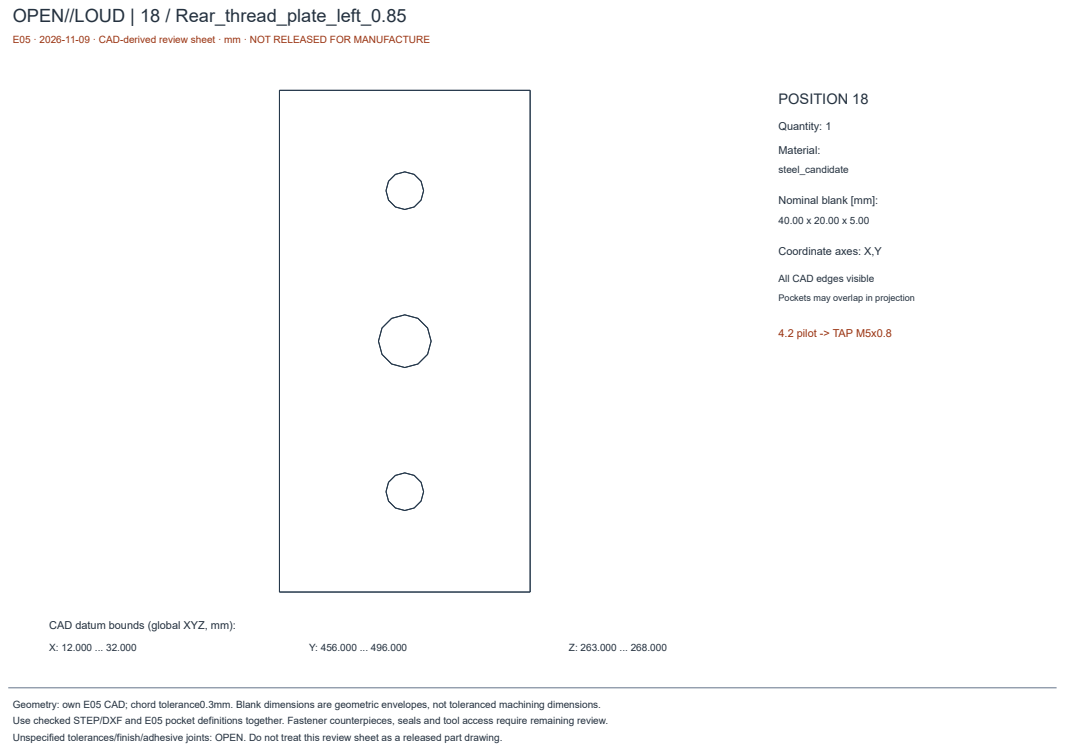
[picture p71: page 21]
Quantity: 1; Material:; steel_candidate; Coordinate axes: X,Y; 4.2 pilot -> TAP M5x0.8

Nominal blank [mm]:

All CAD edges visible

Pockets may overlap in projection

CAD datum bounds (global XYZ, mm):

# OPEN//LOUD | 19 / Rear_thread_plate_right_0.15

## POSITION 19

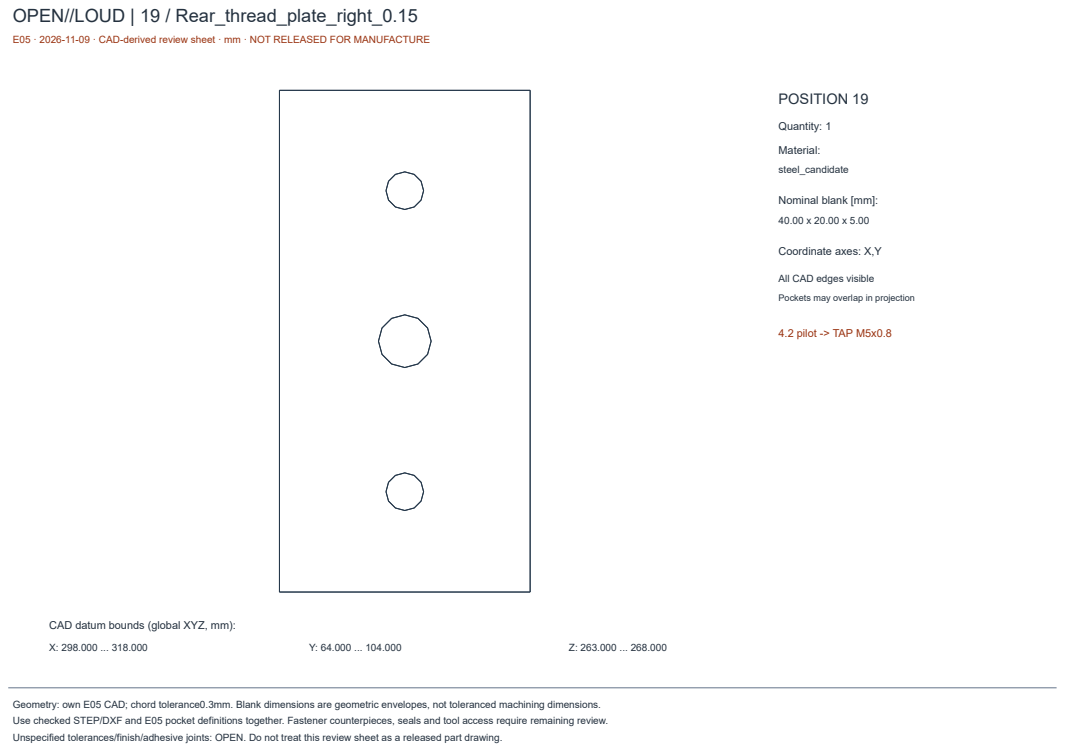
[picture p72: page 22]
Quantity: 1; Material:; steel_candidate; Coordinate axes: X,Y; 4.2 pilot -> TAP M5x0.8

Nominal blank [mm]:

All CAD edges visible

Pockets may overlap in projection

CAD datum bounds (global XYZ, mm):

# OPEN//LOUD | 20 / Rear_thread_plate_right_0.5

## POSITION 20

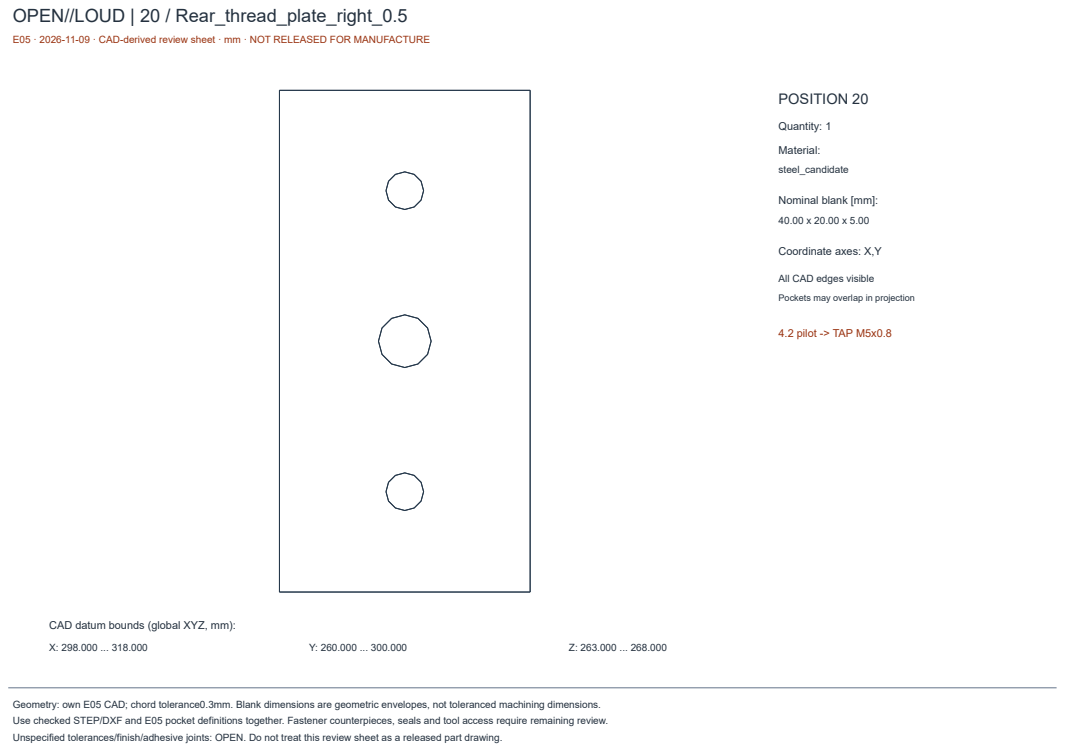
[picture p73: page 23]
Quantity: 1; Material:; steel_candidate; Coordinate axes: X,Y; 4.2 pilot -> TAP M5x0.8

Nominal blank [mm]:

All CAD edges visible

Pockets may overlap in projection

CAD datum bounds (global XYZ, mm):

# OPEN//LOUD | 21 / Rear_thread_plate_right_0.85

## POSITION 21

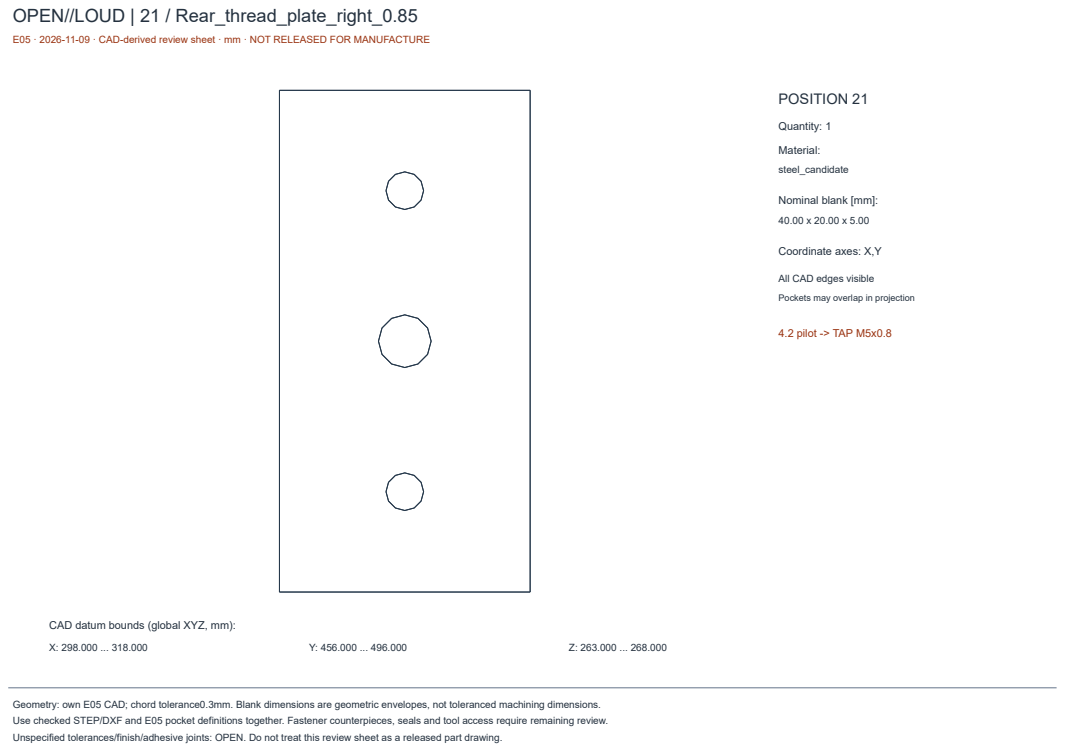
[picture p74: page 24]
Quantity: 1; Material:; steel_candidate; Coordinate axes: X,Y; 4.2 pilot -> TAP M5x0.8

Nominal blank [mm]:

All CAD edges visible

Pockets may overlap in projection

CAD datum bounds (global XYZ, mm):

# OPEN//LOUD | 22 / Rear_thread_plate_bottom_0.27

## POSITION 22

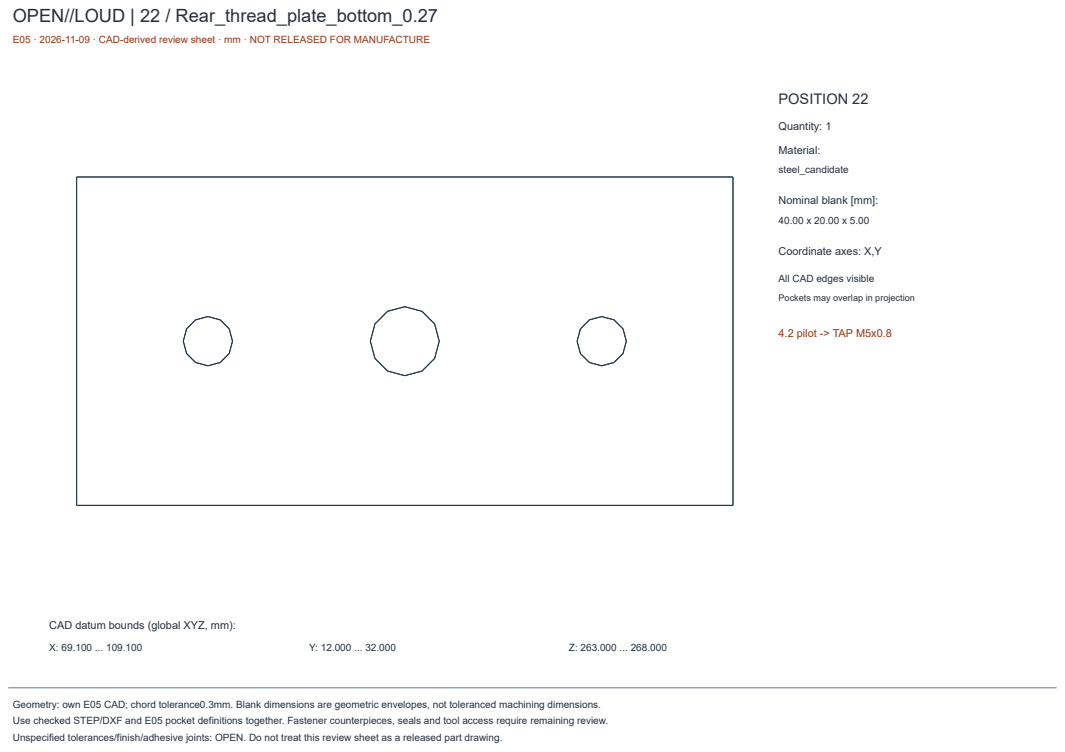
[picture p75: page 25]
Quantity: 1; Material:; steel_candidate; Coordinate axes: X,Y; 4.2 pilot -> TAP M5x0.8

Nominal blank [mm]:

All CAD edges visible

Pockets may overlap in projection

CAD datum bounds (global XYZ, mm):

# OPEN//LOUD | 23 / Rear_thread_plate_bottom_0.73

## POSITION 23

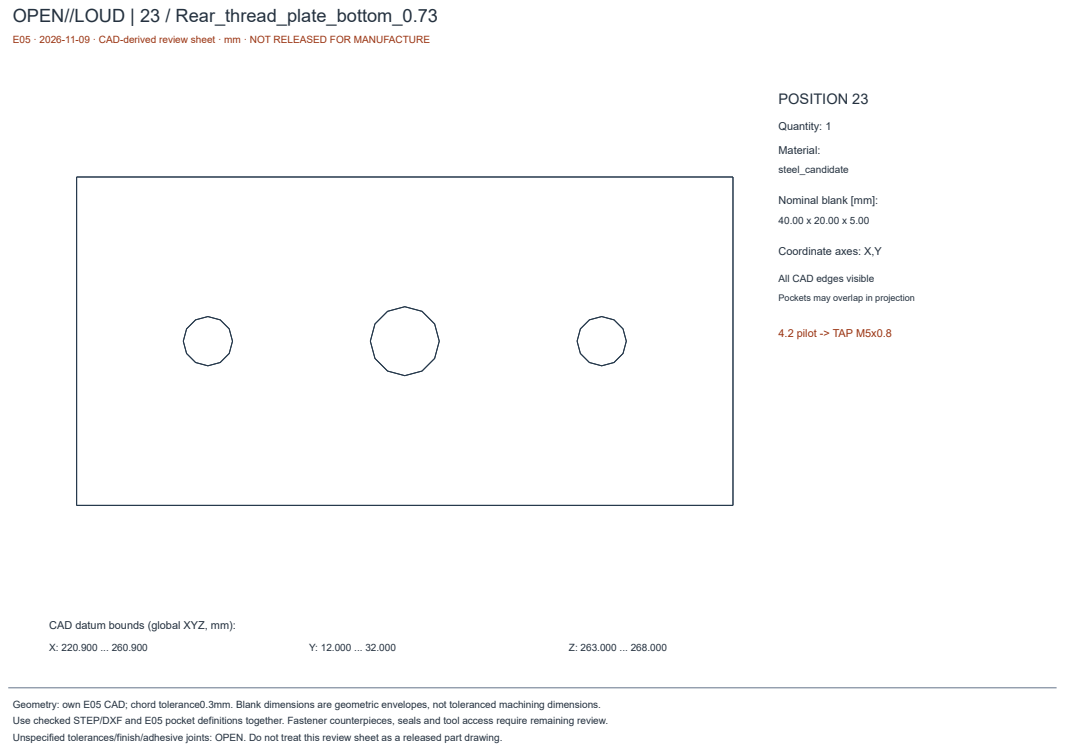
[picture p76: page 26]
Quantity: 1; Material:; steel_candidate; Coordinate axes: X,Y; 4.2 pilot -> TAP M5x0.8

Nominal blank [mm]:

All CAD edges visible

Pockets may overlap in projection

CAD datum bounds (global XYZ, mm):

# OPEN//LOUD | 24 / Rear_thread_plate_top_0.27

## POSITION 24

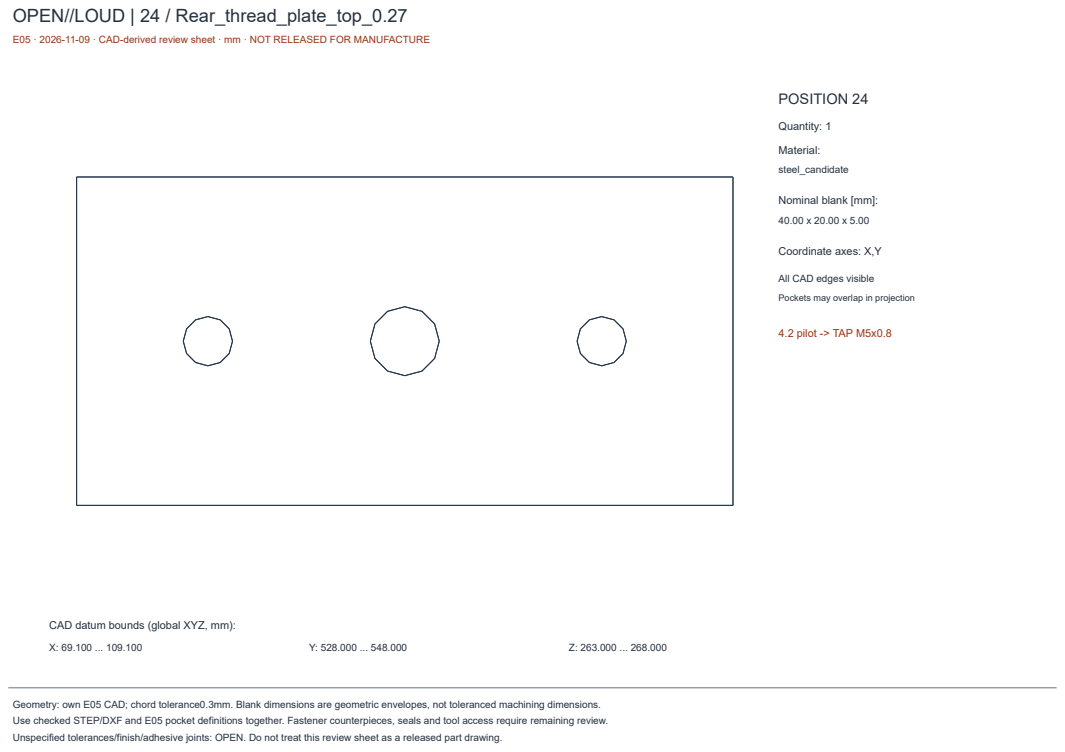
[picture p77: page 27]
Quantity: 1; Material:; steel_candidate; Coordinate axes: X,Y; 4.2 pilot -> TAP M5x0.8

Nominal blank [mm]:

All CAD edges visible

Pockets may overlap in projection

CAD datum bounds (global XYZ, mm):

# OPEN//LOUD | 25 / Rear_thread_plate_top_0.73

## POSITION 25

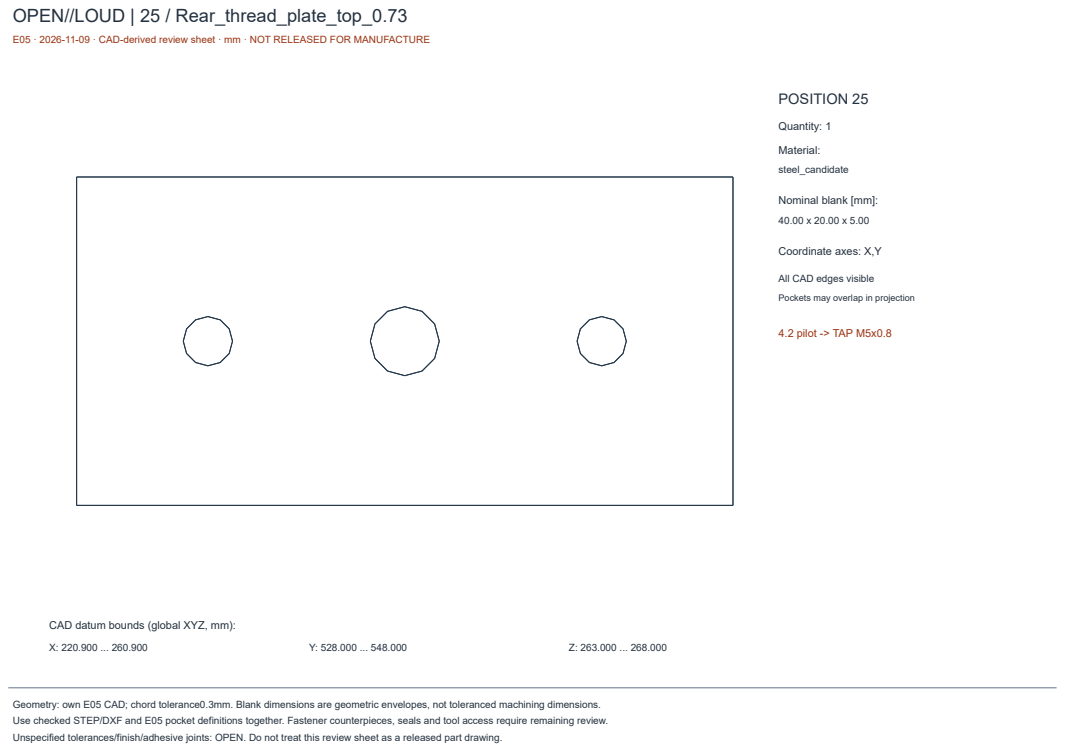
[picture p78: page 28]
Quantity: 1; Material:; steel_candidate; Coordinate axes: X,Y; 4.2 pilot -> TAP M5x0.8

Nominal blank [mm]:

All CAD edges visible

Pockets may overlap in projection

CAD datum bounds (global XYZ, mm):
