daniel-streetec/open_loud/hardware/mechanical/drawings/E09/charge_bracket_review.pdf

# OPEN//LOUD – E09 interner Ladebuchsenhalter

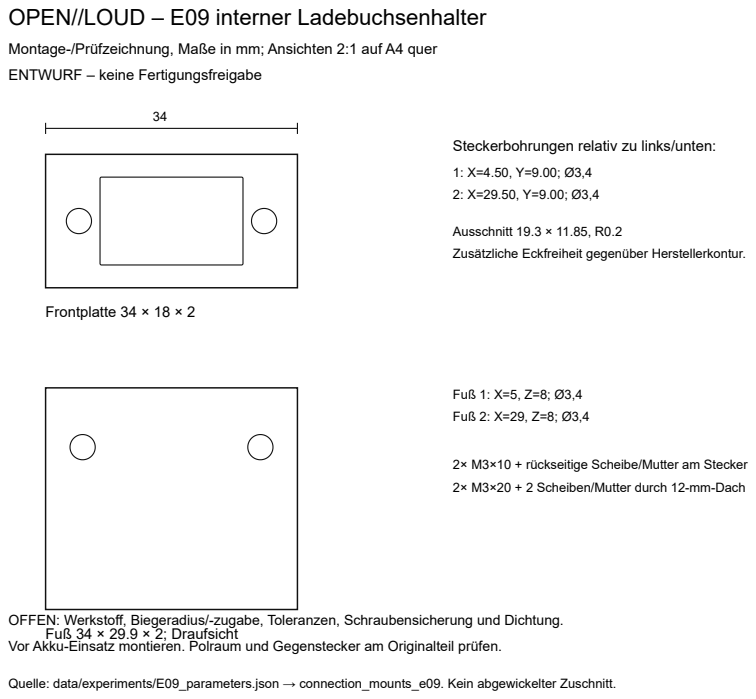
[picture p79: page 1]
Frontplatte 34 × 18 × 2; Fuß 1: X=5, Z=8; Ø3,4; Fuß 2: X=29, Z=8; Ø3,4

Montage-/Prüfzeichnung, Maße in mm; Ansichten 2:1 auf A4 quer
ENTWURF – keine Fertigungsfreigabe

Steckerbohrungen relativ zu links/unten:

Ausschnitt 19.3 × 11.85, R0.2
Zusätzliche Eckfreiheit gegenüber Herstellerkontur.

2× M3×10 + rückseitige Scheibe/Mutter am Stecker
2× M3×20 + 2 Scheiben/Mutter durch 12-mm-Dach

OFFEN: Werkstoff, Biegeradius/-zugabe, Toleranzen, Schraubensicherung und Dichtung.
Fuß 34 × 29.9 × 2; Draufsicht
Vor Akku-Einsatz montieren. Polraum und Gegenstecker am Originalteil prüfen.

Quelle: data/experiments/E09_parameters.json → connection_mounts_e09. Kein abgewickelter Zuschnitt.
