daniel-streetec/open_loud/(commit log)

2026-11-09 Build reproducible OPEN LOUD E05 engineering baseline and overnight handoff
    [Baffle_E02_DRAFT.dxf, Baffle_E03_DRAFT.dxf, Baffle_inner_lamination_E03_DRAFT.dxf, Bottom_E02_DRAFT.dxf, Bottom_E03_DRAFT.dxf, Brace_lower_E02_DRAFT.dxf, Brace_lower_E03_DRAFT.dxf, LF_steel_backing_ring_candidate_E03_DRAFT.dxf]
2026-11-10 Save paused E06 electronics work in progress and stop automatic continuation
    [E06_tray_112x90x2_DRAFT.dxf, E06_tray_support_M3_0.dxf, E06_tray_support_M3_1.dxf, E06_tray_support_M3_2.dxf, E06_tray_support_M3_3.dxf, OPEN_LOUD_A0_E06.f3d, OPEN_LOUD_A0_E06.step, OPEN_LOUD_A0_E06_PAUSED.f3d]
2026-11-10 Organize E07 into verified serviceable subassemblies with separate STEP exports and BOM
    [BG10_Gehaeuse.step, BG20_Frontbestueckung.step, BG30_Service_Rueckwand.step, BG40_Elektronikmodul.step, BG50_Kabelbaum.step, OPEN_LOUD_A0_E07.f3d, OPEN_LOUD_A0_E07.step, assembly_bom.csv]
2026-11-10 Develop E08 LFP supply packaging, cable routes and reproducible power checks
    [Baffle_E08_DRAFT.dxf, OPEN_LOUD_A0_E08.f3d, OPEN_LOUD_A0_E08.step, OPEN_LOUD_A0_E08_checkpoint.f3d, OPEN_LOUD_A0_E08_checkpoint.step, runtime.csv]
2026-11-10 Verify E08 mounts and assemblies; identify battery service clash and validate E09 packing study
    [OPEN_LOUD_A0_E08_checkpoint.f3d, OPEN_LOUD_A0_E08_checkpoint.step, assembly_parts.csv, modeled_bom.csv]
2026-11-10 Build and verify serviceable E09 battery layout with conservative supply and DSP studies
    [Baffle_E09_DRAFT.dxf, LF_protection_sweep.csv, OPEN_LOUD_A0_E09.f3d, OPEN_LOUD_A0_E09.step, OPEN_LOUD_A0_E09_checkpoint.f3d, OPEN_LOUD_A0_E09_checkpoint.step, assembly_parts.csv, modeled_bom.csv]
